2AMLogic/sky130-comparator/README.md

# sky130-comparator

A dynamic latched comparator on SkyWater sky130 on
[SkyWater sky130](https://github.com/google/skywater-pdk), a 130 nm open CMOS PDK — designed by AI agents driving
[klayout-tools](https://github.com/2AMLogic/klayout-tools) and the
open-source xschem + ngspice flow.

fleet burndown

**Status:** designed (`design/comparator.sch`), laid out
(`layout/comparator.gds`) with DRC/LVS evidence, and four of the five spec rows
are ratified; Supply / power remains DRAFT / OPEN. The current frontier is the
post-layout re-measurement campaign
[#125](https://github.com/2AMLogic/sky130-comparator/issues/125), blocked on
the execution route [#127](https://github.com/2AMLogic/sky130-comparator/issues/127).
See the [decision records](spec/decision-records/) (latest ratified:
[DR-006](spec/decision-records/DR-006-post-layout-noise-headroom-reopened.md)),
[`manifests/design-evidence-tiers.md`](manifests/design-evidence-tiers.md), and
[`WORK_PLAN.md`](WORK_PLAN.md); figures live there, not here.

**For integrators:** [`spec/consumers.md`](spec/consumers.md) is the dated
consumer-compatibility record (last refreshed 2026-10-10 against the
DR-004 static-preamp topology and DR-005 ratifications). It distinguishes
ratified bounds, schematic results, and historical post-layout results; no
compatibility claim there covers the current layout geometry, whose
re-measurement is #125.

**Built agent-native.** Every specification, decision record, testbench, and
line of documentation here is produced by AI agents working from a ratified
spec and an append-only evidence trail — not human-authored work that agents
merely assisted with. Verification is the product: every claim traces to a
recorded result under PVT corners. Where the agents hit friction with the
open-source tooling — most often
[klayout-tools](https://github.com/2AMLogic/klayout-tools) — that friction is
filed as a public issue against the tool itself, so the fix benefits everyone
using this PDK, not just this repo.

## Why this block, on this PDK

The sky130 leg of the comparator twin set (see sg13g2-comparator for the
program). sky130-sar-adc embeds a comparator this repo characterizes
standalone; at 1.8 V the StrongARM's stacked devices are headroom-tight,
and the regeneration-speed vs offset trade lands differently than at
3.3 V — which is the comparative result the twins exist to surface.

The statistical story depends on what sky130's models actually ship for
mismatch; establishing that (and committing the answer) was the first
result, same as on SG13G2.

## Target specification

The bounds below are original engineering judgment for the sky130 1.8 V
core flavor, not ported numbers; each row states its basis rather than
asserting a bare figure. See [`spec/porting-plan.md`](spec/porting-plan.md) for what *does*
transfer (testbench structure and methodology, not spec numbers) from
[`sky130-sar-adc`](https://github.com/2AMLogic/sky130-sar-adc)'s embedded
comparator work.

History: [DR-002](spec/decision-records/DR-002-target-spec-ratification.md)
(2026-09-16) ratified three of the five rows below (Offset sigma,
Input-referred noise, Kickback) against a real measurement of this repo's
own `design/comparator.sch`, leaving two **DRAFT / OPEN** at that date; that
count is superseded by the DR-003/004/005 chronology below, and the
current per-row status is the table. No row's numeric
value changed from the original DRAFT figures — DR-002 disposes each row's
*status*, not its bound. See DR-002 for the full per-row reasoning,
including why the Kickback row is ratified as a bound the current design
does **not** meet. [DR-003](spec/decision-records/DR-003-kickback-slew-limited-clock.md)
(2026-09-21, issue #30) is the first kickback-mitigation pass against that
row: a partial improvement (144.60 → 85.71 mV peak at the same measurement
point), with the bound still unmet and the measured alternatives recorded.
[DR-004](spec/decision-records/DR-004-comparator-preamp-supersession.md)
(2026-09-22, issue #34) is the topology-class supersession that closes it: a
static preamplifier ahead of the StrongARM latch, measured **compliant with
the Kickback row at all three graded PVT anchors (1.89 / 1.86 / 1.77 mV at
tt/27 °C, ss/−40 °C, ff/125 °C)** while clearing every other ratified row
and re-anchoring the two DRAFT rows at measured numbers.
[DR-005](spec/decision-records/DR-005-full-corner-campaign.md)
(2026-09-22, issue #41) is the full-corner campaign those records left
open: the remaining four `_mm` mismatch corners plus N=200 offset
campaigns, a regeneration-inclusive noise measurement at three PVT
anchors, the `ff`/`sf`/`fs` decision-time corners, and the `sf`/`fs`
kickback skews — **ratifying the Decision-time row** (four of five rows
now ratified) and recording one new fact against a stretch figure: the
kickback stretch bound (≤ 2 mV) is breached by 1% at `sf`/−40 °C
(2.0208 mV), with the ≤ 5 mV target still cleared at every graded corner.
Only Supply/power remains DRAFT/OPEN.

Every figure above is measured against `design/comparator.sch`'s netlist.
[Issue #57](https://github.com/2AMLogic/sky130-comparator/issues/57) (T1 item
7) is the first pass that re-measures four of them against the
**parasitics-annotated extraction of the committed layout**, at the `tt`/27 °C
anchor plus `ss`/−40 °C for decision time — the standing layout-stage
re-verification gate DR-002's Open items named. **No ratified target bound is
breached, so no row is re-opened or re-ratified by it.** Two rows now sit over
their *stretch* figures, which the per-row notes below state in full rather
than adjust: **Kickback 1.8902 → 2.6767 mV** (≤ 2 mV stretch; ≤ 5 mV target
cleared 1.87×) and **Input-referred noise 0.5704 → 0.6576 mV rms** (≤ 0.6 mV
stretch; ≤ 1.0 mV target cleared 1.52×). Offset sigma degrades 1.7857 →
2.4446 mV (3σ = 7.33 mV, stretch bound still cleared) and decision time 0.4025
→ 0.5325 ns at `tt`/27 °C (both bounds cleared). A single mechanism — a 2.12×
loss of pick-off gain, from parasitic loading on the preamp outputs plus
PR #55's disclosed load-resistor width delta — drives most of it, and two
genuinely new post-layout facts appear: a 0.6547 mV **systematic**
layout-induced offset (exactly 0 on the symmetric schematic netlist) and a
polarity asymmetry in the sub-20 mV decision. That first pass' coverage was
deliberately narrow — two corners, four of the six sub-commands — and
[#64](https://github.com/2AMLogic/sky130-comparator/issues/64),
[#65](https://github.com/2AMLogic/sky130-comparator/issues/65) and
[#80](https://github.com/2AMLogic/sky130-comparator/issues/80) have since
widened it to every graded corner of `kickback`, `regen` and `noise`, all
five `_mm` corners of `offset`, and a post-layout deck form for `reset` and
`noise-tran`; the notes below say which corners remain unmeasured. The
systematic offset term above is now known to be essentially
process-independent (0.6350–0.6874 mV across all five `_mm` corners, #80),
so it is a property of the layout rather than of the `tt_mm` corner. The extraction is pinned to
`klayout-tools==0.8.0` / `klayout==0.30.12` (the pin every other committed
layout envelope carries; this paragraph's figures were measured under
0.6.0 / 0.30.10 on the earlier 0.42 µm-resistor layout and are historical, see
`layout/README.md`), asserted by `layout/extract_pex.py` and gated in CI),
because extracted per-net series resistances are **not** stable across
klt/klayout builds — up to 2.30× apart on this block.

| Parameter | Status | Target | Stretch | Basis |
|---|---|---|---|---|
| Offset sigma | **RATIFIED** (DR-002) | ≤ 15 mV, 3σ (input-referred, post-calibration-free) | ≤ 8 mV, 3σ | Monte Carlo via sky130's `_mm` local-mismatch corners (`tt_mm`/`ss_mm`/`ff_mm`/`sf_mm`/`fs_mm`, `AGAUSS()` per-instance terms — confirmed present in the installed `sky130.lib.spice`). Measured against this repo's own design: N=16 draws at `tt_mm`/27 °C, input-referred offset stdev 2.019 mV (3σ = 6.06 mV), same-seed mismatch-disabled negative control reproduces stdev = 0 exactly (`sim/comparator-decision/records/20260916-003531-52eb9b2.md`). Clears both the target and the stretch bound at this sample size. N=16 is sized for distribution-shape plumbing, not a tight yield-fraction claim (relative standard error on the stdev ≈ 18.3%); the other four `_mm` corners and an O(100s)-draw campaign remain open (DR-002 Open items). Re-measured against the DR-004 topology (issue #34, input pair widened 10 → 13 µm as the noise lever, pick-off re-anchored 1.0 → 0.65 ns for the preamp design's faster separation): stdev **1.7857 mV** (3σ = 5.36 mV), same-seed negative control still exactly 0 (`sim/comparator-decision/records/20260922-065300-e084b55.md`) — both bounds still cleared. sky130-sar-adc's own embedded (non-standalone) comparator, at a first-pass `W = 4 µm` input-pair sizing with no offset-budget target, measured input-referred offset mean 35.24 mV / stdev 97.08 mV across N = 16 draws (`tt_mm`, `sim/comparator-decision/records/` in that repo) — same-PDK prior art on mismatch magnitude at an unoptimized sizing, not a target this repo inherited. The four-corner + large-N coverage DR-002 left open has since landed ([DR-005](spec/decision-records/DR-005-full-corner-campaign.md), issue #41), all at the same seed-1/27 °C methodology with stdev-exactly-0 same-seed negative controls: `ss_mm` **1.8244 mV**, `ff_mm` **1.5954 mV**, `sf_mm` **1.6706 mV**, `fs_mm` **1.8218 mV** (N=16; records `sim/comparator-decision/records/20260922-173622-e23c509.md` … `.../20260922-175152-e23c509.md`) — the corner ranking is within the N=16 relative SE, with `ss_mm` nominally binding, and every corner clears both bounds at 3σ ≈ 4.8–5.5 mV. N=200 campaigns at both `tt_mm` and `ss_mm` (seed 1) replace the relative-SE caveat with a stated 95% CI: `tt_mm` **σ = 2.1854 mV, CI [1.9707, 2.4001]** (`sim/comparator-decision/records/20260922-191034-e23c509.md`), `ss_mm` **σ = 2.2353 mV, CI [2.0157, 2.4549]** (`.../20260922-202434-e026012.md`) — both give 3σ ≈ 6.6–6.7 mV, clearing the stretch bound with the implied yield against it > 99.96% (8 mV / σ ≈ 3.6σ per side). Note the N=200 estimates sit ~22% above the N=16 figure the row previously quoted — the small-sample estimate happened to land low, which is precisely the tightness gap DR-002's Open items flagged. **Post-layout re-verification** ([issue #57](https://github.com/2AMLogic/sky130-comparator/issues/57), T1 item 7 — the first measurement of any row against the parasitics-annotated extraction of `layout/comparator.gds` rather than against the schematic netlist): at the same `tt_mm`/27 °C, N=16, seed-1 anchor the input-referred offset stdev rises 1.7857 → **2.4446 mV** (1.37×, 3σ = 7.3338 mV; `sim/comparator-decision/records/20260925-112809-4694692.md`), with the same-seed mismatch-disabled negative control's stdev still exactly 0. **Both bounds are still cleared** — the stretch bound now with 1.09× margin rather than 1.49× — so the row is not re-opened. Two further post-layout facts belong here. The pick-off gain falls 64.4571 → 30.4600 V/V (2.12×), from parasitic loading on the long `OUTP1`/`OUTN1` nets plus PR #55's disclosed drawn-vs-schematic load-resistor width delta (~19% less load R) — that gain loss is why σ grows, and it is the common cause this row shares with the noise and decision-time rows. And the negative control's *mean*, 0.0000 mV on the symmetric schematic fragment, is **0.6547 mV** post-layout: the first measurement of a **systematic, layout-induced** offset term on this block, which the schematic bench had nothing to measure and which this row's σ-only bounds do not cover. [#64](https://github.com/2AMLogic/sky130-comparator/issues/64)'s corner campaign **deliberately skipped** the other four `_mm` corners and recorded the reason rather than leaving a silent gap (`offset` is the campaign's most expensive sub-command by an order of magnitude — ~37 decks, ~25 min per corner serially — so under that campaign's serial dispatch decision the budget went to the two rows the layout was expected to move, `kickback` and `regen`). **[#80](https://github.com/2AMLogic/sky130-comparator/issues/80) has since run them, and post-layout coverage of this row is now 5 of 5 `_mm` corners**, all at the same 27 °C / N=16 / seed-1 anchor, each with its same-seed mismatch-disabled negative control reproducing stdev **exactly 0**: `ss_mm` **2.4133 mV** (3σ = 7.2400), `ff_mm` **2.4796 mV** (3σ = 7.4388), `sf_mm` **2.4794 mV** (3σ = 7.4381), `fs_mm` **2.4078 mV** (3σ = 7.2235) — records `sim/comparator-decision/records/20260926-022304-5b02508.md`, `.../20260926-032735-85c288e.md`, `.../20260926-034704-dfaee77.md`, `.../20260926-041419-38f6227.md`. **The ≤ 15 mV target bound is cleared at every corner (worst case 2.02×) and the ≤ 8 mV stretch figure is also still cleared everywhere (worst case 1.08×, at `ff_mm`), so the row is not re-opened and no decision record is filed.** The finding is that **the layout collapses this row's corner spread**: schematic-level the five corners span 14.4% (1.5954–1.8244 mV, `ss_mm` nominally binding); post-layout they span **3.0%** (2.4078–2.4796 mV). Two readings follow, and the second is the load-bearing one. First, the schematic-level ranking does not survive layout — `ss_mm`, the corner this work was filed to check, is now *second-lowest*, and `ff_mm`, the lowest schematic corner, is highest. Second, **that 3.0% spread sits far inside this sample size's own 18.3% relative SE, so the five post-layout corners are statistically indistinguishable and no binding corner is resolvable at N=16 at all** — separating them needs the O(100s)-draw post-layout campaign, which remains open and was explicitly out of #80's scope. The *ratios* are better determined (they are paired — same seeds, same draws, only the DUT fragment differs) and span **1.322×–1.554×**, largest exactly where the schematic figure was *smallest* (`ff_mm`) and smallest where it was largest (`fs_mm`, `ss_mm`). That is a third distinct corner shape: `kickback`'s post-layout penalty was largest at the corner already worst pre-layout (reinforcing), `regen`'s largest hot, `offset`'s largest where the schematic figure was best (compressing) — so no row's PVT shape can be inferred from another's. It is also **not** a gain-loss ordering: `ff_mm`/`sf_mm` retain the *most* pick-off gain post-layout (35.7356 / 35.9542 V/V, losses of only 1.81× / 1.84×) yet carry the *largest* offset ratios, while `fs_mm`/`ss_mm` lose the most gain (2.37× / 2.07×) and carry the smallest — so the 2.12× gain loss remains the mechanism for the `tt_mm` *level* but not for the corner-to-corner ordering. Finally, the **systematic** layout-induced term (the negative control's mean, exactly 0 on the symmetric schematic fragment) is non-zero at every corner and spans only **0.6350–0.6874 mV (8.3%)** across all five — essentially process-independent, which makes the 0.6547 mV figure the noise and decision-time rows already lean on representative of the whole `_mm` set rather than a `tt_mm` artifact. This row's bounds are stated on σ only and do not cover that term at any corner; quantifying it properly is tracked as [#66](https://github.com/2AMLogic/sky130-comparator/issues/66). A large-N post-layout campaign remains genuine open work. **#66 has since measured the decision-referred quantity directly** (`run.py offset-bisect`, bisecting the vindiff at which the decision flips polarity, 200 ns window, schematic fragment as the ~0 negative control): the extracted DUT's decision flips at **+1.8359 mV** at the plain `tt`/27 °C corner (this measurement's axis — `_mm` mismatch, this row's σ axis, is not involved) against the schematic fragment's **−0.0391 mV** — a **+1.875 mV layout-induced systematic decision offset**, *not* the same number as this row's 0.6547 mV pick-off-referred negative-control mean (the pick-off reads the preamp stage at 0.65 ns; the decision sees the whole regenerative trajectory; the two methods disagree 2.8× in the same direction, and both are correct for what they measure). At `ss`/−40 °C the extracted DUT has **no decision flip at all** — a 28.2422 mV non-decision band [−8.2715, +19.9707] mV where the schematic fragment's own band is symmetric ±0.8203 mV — so no offset, systematic or random, is the right model for that corner's sub-28 mV behavior (records `sim/comparator-decision/records/20261002-000502-e2b808c.md`, `.../20261002-002613-e2b808c.md`, `.../20261002-003713-e2b808c.md`, `.../20261002-004906-e2b808c.md`). [DR-007](spec/decision-records/DR-007-systematic-decision-offset-row.md) **proposes** — changes nothing yet — a companion "Systematic decision offset" row (target ≤ 2 mV / stretch ≤ 5 mV) so the deterministic term has a line to be graded against; this σ-only row is untouched by that proposal. |
| Input-referred noise | **RATIFIED** (DR-002); target-bound compliance basis **RE-OPENED** post-layout by [DR-006](spec/decision-records/DR-006-post-layout-noise-headroom-reopened.md) and **RE-CLOSED** by that record's **Amendment 1** (issue #83) on the regeneration-inclusive `fs`/125 °C measurement. The ≤ 0.6 mV stretch figure stays recorded as breached at four of seven corners on the AC basis (DR-006 Decision 4, unchanged) | ≤ 1.0 mV rms, differential | ≤ 0.6 mV rms, differential | ngspice `.noise` analysis on a reduced (loop-broken) sub-model of the latch's input pair + tail (methodology per sky130-sar-adc's `spec/decision-records/DR-004-comparator-topology-and-noise-budget.md`, documented there as excluding regeneration-phase noise — a lower bound, not a complete figure). Measured against this repo's own design: 0.4466 mV rms differential (estimated) at `tt`, 27 °C (`sim/comparator-decision/records/20260916-001416-52eb9b2.md`) — clears the 1.0 mV target with ~2.24× margin even as a lower bound; the 0.6 mV stretch bound has less margin (1.34×) and is the more likely candidate to be revisited once regeneration-inclusive noise is measured (DR-002 Open items). Full regeneration-inclusive noise and a PVT sweep remain open. Re-measured against the DR-004 topology (issue #34) on a re-derived sub-model that is the REAL static preamp stage verbatim (not the pre-DR-004 integration-phase proxy): **0.5704 mV rms differential** at `tt`/27 °C (`sim/comparator-decision/records/20260922-065534-e084b55.md`) — target cleared with 1.75× margin and the 0.6 mV stretch bound now cleared with 1.05× margin (the first-cut preamp sizing measured 0.72 mV, over stretch; the widened input pair and raised bias closed it, with the coupling of the noise/speed/kickback levers through the preamp bias recorded as a DR-004 consequence). sky130-sar-adc's DR-004 measured 0.7064 mV rms differential (estimated) for its own embedded-comparator sizing at `tt`, 27 °C — same-PDK, same-supply prior art, not a ported spec value. The regeneration-inclusive measurement DR-002 left open has since landed ([DR-005](spec/decision-records/DR-005-full-corner-campaign.md), issue #41, `run.py noise-tran` — transient-noise Monte Carlo with equivalent-source injection, since ngspice-46 has no device-noise transient): decision-referred input sigma **0.1362 mV** at `tt`/27 °C (95% CI [0.1216, 0.1493]; `sim/comparator-decision/records/20260922-192722-e23c509.md`), **0.1213 mV** at `ss`/−40 °C (CI [0.1084, 0.1335]; `.../20260922-205857-ebea4e2.md`), and **0.1754 mV** at `ff`/125 °C (CI [0.1594, 0.1905]; `.../20260923-010427-ebea4e2.md`). At `tt` and `ff` an independent decision-transition cross-check agrees with the pick-off figure within its coarser CI (0.1342 / 0.1515 mV) — the evidence that the regenerative phase adds no material noise term beyond the injected device noise; at `ss`/−40 the cross-check is honestly not measurable (the sigma-scaled overdrives sit below that corner's resolvable-overdrive floor, the same floor DR-004 recorded) — itself the statement that noise does not bound decisions at that corner. The decision-referred figures sit ~3–4× below the 1 kHz–1 GHz band-integrated AC figures because the decision sees the circuit's own bandwidth, not the integration band; the AC numbers remain the row's conservative reported basis and no bound changes. **Post-layout re-verification** ([issue #57](https://github.com/2AMLogic/sky130-comparator/issues/57), T1 item 7): the identical loop-broken AC sub-model, taken as the preamp partition of the *extracted* netlist (`layout/comparator.pex-preamp.spice`) with its lumped-RC parasitics, measures **0.6576 mV rms differential** at `tt`/27 °C — 1.15× the schematic figure (`sim/comparator-decision/records/20260925-112827-4694692.md`). The ≤ 1.0 mV target is cleared with 1.52× margin; **the ≤ 0.6 mV stretch bound is breached by 10%**. Per `CLAUDE.md` that is recorded, not legislated away — no bound is changed, and the row is not re-opened because the ratified *target* bound is met. The mechanism is the 2.12× pick-off-gain loss noted on the Offset sigma row: less preamp gain refers the same output-side noise back to a larger input-referred figure. The regeneration-inclusive `noise-tran` number has **no** post-layout counterpart — that sub-command refuses `--dut extracted` rather than silently measuring the schematic DUT (see `sim/comparator-decision/README.md` for why its deck construction has no post-layout form yet), so the decision-referred 0.1362 / 0.1213 / 0.1754 mV figures above remain schematic-only ([#65](https://github.com/2AMLogic/sky130-comparator/issues/65)). **The full-corner post-layout AC campaign has since landed** ([#64](https://github.com/2AMLogic/sky130-comparator/issues/64)), and it is the finding that matters most on this row. All seven graded corners, extracted netlist, same loop-broken AC sub-model: **`sf`/−40 °C 0.4886, `ss`/−40 °C 0.5429, `fs`/−40 °C 0.5447, `tt`/27 °C 0.6576, `ff`/125 °C 0.8521, `sf`/125 °C 0.8590, `fs`/125 °C 0.9423 mV rms** (records `sim/comparator-decision/records/20260925-192745-bec714a.md`, `.../20260925-192710-bec714a.md`, `.../20260925-192818-bec714a.md`, `.../20260925-112827-4694692.md`, `.../20260925-192728-bec714a.md`, `.../20260925-192801-bec714a.md`, `.../20260925-192836-bec714a.md`). The ≤ 1.0 mV **target bound is still cleared at every corner** and the ≤ 0.6 mV stretch figure is breached at the four warmest. **But at `fs`/125 °C the target margin is only 1.06×, on a figure this methodology states is a *lower* bound** — and that retires the specific argument DR-002 §2 ratified this row on. DR-002 reasoned that the excluded regeneration-phase term would have to reach ~0.90 mV rms to threaten the target; from 0.9423 mV rms it now needs only **0.335 mV rms** in quadrature. Per `CLAUDE.md` no bound is changed and nothing is relaxed, but the row's *compliance basis* is re-opened by [DR-006](spec/decision-records/DR-006-post-layout-noise-headroom-reopened.md): the bound stays ratified, the claim that the evidence establishes compliance with it does not, and what would close it again is a **regeneration-inclusive post-layout** measurement — post-layout `noise-tran`, which now **has** a deck form ([#65](https://github.com/2AMLogic/sky130-comparator/issues/65) built one and ran it) but not yet a run at the corner that binds this row. Its first post-layout figure is at `tt`/27 °C: decision-referred input sigma **0.1448 mV** (N=64 pick-off seeds, 95% CI [0.1224, 0.1641]; `sim/comparator-decision/records/20260925-214740-81f594b.md`) against the schematic-level 0.1362 mV — a 1.06× ratio that sits **inside** that CI, so it establishes the post-layout figure and its uncertainty and does **not** establish that this quantity moved with the layout. It does **not** close DR-006, whose stated closure condition is this same measurement at `fs`/125 °C — the corner that binds the row, and where the excluded term's quadrature headroom is the 0.335 mV computed above. What #65 changed is that the closing run is now a scheduling question rather than a missing capability. One further finding from that record: the decision-transition cross-check is **degenerate** post-layout — all 64 decision seeds resolved and all resolved the *same way* at *both* signs of a ±0.109/±0.217 mV overdrive, which is a deterministic term, not noise (the 0.6547 mV input-referred systematic offset on the Offset sigma row above, 3–6× those overdrives), making this independent evidence for the sub-20 mV polarity asymmetry tracked as [#66](https://github.com/2AMLogic/sky130-comparator/issues/66). Note also that the hot corners bind this row (~1.9× worse at 125 °C than at −40 °C), which a `tt`/27 °C-only basis could not have revealed. **DR-006's closure condition has since run** ([#83](https://github.com/2AMLogic/sky130-comparator/issues/83)): post-layout `noise-tran` **at `fs`/125 °C**, regeneration-inclusive, decision-referred input sigma **0.2540 mV rms differential** (N=32 pick-off seeds, 95% CI [0.1961, 0.3009]; `sim/comparator-decision/records/20260926-055806-3034c41.md`). That **clears the ≤ 1.0 mV target with 3.94× margin — 3.32× read at the CI's upper bound**, which is how the smaller-than-usual N is handled — and DR-006 Amendment 1 accordingly moves the row's target-bound compliance basis back to RATIFIED-and-clear: the row no longer rests on a lower bound plus a headroom argument, but on a direct regeneration-inclusive measurement at the binding corner. Stated two ways so the closure does not rest on one arithmetic: even under a deliberately indefensible double-count — adding the *entire* measured figure in quadrature on top of the same corner's 0.9423 mV AC lower bound, which double-counts because both are dominated by the same preamp input-referred source — `sqrt(0.9423² + 0.2540²) = ` 0.9759 mV rms is *still* inside the target (1.025×; 0.9892 mV / 1.011× at the CI's upper bound). DR-006's own 0.335 mV quadrature allowance is likewise not exceeded (0.2540 mV is 0.76× of it). **Three things this does not do**, and they are the honest limits: the AC lower bound at `fs`/125 °C is unchanged at 0.9423 mV / 1.06× margin, so any statement citing *that* figure as the basis still carries that qualifier; the ≤ 0.6 mV **stretch** figure stays recorded as breached at four of seven corners on the AC basis even though the transient basis clears it at both of its two corners (the two bases disagree, the transient basis has 2 of 7 corners, and per `CLAUDE.md` the breach record stands rather than being erased by a different method's number); and five graded corners remain unmeasured post-layout for `noise-tran`. One finding worth carrying: the regeneration-inclusive figure is **resolvably** worse at `fs`/125 °C than at `tt`/27 °C — 0.2540 vs 0.1448 mV, 1.754×, with **non-overlapping** 95% CIs — so the "hot corners bind this row" shape is now confirmed on the regeneration-inclusive basis rather than inferred from the lower bound, and it degrades *faster* with corner than the AC sub-model's own 1.433×. **Post-layout `noise-tran` coverage has since gone 2 → 4 of 7 graded corners** ([#89](https://github.com/2AMLogic/sky130-comparator/issues/89)): `ss`/−40 °C **0.1382 mV** (N=32, CI [0.1046, 0.1666]; `sim/comparator-decision/records/20260926-110218-b64004b.md`) and `ff`/125 °C **0.1956 mV** (N=32, CI [0.1606, 0.2212]; `.../20260926-102605-b64004b.md`), both clearing the ≤ 1.0 mV target by more than 5× even at their CI upper bounds, so **DR-006's disposition is unchanged** — this is coverage, not basis. These are the only two of the five then-remaining corners with a committed schematic-level counterpart to difference against, and they can difference against it only because #89 also fixed `run.py`'s `SCHEMATIC_BASELINES`, which carried a `noise-tran` anchor at `tt`/27 °C alone and would have made both records print "no committed counterpart" while one sat in `records/`. The resulting ratios are **1.139×** and **1.115×**, joining `tt`/27 °C's 1.063×: at all three the schematic value sits *inside* the post-layout CI, so **no individual ratio is resolved** — what three-of-three above 1 in a 1.06–1.14× band adds is a consistent *sign* (one-sided sign-test p = 0.125), not a measurement of the layout penalty. Resolving it needs N, not more corners. One further finding: `ff`/125 °C is the **first post-layout corner whose decision-transition cross-check is measurable** (0.2175 mV against the same record's 0.1956 mV pick-off figure, agreeing to 11%), which is what makes the degenerate all-one-way cross-checks at `tt`/27 °C and `fs`/125 °C readable as the 0.6547 mV systematic term of #66 rather than as a post-layout failure of the method. Three graded corners (`sf`/−40 °C, `sf`/125 °C, `fs`/−40 °C) remain unmeasured post-layout; none has a schematic-level counterpart. |
| Decision time vs. overdrive | **RATIFIED** (DR-005; open since DR-002, anchored by DR-004) | ≤ 1.5 ns at 50 mV overdrive, 1.8 V | ≤ 0.8 ns at 50 mV overdrive | Transient regeneration-time sweep vs. differential input, methodology mirroring sky130-sar-adc's `sim/comparator-decision/run.py` `regen` subcommand. Measured against this repo's own design at two points: 0.6775 ns at `tt`/27 °C and 0.6875 ns at `ss`/−40 °C (the corner this row's own basis, and DR-001's headroom probe, flagged as the expected binding case), both at 50 mV overdrive (`sim/comparator-decision/records/20260916-000727-52eb9b2.md`, `.../20260916-001345-52eb9b2.md`) — both points clear the stretch bound, not just the target, with almost no slow/cold penalty. [DR-002](spec/decision-records/DR-002-target-spec-ratification.md) leaves this row explicitly open rather than ratifying from two points: `ff`/`sf`/`fs` corners and the sub-50-mV overdrive shape off the `tt`/`ss` axis are unmeasured. Re-anchored at the DR-004 topology's numbers (issue #34): **0.4025 ns @ 50 mV at `tt`/27 °C** (8/8 sweep points resolved, down to 1.1375 ns @ 0.5 mV; `sim/comparator-decision/records/20260922-070800-e084b55.md`) and **0.3575 ns @ 50 mV at `ss`/−40 °C** (`.../20260922-071313-e084b55.md`) — ~2.9× faster than the DR-003 design at the same point. That ss/−40 °C record is honestly 7/8: the 0.5 mV point no longer resolves there (a 400 ns probe confirms it never regenerates, vs 2.5575 ns for the DR-001 design) — sub-mV decisions sit below the design's own ~1.8 mV offset floor in practice, and the row's bounds are stated at 50 mV, but the regression is recorded in DR-004's Consequences and Open items rather than hidden. sky130-sar-adc's embedded comparator measured 0.5325–1.3975 ns across a 0.5–50 mV differential sweep (`tt`, 27 °C) — same-PDK, same-rail prior art, not a ported number. The full PVT sweep DR-002 left open has since landed ([DR-005](spec/decision-records/DR-005-full-corner-campaign.md), issue #41): **`ff`/125 °C 0.4975 ns, `sf`/−40 °C 0.3475 ns, `sf`/125 °C 0.4725 ns, `fs`/−40 °C 0.3725 ns, `fs`/125 °C 0.5375 ns** at 50 mV overdrive (records `sim/comparator-decision/records/20260922-175252-e23c509.md`, `.../20260922-175425-e23c509.md`, `.../20260922-175554-e23c509.md`, `.../20260922-175734-e23c509.md`, `.../20260922-175918-e23c509.md`; 8/8 sweep points resolve at every new corner). Seven PVT points now span the set; the slowest (`fs`/125 °C, 0.5375 ns) clears the stretch bound with 1.49× margin and the target with 2.8× — DR-005 **ratifies this row** at the DR-002-stated bounds unchanged, with the one non-resolving point in the whole set still the `ss`/−40 °C 0.5 mV point DR-004 recorded. **Post-layout re-verification** ([issue #57](https://github.com/2AMLogic/sky130-comparator/issues/57), T1 item 7): against the extracted netlist, 50 mV overdrive measures **0.5325 ns at `tt`/27 °C** and **0.4725 ns at `ss`/−40 °C** — 1.32× the schematic figure at both anchors (records `sim/comparator-decision/records/20260925-085247-4694692.md`, `.../20260925-093624-4694692.md`). **Both still clear the ≤ 0.8 ns stretch bound (1.50× / 1.69×) and the ≤ 1.5 ns target (2.82× / 3.17×)**, so this row stands as ratified. Below 20 mV the picture changes, and is recorded rather than smoothed: `tt`/27 °C now resolves 6/8 sweep points (+1 mV and +0.5 mV no longer do, against 8/8 schematic-level) and `ss`/−40 °C resolves 3/8 (+2, +5 and +10 mV do not, while −10 mV resolves in 2.3725 ns) — i.e. the layout introduces a **polarity asymmetry** in the sub-20 mV decision that the symmetric schematic netlist does not have. `regen`'s criterion is sign-corrected, so a wrong-polarity decision and a genuine non-decision both read `UNRESOLVED`; this evidence brackets the asymmetry (between 1 and 2 mV at `tt`/27 °C, between 10 and 20 mV at `ss`/−40 °C) but cannot separate the two mechanisms, and the 0.6547 mV systematic term measured on the Offset sigma row does not account for the `ss`/−40 °C magnitude on its own. Quantifying it is follow-on work ([#66](https://github.com/2AMLogic/sky130-comparator/issues/66)); this row's bounds are stated at 50 mV overdrive, which resolves at both anchors. **The full-corner post-layout campaign has since landed** ([#64](https://github.com/2AMLogic/sky130-comparator/issues/64)): all seven graded corners are now measured against the extracted netlist at 50 mV overdrive — **`ff`/125 °C 0.6475 ns, `sf`/−40 °C 0.4425 ns, `sf`/125 °C 0.6375 ns, `fs`/−40 °C 0.4875 ns, `fs`/125 °C 0.7725 ns** (records `sim/comparator-decision/records/20260925-175622-bec714a.md`, `.../20260925-192610-bec714a.md`, `.../20260925-182949-bec714a.md`, `.../20260925-185950-bec714a.md`, `.../20260925-173228-bec714a.md`). **The ≤ 1.5 ns target is cleared at every corner** (worst case `fs`/125 °C, 1.94×), and **the ≤ 0.8 ns stretch bound is also still cleared at every corner — but at `fs`/125 °C with only 1.04× margin (0.7725 ns against 0.8 ns)**. This row therefore stands as ratified, with that thin stretch margin flagged rather than smoothed over. The post-layout penalty is corner-dependent (1.273×–1.437×) and is largest at the **hot** corner, where the Kickback row's penalty is largest at the **cold** corners — the two rows do not share a worst corner, so neither row's PVT shape can be inferred from the other's. The sub-20 mV resolution loss also deepens at the cold skews: 8/8 sweep points resolve at `ff`/125 °C, 7/8 at both 125 °C skews, and **5/8 at both −40 °C skews**, localising the polarity-asymmetry bracket to between 2 and 5 mV there ([#66](https://github.com/2AMLogic/sky130-comparator/issues/66)); both bounds are stated at 50 mV overdrive, which resolves at every corner. **#66 has since resolved the bracketed question, and the answer differs by corner**: `regen` now classifies both output signs, and the new `offset-bisect` sub-command bisected the decision boundary. At `tt`/27 °C the non-resolving +0.5/+1 mV points were **wrong-polarity decisions** — a layout-induced systematic decision offset of **+1.875 mV** (extracted flip +1.8359 mV vs. the schematic fragment's −0.0391 mV negative control; records `20261001-232150-e2b808c.md`, `20261002-000502-e2b808c.md`, `20261002-003713-e2b808c.md`). At `ss`/−40 °C the non-resolving +0.5…+10 mV points were **genuine non-decisions** — no decision boundary exists, only a 28.2422 mV non-decision band [−8.2715, +19.9707] mV against the schematic fragment's symmetric ±0.8203 mV band at the same corner (records `20261001-232341-e2b808c.md`, `20261002-002613-e2b808c.md`, `20261002-004906-e2b808c.md`) — the layout widens that corner's intrinsic decision floor 17.2× and shifts it +5.85 mV off center. Neither finding touches this row's bounds at their stated 50 mV overdrive; [DR-007](spec/decision-records/DR-007-systematic-decision-offset-row.md) proposes the companion systematic-offset row and records the band as a stated limitation of sub-20 mV post-layout decisions at `ss`/−40 °C. |
| Kickback | **RATIFIED (bound); design COMPLIANT at all three graded PVT anchors** (DR-002; pass 1: DR-003; topology pass: DR-004) | ≤ 5 mV disturbance into a 1 kΩ source impedance at the input nodes, single decision edge | ≤ 2 mV | No sky130 same-PDK comparator evidence existed for kickback specifically before this repo's own original testbench (issue #26, `python3 sim/comparator-decision/run.py kickback`, since sky130-sar-adc's `sim/comparator-decision/` does not include a kickback experiment either) — this bound was first-principles engineering judgment (comparable order-of-magnitude to sg13g2/gf180 twin bounds once those are drafted). That testbench's first nominal-corner (`tt`, 27 °C) measurement, at `design/comparator.sch`'s current sizing and the stated 1 kΩ source impedance, is 144.60 mV peak — ~29× the target and ~72× the stretch bound (`sim/comparator-decision/records/20260916-060139-f1eb978.md`). [DR-002](spec/decision-records/DR-002-target-spec-ratification.md) **ratifies this bound unchanged** rather than relaxing it to match the measurement (per `CLAUDE.md`: "agents do not relax the ratified spec to make results pass") and documents the current sizing as non-compliant against it; a mitigation design pass (candidate directions: reducing the offset-driven input-pair `Cgd`, dummy/compensation switches, bootstrapped/slew-limited clocking) is recommended as follow-on work, not performed by DR-002 itself. That pass has since happened: [DR-003](spec/decision-records/DR-003-kickback-slew-limited-clock.md) (issue #30) designs, measures, and lands a ~250 ps RC soft-clock shaper (`R_CLKS` + `M_CLKCAP` → internal node `CLKT` driving all five clocked gates, stretching the whole evaluate onset) — the measured candidate-mitigation series is recorded there with numbers, including why the input-isolation and charge-cancellation families were rejected (ratified-noise-row and decision-time regressions). Post-mitigation re-measurement at the same `tt`/27 °C, 1 kΩ, 50 mV overdrive point: **85.71 mV peak** (`sim/comparator-decision/records/20260921-185208-bb32850.md`, whose `ideal` negative control still collapses to 0.0000 mV) — a 40.7% reduction, still ~17× the target and ~43× the stretch bound, so the row's non-compliance annotation stands rather than being quietly flipped; full compliance is documented as requiring the preamplifier/double-tail topology class [DR-001](spec/decision-records/DR-001-comparator-topology.md) explicitly scoped out. That topology pass has since landed: [DR-004](spec/decision-records/DR-004-comparator-preamp-supersession.md) (issue #34) supersedes DR-001's no-preamp clause with a static resistive-load preamplifier ahead of the StrongARM latch (the double-tail route was evaluated first and measured still ~1:1 elastic — 7.5 mV @ 0.77 ns, probe deck committed under `spec/dr-004-support/`). Re-measurement at the identical tt/27 °C methodology point: **1.8902 mV peak** (`sim/comparator-decision/records/20260922-070119-e084b55.md`), with the PVT anchors ss/−40 °C at **1.8605 mV** (`.../20260922-070212-e084b55.md`) and ff/125 °C — the corner where the DR-003-era isolation candidate breached — at **1.7677 mV** (`.../20260922-070307-e084b55.md`); every `ideal` control still collapses to 0.0000 mV. All three anchors clear both the target (2.65–2.83× margin) and the stretch bound (1.06–1.13×); the stretch margin is thin and PVT-bracketed, and DR-002's standing layout-stage re-verification requirement remains the gate before any silicon claim. The `sf`/`fs` skew corners at both temperature extremes complete the row's PVT set ([DR-005](spec/decision-records/DR-005-full-corner-campaign.md), issue #41): **`sf`/−40 °C 2.0208 mV, `sf`/125 °C 1.7837 mV, `fs`/−40 °C 1.8408 mV, `fs`/125 °C 1.6091 mV** (records `sim/comparator-decision/records/20260922-180026-e23c509.md` … `.../20260922-180425-e23c509.md`; every `ideal` control still collapses to 0.0000 mV). All seven graded corners clear the ≤ 5 mV target with 2.5–3.1× margin; the ≤ 2 mV **stretch** bound is breached by 1% at exactly one corner — `sf`/−40 °C, 2.0208 mV — recorded by DR-005 rather than legislated away (the stretch figure is not a compliance requirement and is unchanged). **Post-layout re-verification** ([issue #57](https://github.com/2AMLogic/sky130-comparator/issues/57), T1 item 7) — this is the row DR-002/DR-005 named as the standing layout-stage gate before any silicon claim, because its governing mechanism (input-node parasitic capacitance) is exactly what layout adds: at the identical `tt`/27 °C, 1 kΩ, 50 mV methodology point the extracted netlist measures **2.6767 mV** peak, 1.42× the schematic 1.8902 mV (`sim/comparator-decision/records/20260925-094700-4694692.md`; both pins rise by a similar absolute amount, VINP 0.6668 → 1.4696 mV and VINN 1.8902 → 2.6767 mV, and the `ideal` zero-impedance control still collapses to exactly 0.0000 mV, so the deck is still isolating a genuine source-impedance-dependent effect). **The ≤ 5 mV target is cleared with 1.87× margin; the ≤ 2 mV stretch figure is breached by 34%** — a real widening of the 1% schematic-level breach DR-005 recorded at `sf`/−40 °C, and in the direction `layout/README.md`'s floorplan section predicted. Per `CLAUDE.md` this is recorded, not legislated away: no bound is changed and the row is **not** re-opened, because the ratified *target* bound is met and the stretch figure is not a compliance requirement. **The full-corner post-layout campaign has since landed** ([#64](https://github.com/2AMLogic/sky130-comparator/issues/64)): all seven graded corners are now measured against the extracted netlist — **`ss`/−40 °C 2.7564 mV, `ff`/125 °C 2.2985 mV, `sf`/−40 °C 3.1989 mV, `sf`/125 °C 2.3443 mV, `fs`/−40 °C 2.6795 mV, `fs`/125 °C 1.9558 mV** (records `sim/comparator-decision/records/20260925-165936-45f0767.md`, `.../20260925-170317-45f0767.md`, `.../20260925-165719-45f0767.md`, `.../20260925-165748-45f0767.md`, `.../20260925-165825-45f0767.md`, `.../20260925-165858-45f0767.md`; every `ideal` zero-impedance control still collapses to exactly 0.0000 mV). **The ≤ 5 mV target bound is cleared at every one of the seven corners**, worst case `sf`/−40 °C with 1.56× margin — so this row stands as ratified and is **not** re-opened. The ≤ 2 mV stretch figure is breached at six of seven corners (by 60% at `sf`/−40 °C); `fs`/125 °C at 1.9558 mV is the only corner that still meets it. Recorded, not legislated away — the stretch figure is unchanged and is not a compliance requirement. The campaign's substantive finding is about the *ratio*: the post-layout penalty is **not a corner-independent constant**. It ranges 1.215×–1.583× and is systematically larger at the cold corners (`sf`/−40 °C 1.583×, `ss`/−40 °C 1.482×, `fs`/−40 °C 1.456×) than the hot ones (`fs`/125 °C 1.215×, `ff`/125 °C 1.300×, `sf`/125 °C 1.314×), so the layout penalty and the schematic-level worst case **reinforce rather than cancel** — the corner that was already worst pre-layout is also the one the layout degrades most. Scaling the `tt`/27 °C ratio onto `sf`/−40 °C would have predicted ~2.7 mV against the 3.1989 mV actually measured (18% low), which is why this row needed measuring at every corner rather than extrapolating from one. |
| Supply / power | **DRAFT / OPEN** (DR-002 — no measurement exists) | 1.8 V ±10% core supply (`nfet_01v8`/`pfet_01v8`); ≤ 50 µW average, one decision per clock edge at a stated clock rate (TBD) | ≤ 20 µW average | sky130 ships no complementary 3.3 V enhancement device pair (only `nfet_03v3_nvt`, a native NMOS with no PMOS partner) — confirmed against the installed `sky130_fd_pr` model library, per sky130-sar-adc's `spec/decision-records/DR-001-supply-flavor-scope.md`. The 1.8 V core flavor is therefore the only complementary-CMOS option at this node, consistent with `CLAUDE.md`'s "1.8 V headroom is the design constraint" (this half of the row is not in question). Power figures are still first-principles engineering judgment with no current/power measurement behind them; the clock rate this bound assumes is TBD and downstream of the still-open Decision-time row above, so [DR-002](spec/decision-records/DR-002-target-spec-ratification.md) leaves this row open rather than ratifying a bound with no evidentiary basis. First-ever current measurements landed with [DR-004](spec/decision-records/DR-004-comparator-preamp-supersession.md) (issue #34), whose preamplifier class costs static current by construction: ~51–55 µA in reset and ~344–564 µA during evaluate (tt/27 °C, ss/−40 °C, ff/125 °C; `spec/dr-004-support/evaluate_idd_probe.spice`) — i.e. ~95 µW static at 1.8 V, above this row's DRAFT 50 µW figure, plus a duty-cycle-dependent evaluate term. The row's "one decision per clock edge" framing predates any preamp and is superseded in substance; its re-anchoring is deliberately left as an open ratification decision (DR-004 Open items) — the DRAFT figures above are NOT changed by that record. |

**Statistical basis, stated once for the table.** sky130's `_mm` local-mismatch
corners enable real per-instance `AGAUSS()` device-mismatch terms (not a
global-process-only fallback) — the "strong" statistical story named in
`CLAUDE.md`'s "Statistical basis first" principle is available on this PDK,
and is now exercised (not merely planned) against this repo's own design,
per the ratified Offset sigma row above.

**Ratification status.** Per-row status lives in the table above and is not
restated here. The rows were ratified by decision record:
[DR-002](spec/decision-records/DR-002-target-spec-ratification.md) (Offset
sigma, Input-referred noise, Kickback) and
[DR-005](spec/decision-records/DR-005-full-corner-campaign.md) (Decision time
vs. overdrive); Supply / power is the only row still **DRAFT / OPEN**
(tracked by [#134](https://github.com/2AMLogic/sky130-comparator/issues/134)).
No row's numeric bound changed from the original DRAFT figures.
`spec/README.md` documents when a DR is required (whenever this table is set,
changed, or scoped) and how to write one. See issue
[#3](https://github.com/2AMLogic/sky130-comparator/issues/3) for the honest
gap-to-T1 checklist this table's ratification status feeds.

## License

Apache-2.0.
