2AMLogic/sky130-comparator/sim/comparator-decision/klt-pilot/err-ideal.txt

klt: warning: 2 installs provide PDK variant 'sky130A'; read /home/ubuntu/.ciel (search root: ~/.ciel), skipped /home/ubuntu/.volare (search root: ~/.volare). Resolution is first-match-wins, so a pinned open_pdks build may not be the one this run read -- pin the root explicitly (--pdk-root, or a request's models.pdk_root) to disable the search and choose deliberately.
klt: batch job klt-sim-11100bd3d0e7 submitting to s3://<bucket>/jobs/klt-sim-11100bd3d0e7
klt sim: batch job klt-sim-11100bd3d0e7: submitted
klt sim: batch job klt-sim-11100bd3d0e7 launched; re-attach with `klt sim <request> --backend batch --attach klt-sim-11100bd3d0e7`
klt sim: batch job klt-sim-11100bd3d0e7 state=no status.json yet elapsed=1s
klt sim: batch job klt-sim-11100bd3d0e7: running
klt sim: batch job klt-sim-11100bd3d0e7 state=running elapsed=32s
klt sim: batch job klt-sim-11100bd3d0e7: done
