2AMLogic/sky130-comparator/sim/comparator-decision/records/20261002-002613-e2b808c.md

# Record 20261002-002613-e2b808c

- **Record ID**: 20261002-002613-e2b808c
- **Claim**: None by itself -- top-level README target-spec rows are graded by their ratifying decision record, and per DR-002 (2026-09-16, merged) the Offset sigma, Input-referred noise, and Kickback rows are RATIFIED while per DR-005 (2026-09-22, this campaign's record) Decision time vs. overdrive is RATIFIED and only Supply/power stays DRAFT/OPEN. What this record characterizes is **this repo's own comparator**: `design/comparator.sch`, the DR-004 static-preamplifier + StrongARM-latch topology (superseding DR-001's no-preamp scoping) with the DR-003 soft-clock shaper still on the clock port, at a sizing derived from this PDK's own mismatch models (see the schematic's sizing-rationale block, DR-001 Amendment 1, DR-003, DR-004, and DR-005). Any statement about a ratified row's compliance made below cites the bound and the number side by side.
- **Netlist provenance**: schematic-derived (`design/comparator.sch` -> `./design/netlist.sh` -> `sim/comparator-decision/testbench/comparator_core.spice`)
- **Corner matrix run**: process=['ss'], temperature_c=[-40.0], supply_v=[1.8] (1 PVT point -- **subset-corner justification**: single-point characterization of this repo's own design at the stated corner, per issue #24's acceptance criteria; a full ratified PVT corner sweep and Monte Carlo campaign remain open work, blocked on the top-level README target-spec table's ratification -- see issue #3 item 5 and DR-001's 'A full PVT sweep' open item)
- **Stimulus**: single reset(5.0ns, CLK=0)->evaluate(CLK=1.8V) edge per probe (not a repeating clock); decision threshold |v(outp)-v(outn)| > 0.9V (0.5*VDD), BOTH signs classified; evaluate window 200.0ns; Vcm=0.9V; bisection tolerance 0.1 mV
- **Note**: Decision-referred systematic offset, schematic fragment at ss/-40C -- the cold-corner leg of the negative control for issue #66's offset-bisect measurement: the symmetric netlist must place the decision flip at ~0 by construction, at the corner where the extracted DUT's sub-20mV behavior breaks.
- **Overall**: **no single decision flip exists at this corner** -- a measured NON-DECISION band **[-0.8203, +0.8203] mV** (width 1.6406 mV) separates the wrong-polarity region below it from the correctly-resolved region above it: for any vindiff inside the band, NEITHER output sign crosses the 0.9V threshold within the 200.0ns evaluate window. The wrong-polarity edge brackets to [-0.8594, -0.7812] and the resolved edge to [+0.7812, +0.8594] (18 probes, tolerance 0.1 mV). A decision-referred OFFSET is therefore not the right model for this corner's sub-band behavior: an offset predicts wrong-polarity decisions, and those stop -0.8203 mV below the first vindiff that decides anything at all.

## Bisection probe trace

| vindiff (mV) | decision |
|---|---|
| -10.0000 | wrong-polarity |
| +10.0000 | resolved |
| +0.0000 | non-decision |
| -5.0000 | wrong-polarity |
| -2.5000 | wrong-polarity |
| -1.2500 | wrong-polarity |
| -0.6250 | non-decision |
| -0.9375 | wrong-polarity |
| -0.7812 | non-decision |
| -0.8594 | wrong-polarity |
| +0.0000 | non-decision |
| +5.0000 | resolved |
| +2.5000 | resolved |
| +1.2500 | resolved |
| +0.6250 | non-decision |
| +0.9375 | resolved |
| +0.7812 | non-decision |
| +0.8594 | resolved |

## Environment

- PDK: sky130A @ c6d73a35f524070e85faff4a6a9eef49553ebc2b
- ngspice: ngspice-46
- Harness: sim/harness 0.1.0
- git: `e2b808ce70cd39613ad30e97866e73e0a09df441` on `feature/issue-66` (dirty)
- DUT netlist sha256: `e83be11dee6279b1a97a81c7cc27764147f15dabbac7f13df5134b75ad835ab4`

- **Supersedes**: (none)

Written by `sim/comparator-decision/run.py offset-bisect`. Append-only: never edit or delete this file -- a re-run or correction mints a new record-id and points back here via **Supersedes** (see `sim/README.md`).
