2AMLogic/sky130-comparator/sim/comparator-decision/records/20261002-003713-e2b808c.md

# Record 20261002-003713-e2b808c

- **Record ID**: 20261002-003713-e2b808c
- **Claim**: None by itself -- top-level README target-spec rows are graded by their ratifying decision record, and per DR-002 (2026-09-16, merged) the Offset sigma, Input-referred noise, and Kickback rows are RATIFIED while per DR-005 (2026-09-22, this campaign's record) Decision time vs. overdrive is RATIFIED and only Supply/power stays DRAFT/OPEN. What this record characterizes is **this repo's own comparator**: `design/comparator.sch`, the DR-004 static-preamplifier + StrongARM-latch topology (superseding DR-001's no-preamp scoping) with the DR-003 soft-clock shaper still on the clock port, at a sizing derived from this PDK's own mismatch models (see the schematic's sizing-rationale block, DR-001 Amendment 1, DR-003, DR-004, and DR-005). Any statement about a ratified row's compliance made below cites the bound and the number side by side.
- **Netlist provenance**: POST-LAYOUT / EXTRACTED (`layout/comparator.gds` -> `klt extract --parasitics` -> `layout/comparator.extract.spice` -> `layout/extract_pex.py` -> `layout/comparator.pex.spice`), extracted by klt 0.6.0 on klayout 0.30.10 -- the pin `docs/environment-setup.md` records and CI installs, asserted by `layout/extract_pex.py` because extracted resistances are not stable across builds. Lumped-RC parasitics: 69 star resistors, 12 net-to-ground capacitors and 21 net-to-net coupling capacitors, 117.65 fF total ground capacitance and 17.52 kohm total series resistance over 12 nets (`layout/extract-parasitics.json`). The per-net series R is the extractor's DEFAULT single-lumped-star model, which is coarse on the supply nets specifically (GND and VDD carry the bulk of it) and is expected to be pessimistic there -- see `sim/comparator-decision/README.md`. Net names are the SCHEMATIC names, carried across by the 12/12 net correspondence in the committed `layout/lvs-report.json`, so every probe in this deck names the same circuit node the schematic-level record's probe named. This fragment deliberately carries the `res_high_po` w=0.42 um drawn vs. w=0.35 um schematic delta disclosed by PR #55 / `layout/lvs-coverage-probe.json` -- it is what the layout actually draws, so it is what a post-layout measurement must see.
- **Corner matrix run**: process=['tt'], temperature_c=[27.0], supply_v=[1.8] (1 PVT point -- **subset-corner justification**: single-point characterization of this repo's own design at the stated corner, per issue #24's acceptance criteria; a full ratified PVT corner sweep and Monte Carlo campaign remain open work, blocked on the top-level README target-spec table's ratification -- see issue #3 item 5 and DR-001's 'A full PVT sweep' open item)
- **Stimulus**: single reset(5.0ns, CLK=0)->evaluate(CLK=1.8V) edge per probe (not a repeating clock); decision threshold |v(outp)-v(outn)| > 0.9V (0.5*VDD), BOTH signs classified; evaluate window 200.0ns; Vcm=0.9V; bisection tolerance 0.1 mV
- **Note**: Decision-referred systematic offset, post-layout (extracted) DUT at tt/27C, issue #66. The polarity-aware regen re-run (20261001-232150-e2b808c) bracketed this flip between +1 and +2 mV; this record bisects it. Schematic counterpart: 20261002-000502-e2b808c.
- **Overall**: decision flip at vindiff = **+1.8359 mV** (wrong-polarity edge bracket [+1.7969, +1.8750], resolved edge bracket [+1.7969, +1.8750], 18 probes, tolerance 0.1 mV). Sign convention: the comparator decides correctly for a POSITIVE differential input only when that input exceeds the flip -- it behaves as though an error of -(flip) were added to the applied differential input. This is the DECISION-REFERRED systematic input offset (issue #66): a quantity the pick-off `offset` sub-command's sigma statistic does not express, measured at the decision itself rather than read off a 0.65ns pick-off.

## Bisection probe trace

| vindiff (mV) | decision |
|---|---|
| -10.0000 | wrong-polarity |
| +10.0000 | resolved |
| +0.0000 | wrong-polarity |
| +5.0000 | resolved |
| +2.5000 | resolved |
| +1.2500 | wrong-polarity |
| +1.8750 | resolved |
| +1.5625 | wrong-polarity |
| +1.7188 | wrong-polarity |
| +1.7969 | wrong-polarity |
| +0.0000 | wrong-polarity |
| +5.0000 | resolved |
| +2.5000 | resolved |
| +1.2500 | wrong-polarity |
| +1.8750 | resolved |
| +1.5625 | wrong-polarity |
| +1.7188 | wrong-polarity |
| +1.7969 | wrong-polarity |

## Post-layout delta vs. the schematic-level record

| Quantity | Schematic-level | Post-layout | Delta | Ratio |
|---|---|---|---|---|
| decision-flip vindiff (input-referred systematic offset) | -0.0391 mV | 1.8359 mV | +1.8750 mV | -46.955x |

- **Schematic-level counterpart record**: `sim/comparator-decision/records/20261002-000502-e2b808c.md` (18 probes, tolerance 0.1 mV; the symmetric fragment's flip sits at ~0 by construction (negative control, issue #66))
- **What differs between the two runs**: the DUT fragment, and nothing else. Same sub-command, same corner/temperature/supply, same methodology constants, same deck template -- the schematic-side deck text is byte-identical to the one that produced the counterpart record.

## Environment

- PDK: sky130A @ c6d73a35f524070e85faff4a6a9eef49553ebc2b
- ngspice: ngspice-46
- Harness: sim/harness 0.1.0
- git: `e2b808ce70cd39613ad30e97866e73e0a09df441` on `feature/issue-66` (dirty)
- DUT netlist sha256: `7b83ea8cf54e90f312be9ff7d7803eeae41a20a689a721928e5acf4703ed7c0e`

- **Supersedes**: (none)

Written by `sim/comparator-decision/run.py offset-bisect`. Append-only: never edit or delete this file -- a re-run or correction mints a new record-id and points back here via **Supersedes** (see `sim/README.md`).
