2AMLogic/sky130-comparator/sim/comparator-decision/records/20260926-110218-b64004b.md

# Record 20260926-110218-b64004b

- **Record ID**: 20260926-110218-b64004b
- **Claim**: None by itself -- top-level README target-spec rows are graded by their ratifying decision record, and per DR-002 (2026-09-16, merged) the Offset sigma, Input-referred noise, and Kickback rows are RATIFIED while per DR-005 (2026-09-22, this campaign's record) Decision time vs. overdrive is RATIFIED and only Supply/power stays DRAFT/OPEN. What this record characterizes is **this repo's own comparator**: `design/comparator.sch`, the DR-004 static-preamplifier + StrongARM-latch topology (superseding DR-001's no-preamp scoping) with the DR-003 soft-clock shaper still on the clock port, at a sizing derived from this PDK's own mismatch models (see the schematic's sizing-rationale block, DR-001 Amendment 1, DR-003, DR-004, and DR-005). Any statement about a ratified row's compliance made below cites the bound and the number side by side.
- **Netlist provenance**: POST-LAYOUT / EXTRACTED (`layout/comparator.gds` -> `klt extract --parasitics` -> `layout/comparator.extract.spice` -> `layout/extract_pex.py` -> `layout/comparator.pex.spice`), extracted by klt 0.6.0 on klayout 0.30.10 -- the pin `docs/environment-setup.md` records and CI installs, asserted by `layout/extract_pex.py` because extracted resistances are not stable across builds. Lumped-RC parasitics: 69 star resistors, 12 net-to-ground capacitors and 21 net-to-net coupling capacitors, 117.65 fF total ground capacitance and 17.52 kohm total series resistance over 12 nets (`layout/extract-parasitics.json`). The per-net series R is the extractor's DEFAULT single-lumped-star model, which is coarse on the supply nets specifically (GND and VDD carry the bulk of it) and is expected to be pessimistic there -- see `sim/comparator-decision/README.md`. Net names are the SCHEMATIC names, carried across by the 12/12 net correspondence in the committed `layout/lvs-report.json`, so every probe in this deck names the same circuit node the schematic-level record's probe named. This fragment deliberately carries the `res_high_po` w=0.42 um drawn vs. w=0.35 um schematic delta disclosed by PR #55 / `layout/lvs-coverage-probe.json` -- it is what the layout actually draws, so it is what a post-layout measurement must see.
- **Corner matrix run**: process=['ss'], temperature_c=[-40.0], supply_v=[1.8] (1 point)
- **Noise methodology**: `tran-noise-mc` (issue #41), REGENERATION-INCLUSIVE by equivalent-source injection -- per-side TRNOISE sources at the comparator inputs (preamp input-referred rms from the AC `noise` sub-command: 0.3839 mV) and in series with the steering gates (latch front-end gate-referred rms from a new steering+tail AC sub-model: 0.2574 mV, load-cap insensitivity verified), propagated through the FULL committed fragment's real clocked evaluate trajectory. Injected rms calibrated empirically against this ngspice build's TRNOISE semantics (std = 0.8525 x na; achieved 0.3894 mV input / 0.2574 mV gate vs the AC targets), correlation time 3.7e-10s (~the 1GHz AC band's Nyquist interval). Stated residual omissions: the cross-coupled PMOS pair's noise during exponential separation (divided by the growing regenerative gain) and the reset PMOS (off in evaluate).
- **Two statistics, one claim**: (a) pick-off MC at Vindiff=0, N=32 seeds, gain 31.1479 V/V -> input-referred sigma **0.1382 mV** (95% CI [0.1046, 0.1666] mV). (b) The decision-transition cross-check is NOT MEASURABLE at this corner: every pair was degenerate, and the reason is read off the counts in the table below rather than asserted from a canned string -- every one of the 16 runs RESOLVED (0 unresolved) and every one of them decided the SAME way -- negative -- at BOTH signs of the overdrive, so p+ = p- exactly and the pairs carry no sigma information. That is not a noise statement and must not be read as one: it says a DETERMINISTIC term larger than these sigma-scaled overdrives (tens to hundreds of uV) is setting the outcome. Compare the systematic input offset the `offset` sub-command measures at this same corner and provenance before reading anything else into it. Either way the consequence for THIS record is the same: at this corner the decision statistics are not noise-bound, so the pick-off figure stands alone and the cross-check is deferred to the corners where it is measurable.
- **How the injection is made post-layout** (issue #65): on the extracted netlist each steering device's gate sits on its own parasitic star leg (`OUTP1__t4`, `OUTN1__t4`) tied to the preamp-output hub through that terminal's share of the net's series resistance (75.87 / 97.49 ohm), so there is no node on which to insert a series source by naming the gate net. The deck therefore RE-POINTS those two star-leg resistors from `OUTP1`/`OUTN1` onto the injected nodes `GST_P`/`GST_N` (values unchanged) and places the sources `Vstp GST_P OUTP1` / `Vstn GST_N OUTN1` exactly as the schematic-level deck does; the device lines and every other extracted element are byte-identical to the committed fragment, so the whole injection is two changed tokens. Inserting on this side of the leg rather than between the gate terminal and its leg is not a judgement call: a star-leg node carries exactly one device terminal and exactly one star resistor (asserted by the deck builder, not assumed), so the leg resistor and an ideal source are two-terminal elements in series and the two placements are the same network. Convention for split devices (a schematic device the layout draws as several parallel fingers): all fingers are driven from the one injected node, each keeping its own re-pointed leg. It is not exercised here -- the steering pair is drawn as ONE W=8 device each, and the split devices on this layout are the W=13 input pair, whose injection is at the comparator PINS and needs no surgery at all.
- **Where the stage-2 AC anchor comes from post-layout**: the latch front-end gate-referred rms is measured on the committed LATCH FRONT-END PARTITION of the extracted netlist (`layout/comparator.pex-latch.spice` -- steering pair + latch tail with their extracted parasitics, selected by connectivity as `every device on the TAIL2 node`), the exact counterpart of the schematic side's three named device lines, and the counterpart of the preamp partition the AC `noise` sub-command already used post-layout.
- **Note**: Post-layout (extracted) regeneration-inclusive noise at ss/-40C at N=32/4 -- issue #89. THIS RECORD SUPERSEDES 20260926-100015-b64004b, an N=16/2 run of the SAME claim taken earlier in the same session, and it exists because that sample size was not enough to state a schematic-to-layout ratio with. Both were run, both are kept: the N=16 read was 0.0955 mV (95% CI [0.0646, 0.1149]) and this one is at N=32 -- a difference at ONE corner, on ONE fragment, from sample size alone, which is itself the measurement issue #89 item 3 asks for and is recorded here rather than smoothed over. The earlier record was sized against a 60-minute wall-clock ceiling under heavy co-tenant load; when the host quietened, the larger sample fit, so it was re-run rather than shipped as the figure. SAMPLE SIZE IS STATED ON THE FACE OF THIS RECORD: N=32 pick-off seeds and 4 seeds/sign/decision point -- the same configuration as record 20260926-055806-3034c41 at fs/125C and this issue's ff/125C record, so all three post-layout corners after tt/27C are compared at equal sample size; the schematic-level counterpart (20260922-205857-ebea4e2) is N=128/64. Two host constraints set the ceiling, neither a method choice: (i) this dispatch host budgets each agent a ONE-CORE cgroup CPU quota (cpu.max 100000 100000 on the agent's systemd scope), so --jobs 2 buys no parallel throughput and the run is quota-bound, one deck at a time -- the constraint issue #83 first measured; and (ii) THE AGENT SESSION'S BACKGROUND-TASK SUPERVISOR KILLS ANY SINGLE COMMAND AT ~60 MINUTES OF WALL CLOCK -- newly measured by issue #89, which lost an earlier N=32/4 attempt at THIS corner to it at 59.5 min, pick-off phase complete and decision phase in flight, with no record written. Measured per-deck wall clock on this fragment ranged ~35-285 s depending on co-tenant load on these shared 8 vCPUs, so a corner run must be budgeted as 4 gaincal + N + 4*seeds-per-point decks against a HARD 60-minute ceiling, not against a CPU-time estimate. HOW THE SAMPLE SIZE IS HANDLED: as #83 handled its own -- every statement is read against the CONSERVATIVE END OF THE 95% CI, never the point estimate. WHAT THIS RECORD DOES NOT DO: it does not re-open or re-close DR-006. The Input-referred noise row's compliance basis was closed at DR-006's own named binding corner, fs/125C, by record 20260926-055806-3034c41 and DR-006 Amendment 1; this corner is COVERAGE, not basis. Also note the cross-check expectation at this corner: the schematic-level counterpart found every decision pair degenerate because the sigma-scaled overdrives sit below this corner's resolvable-overdrive floor, so a degenerate cross-check here is the corner's own behaviour and not a post-layout finding.
- **Overall**: MEASURED (informational characterization, not pass/fail -- see Claim)

## Injection calibration

| Injected term | AC target (mV rms/side) | achieved (mV rms/side) |
|---|---|---|
| preamp, at comparator inputs | 0.3839 | 0.3894 |
| latch front-end, in series with steering gates | 0.2574 | 0.2574 |

## AC anchors (this corner)

| Quantity | Value |
|---|---|
| Preamp single-ended input-referred (AC `noise` sub-command, 1kHz-1GHz) | 0.3839 mV rms |
| Latch front-end gate-referred (steering+tail sub-model, same band, gate CM 1.3738V, op TAIL2 0.2479V) | 0.2574 mV rms |
| Pick-off gain (ideal-device calibration) | 31.1479 V/V |

## Pick-off Monte Carlo (statistic (a))

| N | sigma input-referred (mV) | 95% CI (mV) |
|---|---|---|
| 32 | 0.1382 | [0.1046, 0.1666] |

## Decision-transition cross-check (statistic (b))

| \|Vod\| (mV) | k (x sigma_hat) | +Vod: ones/M | -Vod: ones/M | unresolved | pair sigma (mV) |
|---|---|---|---|---|---|
| 0.1037 | 0.75 | 0/4 | 0/4 | 0 | degenerate |
| 0.2073 | 1.5 | 0/4 | 0/4 | 0 | degenerate |

Inverse-variance-weighted decision sigma: **not measurable at this corner** (every pair degenerate -- the reason is derived from these counts in the **Two statistics** bullet above, and is not restated here so the two cannot drift apart)

- **Ratified bound comparison (DR-002)**: the Input-referred noise row is RATIFIED at <= 1 mV rms differential (target) / <= 0.6 mV (stretch). This record's regeneration-inclusive pick-off sigma 0.1382 mV (differential; the per-side injections are independent, the same convention the sqrt(2) AC estimate uses) clears the target bound and clears the stretch bound.

## Post-layout delta vs. the schematic-level record

| Quantity | Schematic-level | Post-layout | Delta | Ratio |
|---|---|---|---|---|
| decision-referred input-referred noise sigma (pick-off MC) | 0.1213 mV | 0.1382 mV | +0.0169 mV | 1.139x |

- **Schematic-level counterpart record**: `sim/comparator-decision/records/20260922-205857-ebea4e2.md` (N=128 pick-off seeds, 95% CI [0.1084, 0.1335] mV, gain 77.6506 V/V; the decision-transition cross-check is NOT MEASURABLE at this corner (every pair degenerate -- the sigma-scaled overdrives sit below this corner's resolvable-overdrive floor), so the pick-off statistic stands alone)
- **What differs between the two runs**: the DUT fragment, and nothing else. Same sub-command, same corner/temperature/supply, same methodology constants, same deck template -- the schematic-side deck text is byte-identical to the one that produced the counterpart record.

## Environment

- PDK: sky130A @ c6d73a35f524070e85faff4a6a9eef49553ebc2b
- ngspice: ngspice-46
- Harness: sim/harness 0.1.0
- git: `b64004b1e1b583d9db1dc0cfb8720f450aea6eb9` on `feature/issue-89` (dirty)
- DUT netlist sha256: `8d624754be2ff934e151d6dc3b1776a3d50a2a115414b85051ede3b38923c8b9`
- noise-tran N pickoff: 32
- noise-tran seeds/sign/decision point: 4

- **Supersedes**: 20260926-100015-b64004b

Written by `sim/comparator-decision/run.py noise-tran`. Append-only: never edit or delete this file -- a re-run or correction mints a new record-id and points back here via **Supersedes** (see `sim/README.md`).
