2AMLogic/sky130-comparator/sim/comparator-decision/records/20260925-165718-8ea399d.md

# Record 20260925-165718-8ea399d

- **Record ID**: 20260925-165718-8ea399d
- **Claim**: None by itself -- top-level README target-spec rows are graded by their ratifying decision record, and per DR-002 (2026-09-16, merged) the Offset sigma, Input-referred noise, and Kickback rows are RATIFIED while per DR-005 (2026-09-22, this campaign's record) Decision time vs. overdrive is RATIFIED and only Supply/power stays DRAFT/OPEN. What this record characterizes is **this repo's own comparator**: `design/comparator.sch`, the DR-004 static-preamplifier + StrongARM-latch topology (superseding DR-001's no-preamp scoping) with the DR-003 soft-clock shaper still on the clock port, at a sizing derived from this PDK's own mismatch models (see the schematic's sizing-rationale block, DR-001 Amendment 1, DR-003, DR-004, and DR-005). Any statement about a ratified row's compliance made below cites the bound and the number side by side.
- **Netlist provenance**: POST-LAYOUT / EXTRACTED (`layout/comparator.gds` -> `klt extract --parasitics` -> `layout/comparator.extract.spice` -> `layout/extract_pex.py` -> `layout/comparator.pex.spice`), extracted by klt 0.6.0 on klayout 0.30.10 -- the pin `docs/environment-setup.md` records and CI installs, asserted by `layout/extract_pex.py` because extracted resistances are not stable across builds. Lumped-RC parasitics: 69 star resistors, 12 net-to-ground capacitors and 21 net-to-net coupling capacitors, 117.65 fF total ground capacitance and 17.52 kohm total series resistance over 12 nets (`layout/extract-parasitics.json`). The per-net series R is the extractor's DEFAULT single-lumped-star model, which is coarse on the supply nets specifically (GND and VDD carry the bulk of it) and is expected to be pessimistic there -- see `sim/comparator-decision/README.md`. Net names are the SCHEMATIC names, carried across by the 12/12 net correspondence in the committed `layout/lvs-report.json`, so every probe in this deck names the same circuit node the schematic-level record's probe named. This fragment deliberately carries the `res_high_po` w=0.42 um drawn vs. w=0.35 um schematic delta disclosed by PR #55 / `layout/lvs-coverage-probe.json` -- it is what the layout actually draws, so it is what a post-layout measurement must see.
- **Corner matrix run**: ff/-40.0C, ff/125.0C, ss/-40.0C, ss/125.0C, tt/27.0C at supply_v=[1.8], each run for BOTH variants (10 runs total -- **subset-corner justification**: a reset-integrity check is a functional-correctness screen whose failure mode is corner-dependent (the same-PDK prior art DR-001 Decision 3 cites failed at 3 of 9 corners), so the point set deliberately spans both temperature extremes against both the slow and the fast process skew, plus the nominal point; it is not the full ratified PVT matrix, which stays blocked on target-spec ratification)
- **Stimulus**: CLK held at 0V for the whole 20.0ns window (reset asserted, never released); NO differential input (VINP=VINN=0.9V); `uic` transient from a deliberately WRONG initial condition -- v(OUTP)=0, v(OUTN)=1.8V (outputs at OPPOSITE RAILS), v(TAIL2)=v(CLKT)=0, with the preamp's static nodes (TAILP, OUTP1, OUTN1) started near their own DC bias
- **Variants**: `as-drawn` = `design/comparator.sch` as committed (the latch steering pair's sources are the floated internal node TAIL2, cut off in reset because M_TAIL2 is off and TAIL2 floats to ~the steering gates' Vth). `gnd-tied` = POSITIVE CONTROL, the single-edit counterfactual -- M_STN_P/M_STN_N sources moved from TAIL2 to GND, nothing else changed (the same counterfactual shape DR-001 Decision 3 established for its own latch's source-precharge scheme). `as-drawn` is expected to hold reset; `gnd-tied` is expected to BREAK it. Both expectations are graded, because a negative control that cannot be shown to fail on the defect it screens for is not evidence that the defect is absent.
- **How the counterfactual is made post-layout** (issue #65): on the extracted netlist no terminal sits on the logical node -- each steering device's source sits on its own parasitic star leg (`TAIL2__t1`, `TAIL2__t2`) tied to the `TAIL2` hub through that terminal's share of the net's series resistance. The counterfactual therefore RE-POINTS each of those two star-leg resistors from `TAIL2` to `GND` (310.07 ohm each, value unchanged) and edits nothing else: the device lines, every other parasitic R and C, and every extracted parameter are byte-identical to the `as-drawn` fragment, so the two decks differ by exactly two tokens. The leg travels WITH the terminal, which is what keeps the moved terminal's own extracted resistance in the circuit instead of deleting it and leaves no star leg stranded on a one-connection node. Convention for split devices (a schematic device the layout draws as several parallel fingers): all of its fingers are moved together. It is not exercised here -- the steering pair is drawn as ONE W=8 device each (`XM_STN_P`/`XM_STN_N`, no `__a`/`__b` split); the split devices on this layout are the W=13 input pair, which this counterfactual does not touch.
- **Reset-held criteria** (all asserted over the final 50% of the window): (1) collapse -- |v(OUTP)-v(OUTN)| <= 1mV; (2) precharge -- min(OUTP,OUTN) >= VDD-10mV; (3) latch off -- max |Vgs| over M_LATP_P/M_LATP_N <= 10mV (= VDD - min(OUTP,OUTN): the pair's gates ARE the outputs); (4) not conducting -- |I(VDD)| <= 0.0002A (the floor under this bound is the DR-004 preamp's OWN static current, ~23-38uA across this matrix -- not leakage)
- **Overall**: PASS (5/5 as-drawn corners hold reset; 5/5 positive-control corners correctly break it)

## As-drawn: reset-integrity negative control

| Corner | Temp | worst \|OUTP-OUTN\| (mV) | worst min(OUTP,OUTN) (V) | worst \|Vgs\| (latch PMOS) (mV) | worst \|I(VDD)\| (A) | Result |
|---|---|---|---|---|---|---|
| tt | 27.0C | 0.02302 | 1.799596 | 0.40358 | 5.691e-05 | HOLDS-RESET -> as expected |
| ss | -40.0C | 0.02957 | 1.799600 | 0.4005 | 5.284e-05 | HOLDS-RESET -> as expected |
| ff | 125.0C | 0.01263 | 1.799584 | 0.41581 | 5.796e-05 | HOLDS-RESET -> as expected |
| ss | 125.0C | 0.01336 | 1.799425 | 0.57501 | 4.789e-05 | HOLDS-RESET -> as expected |
| ff | -40.0C | 0.02693 | 1.799716 | 0.28351 | 6.642e-05 | HOLDS-RESET -> as expected |

## GND-tied: positive control (expected to BREAK reset)

| Corner | Temp | worst \|OUTP-OUTN\| (mV) | worst min(OUTP,OUTN) (V) | worst \|Vgs\| (latch PMOS) (mV) | worst \|I(VDD)\| (A) | Result |
|---|---|---|---|---|---|---|
| tt | 27.0C | 979.165 | 0.325327 | 1474.67 | 0.0008239 | BREAKS-RESET (RESET-NOT-COLLAPSED, RESET-NOT-PRECHARGED, LATCH-NOT-OFF, RESET-CONDUCTING) -> as expected |
| ss | -40.0C | 761.543 | 0.245478 | 1554.52 | 0.0008163 | BREAKS-RESET (RESET-NOT-COLLAPSED, RESET-NOT-PRECHARGED, LATCH-NOT-OFF, RESET-CONDUCTING) -> as expected |
| ff | 125.0C | 830.309 | 0.507184 | 1292.82 | 0.0008081 | BREAKS-RESET (RESET-NOT-COLLAPSED, RESET-NOT-PRECHARGED, LATCH-NOT-OFF, RESET-CONDUCTING) -> as expected |
| ss | 125.0C | 861.643 | 0.396454 | 1403.55 | 0.0008306 | BREAKS-RESET (RESET-NOT-COLLAPSED, RESET-NOT-PRECHARGED, LATCH-NOT-OFF, RESET-CONDUCTING) -> as expected |
| ff | -40.0C | 1070.23 | 0.302966 | 1497.03 | 0.0007856 | BREAKS-RESET (RESET-NOT-COLLAPSED, RESET-NOT-PRECHARGED, LATCH-NOT-OFF, RESET-CONDUCTING) -> as expected |

## Reading this record

DR-001 Decision 3's mechanism -- precharging the cross-coupled pair's gate AND source nodes to the same rail forces `Vgs = 0`, so the loop gain is exactly zero and reset is a stable equilibrium -- is carried by the DR-004 latch stage on its (now PMOS) pair: the outputs ARE the pair's gates and are precharged with their sources to VDD. The `|Vgs| (latch PMOS)` column is that mechanism measured directly, and it is the load-bearing criterion here: it is essentially threshold-free, because the two variants sit most of a supply apart on it. In this topology it numerically coincides with the precharge criterion (same node pair, same tolerance) -- stated rather than hidden; the criteria that carry independent information are the collapse and current columns.

The `|I(VDD)|` column needs reading with its floor in mind. It is not zero even when reset is perfectly held, and cannot be: since DR-004 the design carries a continuously-biased preamplifier whose static current (~23-38 uA across this matrix) flows during reset too -- the class-defining supply cost of the preamp topology -- on top of a small self-limiting off-state path (VDD -> reset PMOS -> steering pair -> floated TAIL2 -> subthreshold latch tail -> GND; TAIL2 settles ~0.6-0.9 V, at the steering pair's Vth). That floor is a property of the topology class, not a defect, and it is what the as-drawn column reports. The positive control's ~1.0-1.2 mA is the contrast that gives the criterion its meaning.

Note also what the collapse criterion alone would NOT have caught: a GND-tied latch can sit at a symmetric point that looks settled on the output-difference column while both branches conduct steadily, which is precisely why criteria (3) and (4) exist alongside it.

## Post-layout delta vs. the schematic-level record

- **Schematic-level counterpart record**: `sim/comparator-decision/records/20260922-070024-e084b55.md` (same five corners, same two variants, same four criteria).
- **What differs between the two runs**: the DUT fragment, and nothing else. Same sub-command, same corner matrix, same stimulus and initial conditions, same tolerances, same deck template -- the schematic-side deck text is byte-identical to the one that produced the counterpart record.
- **Why this record has no numeric delta table**: `reset` is a four-criterion pass/fail screen with a paired positive control, not a scalar measurement. The delta that matters is whether the VERDICTS survive the parasitics, so it is stated as verdicts below, with the one genuinely continuous column (supply current) quoted alongside its schematic-level range.

| Variant | Post-layout verdict | Schematic-level verdict |
|---|---|---|
| `as-drawn` (negative control) | 5/5 corners hold reset | 5/5 corners hold reset |
| `gnd-tied` (positive control) | 5/5 corners break reset | 5/5 corners break reset |

- **Supply current**: worst |I(VDD)| over the settle window is 4.789e-05-6.642e-05 A as-drawn (schematic-level 4.228e-05-6.756e-05 A) against 0.0007856-0.0008306 A for the positive control (schematic-level 8.376e-04-1.056e-03 A). The separation between the two variants, not the absolute level, is what criterion (4) rests on.
- **The point of running this post-layout at all**: `reset` is the screen for a latch whose reset state is not a stable, non-conducting equilibrium, and layout parasitics are exactly the class of asymmetry such a screen exists to catch. Until this record it had only ever been run against a netlist that is symmetric by construction.

## Environment

- PDK: sky130A @ c6d73a35f524070e85faff4a6a9eef49553ebc2b
- ngspice: ngspice-46
- Harness: sim/harness 0.1.0
- git: `8ea399d53131e7edff0aff7d77500b078854fa7a` on `feature/issue-65` (dirty)
- DUT netlist sha256: `7b83ea8cf54e90f312be9ff7d7803eeae41a20a689a721928e5acf4703ed7c0e`

- **Supersedes**: (none)

Written by `sim/comparator-decision/run.py reset`. Append-only: never edit or delete this file -- a re-run or correction mints a new record-id and points back here via **Supersedes** (see `sim/README.md`).
