2AMLogic/sky130-comparator/sim/comparator-decision/records/20260925-165719-45f0767.md

# Record 20260925-165719-45f0767

- **Record ID**: 20260925-165719-45f0767
- **Claim**: None by itself -- top-level README target-spec rows are graded by their ratifying decision record, and per DR-002 (2026-09-16, merged) the Offset sigma, Input-referred noise, and Kickback rows are RATIFIED while per DR-005 (2026-09-22, this campaign's record) Decision time vs. overdrive is RATIFIED and only Supply/power stays DRAFT/OPEN. What this record characterizes is **this repo's own comparator**: `design/comparator.sch`, the DR-004 static-preamplifier + StrongARM-latch topology (superseding DR-001's no-preamp scoping) with the DR-003 soft-clock shaper still on the clock port, at a sizing derived from this PDK's own mismatch models (see the schematic's sizing-rationale block, DR-001 Amendment 1, DR-003, DR-004, and DR-005). Any statement about a ratified row's compliance made below cites the bound and the number side by side.
- **Netlist provenance**: POST-LAYOUT / EXTRACTED (`layout/comparator.gds` -> `klt extract --parasitics` -> `layout/comparator.extract.spice` -> `layout/extract_pex.py` -> `layout/comparator.pex.spice`), extracted by klt 0.6.0 on klayout 0.30.10 -- the pin `docs/environment-setup.md` records and CI installs, asserted by `layout/extract_pex.py` because extracted resistances are not stable across builds. Lumped-RC parasitics: 69 star resistors, 12 net-to-ground capacitors and 21 net-to-net coupling capacitors, 117.65 fF total ground capacitance and 17.52 kohm total series resistance over 12 nets (`layout/extract-parasitics.json`). The per-net series R is the extractor's DEFAULT single-lumped-star model, which is coarse on the supply nets specifically (GND and VDD carry the bulk of it) and is expected to be pessimistic there -- see `sim/comparator-decision/README.md`. Net names are the SCHEMATIC names, carried across by the 12/12 net correspondence in the committed `layout/lvs-report.json`, so every probe in this deck names the same circuit node the schematic-level record's probe named. This fragment deliberately carries the `res_high_po` w=0.42 um drawn vs. w=0.35 um schematic delta disclosed by PR #55 / `layout/lvs-coverage-probe.json` -- it is what the layout actually draws, so it is what a post-layout measurement must see.
- **Corner matrix run**: process=['sf'], temperature_c=[-40.0], supply_v=[1.8] (1 PVT point, both variants -- **subset-corner justification**: one corner per record, by design -- this record measures sf/-40C, one of the seven PVT points DR-005 grades the ratified rows across. The Kickback row's full graded corner set is assembled from one such record per corner rather than from a single multi-corner record, so each corner keeps its own independently citable evidence and its own delta against the schematic-level counterpart at the SAME corner. See the corner-coverage table in `sim/comparator-decision/README.md` for which corners are measured at which DUT provenance)
- **Stimulus**: VINP/VINN biased at VCM=0.9V +/- 25mV (a static 50mV differential step, sized to guarantee a clean decision -- matching the `regen` sweep's largest tested overdrive and the target-spec table's own "Decision time vs. overdrive" 50mV reference point); single reset(5.0ns, CLK=0)->evaluate(CLK=1.8V) edge, the same stimulus shape `regen`/`reset` already use
- **Variants**: `loaded` = VINP/VINN fed through an explicit 1000ohm series resistor from an ideal DC source -- the target-spec Kickback row's own stated methodology assumption, and what lets an injected disturbance show up as a voltage instead of being absorbed. `ideal` = CONTROL, VINP/VINN driven directly by the ideal DC source (zero source impedance) -- must collapse to (numerically) zero by construction; anything else would mean the deck is not actually isolating the source-impedance-dependent effect the `loaded` variant measures.
- **Sensitivity criteria**: `loaded` peak disturbance must be >= 1mV (a floor far below the measured signal, not a tuned threshold); `ideal` peak disturbance must be <= 1e-06mV
- **Note**: Post-layout (extracted) kickback -- issue #64, extending the post-layout PVT campaign off issue #57's tt/27C anchor to the remaining six graded corners of the Kickback row. sf/-40C is run FIRST as the schematic-level worst case and the only pre-layout stretch-figure breach (2.0208 mV against the <= 2 mV stretch). Dispatched SERIALLY, one corner and one ngspice process at a time (--jobs 1), per this host's shared-dispatch-worker rules -- see sim/comparator-decision/README.md "Dispatch decision (issue #64)" for why this campaign is not a klt sim batch request.
- **Overall**: PASS (loaded peak=3.1989mV, ideal peak=0.0000mV)

## Peak input-node disturbance

| Variant | peak \|VINP-quiescent\| (mV) | peak \|VINN-quiescent\| (mV) | Result |
|---|---|---|---|
| loaded | 1.0954 | 3.1989 | peak=3.1989mV -> as expected |
| ideal | 0.0000 | 0.0000 | peak=0.0000mV -> as expected |

## Reading this record

Measured against the DR-004 static-preamp design (issue #34: a continuously-biased preamplifier ahead of the StrongARM latch, with DR-003's soft-clock shaper still on the clock port driving the latch tail and reset PMOS, tau ~ 250 ps). The raw mechanism the pre-DR-004 designs suffered -- a DYNAMIC input pair's own channel formation and internal-node collapse coupling back onto the VINP/VINN gate nodes through the input devices' gate parasitics -- is removed at the root in this class: the preamp's channels are always formed (Vgs constant, zero formation charge at the edge), and whatever the latch kicks back arrives at the preamp OUTPUT nodes, where the absorber caps (M_C1P/M_C1N) sink it before the pins. The residual `loaded` figure below is what survives that isolation, measured end to end through the target-spec row's own 1 kOhm source impedance. The `ideal` control still collapses to (numerically) zero by construction, so the deck continues to isolate a genuine source-impedance-dependent effect.

- **Ratified bound comparison (DR-002)**: the Kickback row is RATIFIED at <= 5 mV disturbance into 1 kOhm source impedance (target, single decision edge) / <= 2 mV (stretch). This record's `loaded` peak figure of 3.1989 mV MEETS the target bound and DOES NOT yet meet the stretch bound. The comparison holds for the single sf/-40C PVT point this record runs (see Corner matrix run above) and for this record's DUT provenance alone -- see the corner-coverage table in `sim/comparator-decision/README.md` for which of the seven graded corners are measured at which provenance.

## Post-layout delta vs. the schematic-level record

| Quantity | Schematic-level | Post-layout | Delta | Ratio |
|---|---|---|---|---|
| peak `loaded` input-node disturbance | 2.0208 mV | 3.1989 mV | +1.1781 mV | 1.583x |

- **Schematic-level counterpart record**: `sim/comparator-decision/records/20260922-180026-e23c509.md` (1 kohm source impedance, 50 mV overdrive, `ideal` control 0.0000 mV; the only schematic-level corner over the <= 2 mV stretch figure (by 1%))
- **What differs between the two runs**: the DUT fragment, and nothing else. Same sub-command, same corner/temperature/supply, same methodology constants, same deck template -- the schematic-side deck text is byte-identical to the one that produced the counterpart record.

## Environment

- PDK: sky130A @ c6d73a35f524070e85faff4a6a9eef49553ebc2b
- ngspice: ngspice-46
- Harness: sim/harness 0.1.0
- git: `45f07677cae14b0ab0555585764d0f321e61ea5b` on `feature/issue-64` (dirty)
- DUT netlist sha256: `7b83ea8cf54e90f312be9ff7d7803eeae41a20a689a721928e5acf4703ed7c0e`

- **Supersedes**: (none)

Written by `sim/comparator-decision/run.py kickback`. Append-only: never edit or delete this file -- a re-run or correction mints a new record-id and points back here via **Supersedes** (see `sim/README.md`).
