2AMLogic/sky130-comparator/sim/comparator-decision/records/20260925-173228-bec714a.md

# Record 20260925-173228-bec714a

- **Record ID**: 20260925-173228-bec714a
- **Claim**: None by itself -- top-level README target-spec rows are graded by their ratifying decision record, and per DR-002 (2026-09-16, merged) the Offset sigma, Input-referred noise, and Kickback rows are RATIFIED while per DR-005 (2026-09-22, this campaign's record) Decision time vs. overdrive is RATIFIED and only Supply/power stays DRAFT/OPEN. What this record characterizes is **this repo's own comparator**: `design/comparator.sch`, the DR-004 static-preamplifier + StrongARM-latch topology (superseding DR-001's no-preamp scoping) with the DR-003 soft-clock shaper still on the clock port, at a sizing derived from this PDK's own mismatch models (see the schematic's sizing-rationale block, DR-001 Amendment 1, DR-003, DR-004, and DR-005). Any statement about a ratified row's compliance made below cites the bound and the number side by side.
- **Netlist provenance**: POST-LAYOUT / EXTRACTED (`layout/comparator.gds` -> `klt extract --parasitics` -> `layout/comparator.extract.spice` -> `layout/extract_pex.py` -> `layout/comparator.pex.spice`), extracted by klt 0.6.0 on klayout 0.30.10 -- the pin `docs/environment-setup.md` records and CI installs, asserted by `layout/extract_pex.py` because extracted resistances are not stable across builds. Lumped-RC parasitics: 69 star resistors, 12 net-to-ground capacitors and 21 net-to-net coupling capacitors, 117.65 fF total ground capacitance and 17.52 kohm total series resistance over 12 nets (`layout/extract-parasitics.json`). The per-net series R is the extractor's DEFAULT single-lumped-star model, which is coarse on the supply nets specifically (GND and VDD carry the bulk of it) and is expected to be pessimistic there -- see `sim/comparator-decision/README.md`. Net names are the SCHEMATIC names, carried across by the 12/12 net correspondence in the committed `layout/lvs-report.json`, so every probe in this deck names the same circuit node the schematic-level record's probe named. This fragment deliberately carries the `res_high_po` w=0.42 um drawn vs. w=0.35 um schematic delta disclosed by PR #55 / `layout/lvs-coverage-probe.json` -- it is what the layout actually draws, so it is what a post-layout measurement must see.
- **Corner matrix run**: process=['fs'], temperature_c=[125.0], supply_v=[1.8] (1 PVT point -- **subset-corner justification**: single-point characterization of this repo's own design at the stated corner, per issue #24's acceptance criteria; a full ratified PVT corner sweep and Monte Carlo campaign remain open work, blocked on the top-level README target-spec table's ratification -- see issue #3 item 5 and DR-001's 'A full PVT sweep' open item)
- **Stimulus**: single reset(5.0ns, CLK=0)->evaluate(CLK=1.8V) edge per run (not a repeating clock); decision threshold |v(outp)-v(outn)| > 0.9V (0.5*VDD); Vcm=0.9V
- **Note**: Post-layout (extracted) regen -- issue #64, extending the post-layout PVT campaign off issue #57's tt/27C and ss/-40C anchors to the remaining five graded corners of the Decision time vs. overdrive row. Corners are ordered by extrapolated risk against the <= 0.8 ns stretch bound (schematic-level slowest first). Dispatched SERIALLY, one corner and one ngspice process at a time (--jobs 1), per this host's shared-dispatch-worker rules -- see sim/comparator-decision/README.md "Dispatch decision (issue #64)" for why this campaign is not a klt sim batch request.
- **Overall**: INCOMPLETE (7/8 points resolved within the 40.0ns evaluate window)

## Regeneration time vs. differential input

| Vindiff (mV) | regen time (ns) |
|---|---|
| -10.00 | 1.2225 |
| +0.50 | UNRESOLVED (> evaluate window) |
| +1.00 | 2.6225 |
| +2.00 | 1.9475 |
| +5.00 | 1.5175 |
| +10.00 | 1.2775 |
| +20.00 | 1.0725 |
| +50.00 | 0.7725 |

Expected shape: regeneration time grows roughly as `ln(V_decided/Vindiff)` (standard positive-feedback latch behavior) as Vindiff shrinks -- the monotonic growth from 50mV to 0.5mV above is the qualitative plumbing check for that, not a quantitative claim against any spec row.

## Post-layout delta vs. the schematic-level record

| Quantity | Schematic-level | Post-layout | Delta | Ratio |
|---|---|---|---|---|
| regeneration time at 50 mV overdrive | 0.5375 ns | 0.7725 ns | +0.2350 ns | 1.437x |

- **Schematic-level counterpart record**: `sim/comparator-decision/records/20260922-175918-e23c509.md` (8/8 sweep points resolved)
- **What differs between the two runs**: the DUT fragment, and nothing else. Same sub-command, same corner/temperature/supply, same methodology constants, same deck template -- the schematic-side deck text is byte-identical to the one that produced the counterpart record.

## Environment

- PDK: sky130A @ c6d73a35f524070e85faff4a6a9eef49553ebc2b
- ngspice: ngspice-46
- Harness: sim/harness 0.1.0
- git: `bec714ac5c2124319b69f15a6e05c3bde9692976` on `feature/issue-64` (dirty)
- DUT netlist sha256: `7b83ea8cf54e90f312be9ff7d7803eeae41a20a689a721928e5acf4703ed7c0e`

- **Supersedes**: (none)

Written by `sim/comparator-decision/run.py regen`. Append-only: never edit or delete this file -- a re-run or correction mints a new record-id and points back here via **Supersedes** (see `sim/README.md`).
