2AMLogic/sky130-comparator/sim/comparator-decision/records/20260925-070601-2e2ef84.md

# Record 20260925-070601-2e2ef84

- **Record ID**: 20260925-070601-2e2ef84
- **Claim**: None by itself -- top-level README target-spec rows are graded by their ratifying decision record, and per DR-002 (2026-09-16, merged) the Offset sigma, Input-referred noise, and Kickback rows are RATIFIED while per DR-005 (2026-09-22, this campaign's record) Decision time vs. overdrive is RATIFIED and only Supply/power stays DRAFT/OPEN. What this record characterizes is **this repo's own comparator**: `design/comparator.sch`, the DR-004 static-preamplifier + StrongARM-latch topology (superseding DR-001's no-preamp scoping) with the DR-003 soft-clock shaper still on the clock port, at a sizing derived from this PDK's own mismatch models (see the schematic's sizing-rationale block, DR-001 Amendment 1, DR-003, DR-004, and DR-005). Any statement about a ratified row's compliance made below cites the bound and the number side by side.
- **Netlist provenance**: POST-LAYOUT / EXTRACTED (`layout/comparator.gds` -> `klt extract --parasitics` -> `layout/comparator.extract.spice` -> `layout/extract_pex.py` -> `layout/comparator.pex.spice`). Lumped-RC parasitics: 69 star resistors, 12 net-to-ground capacitors and 21 net-to-net coupling capacitors, 117.65 fF total ground capacitance and 14.70 kohm total series resistance over 12 nets (`layout/extract-parasitics.json`). Net names are the SCHEMATIC names, carried across by the 12/12 net correspondence in the committed `layout/lvs-report.json`, so every probe in this deck names the same circuit node the schematic-level record's probe named. This fragment deliberately carries the `res_high_po` w=0.42 um drawn vs. w=0.35 um schematic delta disclosed by PR #55 / `layout/lvs-coverage-probe.json` -- it is what the layout actually draws, so it is what a post-layout measurement must see.
- **Corner matrix run**: process=['tt'], temperature_c=[27.0], supply_v=[1.8] (1 PVT point, both variants -- **subset-corner justification**: this record re-measures the SAME single nominal corner (tt/27C, 1 kOhm, 50 mV overdrive) issue #26's kickback record (20260916-060139-f1eb978, the pre-mitigation measurement DR-002's Kickback disposition cites) used, so the before/after comparison DR-002 asked for is direct and like-for-like per issue #30's acceptance criteria -- a full-corner kickback sweep remains open work exactly as DR-002 already flags it)
- **Stimulus**: VINP/VINN biased at VCM=0.9V +/- 25mV (a static 50mV differential step, sized to guarantee a clean decision -- matching the `regen` sweep's largest tested overdrive and the target-spec table's own "Decision time vs. overdrive" 50mV reference point); single reset(5.0ns, CLK=0)->evaluate(CLK=1.8V) edge, the same stimulus shape `regen`/`reset` already use
- **Variants**: `loaded` = VINP/VINN fed through an explicit 1000ohm series resistor from an ideal DC source -- the target-spec Kickback row's own stated methodology assumption, and what lets an injected disturbance show up as a voltage instead of being absorbed. `ideal` = CONTROL, VINP/VINN driven directly by the ideal DC source (zero source impedance) -- must collapse to (numerically) zero by construction; anything else would mean the deck is not actually isolating the source-impedance-dependent effect the `loaded` variant measures.
- **Sensitivity criteria**: `loaded` peak disturbance must be >= 1mV (a floor far below the measured signal, not a tuned threshold); `ideal` peak disturbance must be <= 1e-06mV
- **Note**: Post-layout (extracted) re-run of the tt/27C kickback anchor, issue #57 / T1 item 7 -- the thin-margin row DR-002/DR-005 flag as the layout-parasitic risk.
- **Overall**: PASS (loaded peak=2.5532mV, ideal peak=0.0000mV)

## Peak input-node disturbance

| Variant | peak \|VINP-quiescent\| (mV) | peak \|VINN-quiescent\| (mV) | Result |
|---|---|---|---|
| loaded | 1.3902 | 2.5532 | peak=2.5532mV -> as expected |
| ideal | 0.0000 | 0.0000 | peak=0.0000mV -> as expected |

## Reading this record

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

- **Ratified bound comparison (DR-002)**: the Kickback row is RATIFIED at <= 5 mV disturbance into 1 kOhm source impedance (target, single decision edge) / <= 2 mV (stretch). This record's `loaded` peak figure of 2.5532 mV MEETS the target bound and DOES NOT yet meet the stretch bound. The comparison holds for the single tt/27C PVT point this record runs (see Corner matrix run above); kickback PVT coverage remains open work per DR-002.

## Post-layout delta vs. the schematic-level record

| Quantity | Schematic-level | Post-layout | Delta | Ratio |
|---|---|---|---|---|
| peak `loaded` input-node disturbance | 1.8902 mV | 2.5532 mV | +0.6630 mV | 1.351x |

- **Schematic-level counterpart record**: `sim/comparator-decision/records/20260922-070119-e084b55.md` (1 kohm source impedance, 50 mV overdrive, `ideal` control 0.0000 mV)
- **What differs between the two runs**: the DUT fragment, and nothing else. Same sub-command, same corner/temperature/supply, same methodology constants, same deck template -- the schematic-side deck text is byte-identical to the one that produced the counterpart record.

## Environment

- PDK: sky130A @ c6d73a35f524070e85faff4a6a9eef49553ebc2b
- ngspice: ngspice-46
- Harness: sim/harness 0.1.0
- git: `2e2ef84b0f1f41a6ebb5cb7841deffaf2ba50cf2` on `feature/issue-57` (dirty)
- DUT netlist sha256: `77c9636cbf061778fd4a22cc74eeae8fa2fddfb9d0e7dc71dd9236ac5fcc0f27`

- **Supersedes**: (none)

Written by `sim/comparator-decision/run.py kickback`. Append-only: never edit or delete this file -- a re-run or correction mints a new record-id and points back here via **Supersedes** (see `sim/README.md`).
