2AMLogic/sky130-comparator/sim/comparator-decision/records/20260925-072817-2e2ef84.md

# Record 20260925-072817-2e2ef84

- **Record ID**: 20260925-072817-2e2ef84
- **Claim**: None by itself -- top-level README target-spec rows are graded by their ratifying decision record, and per DR-002 (2026-09-16, merged) the Offset sigma, Input-referred noise, and Kickback rows are RATIFIED while per DR-005 (2026-09-22, this campaign's record) Decision time vs. overdrive is RATIFIED and only Supply/power stays DRAFT/OPEN. What this record characterizes is **this repo's own comparator**: `design/comparator.sch`, the DR-004 static-preamplifier + StrongARM-latch topology (superseding DR-001's no-preamp scoping) with the DR-003 soft-clock shaper still on the clock port, at a sizing derived from this PDK's own mismatch models (see the schematic's sizing-rationale block, DR-001 Amendment 1, DR-003, DR-004, and DR-005). Any statement about a ratified row's compliance made below cites the bound and the number side by side.
- **Netlist provenance**: POST-LAYOUT / EXTRACTED, reduced sub-model -- the preamp partition of the extracted netlist (`layout/comparator.pex-preamp.spice`, from `layout/comparator.gds` via `klt extract --parasitics` and `layout/extract_pex.py`), WITH its extracted lumped-RC parasitics; everything past the preamp outputs is the loop break; see Methodology for what that omits and for how the partition is taken.
- **Corner matrix run**: process=['tt'], temperature_c=[27.0], supply_v=[1.8] (1 point)
- **Noise methodology**: `ac-based`, integration bandwidth 1000Hz-1e+09Hz. REDUCED SUB-MODEL, not the full comparator_core.spice fragment: reduced sub-model of the DR-004 static preamplifier: preamp tail (gate at VDD) + input pair + both poly loads + both OUT1 absorber MOS caps, all re-emitted verbatim from the committed fragment; everything past the preamp outputs (steering pair, latch tail, cross-coupled PMOS, reset PMOS) omitted -- that is the loop break. Unlike the pre-DR-004 integration-phase proxy (diode-connected stand-in loads on a dynamic input stage), this stage holds its own real continuous DC operating point; noise taken at v(OUTP1,OUTN1). POST-LAYOUT form: the same loop break applied to the EXTRACTED netlist instead of to the schematic fragment's device lines -- `layout/comparator.pex-preamp.spice`, generated by `layout/extract_pex.py` by dropping every extracted device that touches a latch net (CLK/CLKT/TAIL2/OUTP/OUTN) together with those nets' parasitics, and asserting that exactly the nine expected drawn devices survive (tail, four input-pair fingers, two poly loads, two absorber caps). The surviving nets keep their full extracted lumped-RC parasitics, including the per-terminal star legs on VINP/VINN/TAILP/OUTP1/OUTN1 and the net-to-net coupling capacitors among them. This is a named, flagged simplification (excludes the cross-coupled latch pair's own regenerative-phase noise contribution) -- a LOWER BOUND on the true regeneration-inclusive noise, per the port source's own documented derivation (see README.md).
- **Note**: Post-layout (extracted) re-run of the tt/27C AC noise anchor, issue #57 / T1 item 7, on the extracted preamp partition.
- **Overall**: measured value recorded (informational plumbing proof, not pass/fail -- see Claim)

## Measured value(s)

| Quantity | Value | Corner condition |
|---|---|---|
| Op point: v(TAILP) | 0.1805 V | tt/27.0C/1.8V |
| Op point: v(OUTP1)=v(OUTN1) | 1.3147 V | tt/27.0C/1.8V |
| Single-ended input-referred noise (`inoise_total`, referred through Vinp) | 0.4550 mV rms | tt/27.0C/1.8V |
| **Differential input-referred noise estimate** (`sqrt(2) x` single-ended, diff-pair noise-doubling approximation) | **0.6434 mV rms** | tt/27.0C/1.8V |

- **Data provenance**: model-card-monte-carlo (sky130A BSIM4 device noise models via ngspice's `.noise` analysis; no literature/foundry-doc noise figure used)
- **Ratified bound comparison (DR-002)**: the Input-referred noise row is RATIFIED at <= 1 mV rms differential (target) / <= 0.6 mV rms (stretch). This record's 0.6434 mV rms differential estimate (a LOWER BOUND, see Methodology) clears the target bound and DOES NOT yet clear the stretch bound.

## Post-layout delta vs. the schematic-level record

| Quantity | Schematic-level | Post-layout | Delta | Ratio |
|---|---|---|---|---|
| differential input-referred noise | 0.5704 mV rms | 0.6434 mV rms | +0.0730 mV rms | 1.128x |

- **Schematic-level counterpart record**: `sim/comparator-decision/records/20260922-065534-e084b55.md` (loop-broken AC sub-model of the DR-004 preamp, 1 kHz-1 GHz)
- **What differs between the two runs**: the DUT fragment, and nothing else. Same sub-command, same corner/temperature/supply, same methodology constants, same deck template -- the schematic-side deck text is byte-identical to the one that produced the counterpart record.

## Environment

- PDK: sky130A @ c6d73a35f524070e85faff4a6a9eef49553ebc2b
- ngspice: ngspice-46
- Harness: sim/harness 0.1.0
- git: `2e2ef84b0f1f41a6ebb5cb7841deffaf2ba50cf2` on `feature/issue-57` (dirty)
- DUT netlist sha256: `ca1d19802d9da195a677c7045611bb98ed043c3d1fcbd312c0f302410024395f`

- **Supersedes**: (none)

Written by `sim/comparator-decision/run.py noise`. Append-only: never edit or delete this file -- a re-run or correction mints a new record-id and points back here via **Supersedes** (see `sim/README.md`).
