2AMLogic/sky130-comparator/sim/comparator-decision/records/20260922-173622-e23c509.md

# Monte Carlo record 20260922-173622-e23c509

- **Record ID**: 20260922-173622-e23c509
- **Claim**: None by itself -- top-level README target-spec rows are graded by their ratifying decision record, and per DR-002 (2026-09-16, merged) the Offset sigma, Input-referred noise, and Kickback rows are RATIFIED while Decision time vs. overdrive and Supply/power stay DRAFT/OPEN. What this record characterizes is **this repo's own comparator**: `design/comparator.sch`, the DR-004 static-preamplifier + StrongARM-latch topology (superseding DR-001's no-preamp scoping) with the DR-003 soft-clock shaper still on the clock port, at a sizing derived from this PDK's own mismatch models (see the schematic's sizing-rationale block, DR-001 Amendment 1, DR-003, and DR-004). Any statement about a ratified row's compliance made below cites the bound and the number side by side.
- **Netlist provenance**: schematic-derived (`design/comparator.sch` -> `./design/netlist.sh` -> `sim/comparator-decision/testbench/comparator_core.spice`)
- **Statistical convention**: mismatch corner `ss_mm`, N=16, seed=1 (draws use seed, seed+1, ..., seed+N-1), PVT point process=ss temp=27.0C supply=1.8V. Relative standard error on the estimated offset stdev, SE(s)/s ~= 1/sqrt(2(N-1)): N=16 gives 18.3%. A distribution-shape-adequate sample for this plumbing proof, not a sample sized for a tight yield-fraction claim (that needs O(100s)).
- **Methodology**: linearized pick-off statistic at t=evaluate_start+0.65ns, calibrated to an input-referred gain of 53.9582 V/V via a 4-point ideal-device Vindiff sweep (zero-intercept least-squares fit).
- **Negative control**: N=16 draws at the plain `ss` corner (mismatch DISABLED), same seed sequence -- PASS (stdev == 0 on the pick-off-derived offset)
- **Positive control**: N=16 draws at the `ss_mm` corner (mismatch ENABLED) offset stdev=0.0018244 V (> 0, shows genuine spread -- PASS)
- **Note**: issue #41 campaign: mismatch-corner sweep, ss_mm/27C, seed-1 methodology as the tt_mm anchor (20260922-065300-e084b55), DR-004 topology
- **Overall**: PASS

## Gain calibration (ideal devices, ss corner)

| Vindiff (mV) | pick-off diff (V) |
|---|---|
| 1.00 | 0.0581804 |
| 2.00 | 0.115916 |
| 5.00 | 0.282329 |
| 10.00 | 0.531292 |

Fitted gain (zero-intercept least squares): **53.9582 V/V**

## Offset distribution (mismatch-enabled draws, input-referred)

| N | mean (mV) | stdev (mV) | min (mV) | max (mV) |
|---|---|---|---|---|
| 16 | -0.4802 | 1.8244 | -2.4169 | 3.2447 |

- **Ratified bound comparison (DR-002)**: the Offset sigma row is RATIFIED at <= 15 mV, 3-sigma (target) / <= 8 mV, 3-sigma (stretch), input-referred. This record's N=16 estimated stdev 1.8244 mV gives 3-sigma = 5.4732 mV, which clears the target bound and clears the stretch bound. N=16 is sized for distribution shape, not a yield-fraction claim (see the Statistical convention above).

## Negative control (mismatch-disabled, same seed sequence)

| N | mean (mV) | stdev (mV, must be 0) |
|---|---|---|
| 16 | 0.0000 | 0 |

## Environment

- PDK: sky130A @ c6d73a35f524070e85faff4a6a9eef49553ebc2b
- ngspice: ngspice-46
- Harness: sim/harness 0.1.0
- git: `e23c509a035fd58eaff0068e1b6d47eb7012abae` on `feature/issue-41` (dirty)
- DUT netlist sha256: `e83be11dee6279b1a97a81c7cc27764147f15dabbac7f13df5134b75ad835ab4`
- MC seed: 1
- MC N: 16

- **Supersedes**: (none)

Written by `sim/comparator-decision/run.py offset`. Append-only: never edit or delete this file -- a re-run or correction mints a new record-id and points back here via **Supersedes** (see `sim/README.md`).
