2AMLogic/sky130-comparator/sim/comparator-decision/records/20260922-174326-e23c509.md

# Monte Carlo record 20260922-174326-e23c509

- **Record ID**: 20260922-174326-e23c509
- **Claim**: None by itself -- top-level README target-spec rows are graded by their ratifying decision record, and per DR-002 (2026-09-16, merged) the Offset sigma, Input-referred noise, and Kickback rows are RATIFIED while Decision time vs. overdrive and Supply/power stay DRAFT/OPEN. What this record characterizes is **this repo's own comparator**: `design/comparator.sch`, the DR-004 static-preamplifier + StrongARM-latch topology (superseding DR-001's no-preamp scoping) with the DR-003 soft-clock shaper still on the clock port, at a sizing derived from this PDK's own mismatch models (see the schematic's sizing-rationale block, DR-001 Amendment 1, DR-003, and DR-004). Any statement about a ratified row's compliance made below cites the bound and the number side by side.
- **Netlist provenance**: schematic-derived (`design/comparator.sch` -> `./design/netlist.sh` -> `sim/comparator-decision/testbench/comparator_core.spice`)
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
