2AMLogic/sky130-comparator/docs/environment-setup.md

# Environment setup

Bootstrap steps for the open-source analog flow this repo's `sim/` harness
drives: xschem (schematic capture / netlisting) + ngspice (simulation)
against the sky130 PDK, fetched/managed via
[ciel](https://github.com/fossi-foundation/ciel) (the successor to
volare, whose version feed stopped in Aug 2025).

This doc is meant to be followed from a shell on a machine that already has
the xschem/ngspice/ciel binaries installed — a from-scratch build/install
recipe for those three tools is out of scope here (see "Toolchain versions"
below for what to do if one is genuinely missing). There is no `layout/`
tree in this repo yet, so this doc still has no layout/DRC/LVS-pass section
like its sibling docs; there is, however, `klt` (klayout-tools) integration
now — the T1 signoff manifest and its CI gate (issue #31), see
"Signoff tooling (klt)" below.

**Provenance**: this document's structure is adapted from
`2AMLogic/sky130-sar-adc`'s and `2AMLogic/sky130-bandgap`'s own
`docs/environment-setup.md` (both target the identical sky130 PDK — see
`sim/README.md`'s own provenance table for the harness this doc bootstraps
for). The toolchain versions, PDK pin, and paths below are this repo's own,
re-recorded against its own install and `sim/pdk.json` / `sim/toolchain.json`
— only the document shape is carried over, not the numbers.

## Toolchain versions (recorded 2026-09-09)

| Tool | Version | Install path |
| --- | --- | --- |
| xschem | `XSCHEM V3.4.7` | `/usr/local/bin/xschem` |
| ngspice | `ngspice-46` | `/home/ubuntu/.local/bin/ngspice` |
| ciel | `2.6.1` (pinned) | `pip install ciel==2.6.1` (venv or user site) |
| python3 | `Python 3.12.3` | `/usr/bin/python3` |

Recorded by running each tool's own version command on the machine doing
this pass — this is a snapshot, not a durable fact; re-run these on your own
machine rather than trusting the table above:

```sh
xschem -v          # -> XSCHEM V3.4.7 ...
ngspice --version   # -> ngspice-46 : Circuit level simulation program ...
ciel --version      # -> 2.6.1
python3 --version   # -> Python 3.12.3
```

### CI ngspice-46 provenance (issue #149)

The from-scratch build mentioned above stays out of scope for a developer
machine, but CI has no ngspice to start from: `ubuntu-latest` apt ships 42
and conda-forge 41, both below `sim/toolchain.json`'s `ngspice_min_major: 46`.
The `harness-selftest` job in `.github/workflows/t1-signoff.yml` therefore
builds ngspice 46 from the upstream release tarball
(`https://sourceforge.net/projects/ngspice/files/ng-spice-rework/old-releases/46/ngspice-46.tar.gz/download`,
SHA-256 `a0d1699af1940b06649276dcd6ff5a566c8c0cad01b2f7b5e99dedbb4d64c19b`,
verified before extraction), with `build-essential bison flex libreadline-dev`
and `./configure --without-x --with-readline=yes --disable-debug` (bundled
KLU left enabled). The install prefix is cached with `actions/cache`, and the
job asserts `ngspice --version` reports `ngspice-46` before running
`sim/selftest.sh --require-pdk` (reduced mode, no `--full`). It runs on push
to `main` and `workflow_dispatch` only. If the pin changes, update the
workflow's URL, digest and cache key together with `sim/toolchain.json`.

## Signoff tooling (klt, recorded 2026-09-24)

The T1 signoff manifest (issue #31) is graded by
[`klt`](https://github.com/2AMLogic/klayout-tools)'s `klt signoff
--manifest`, driven by the CI gate
`.github/workflows/t1-signoff.yml`:

| Tool | Version | Install path |
| --- | --- | --- |
| klt (klayout-tools) | `0.8.0` | `uv tool install "klayout-tools==0.8.0" --with klayout==0.30.12`, or a venv: `pip install "klayout-tools==0.8.0" "klayout==0.30.12"` |
| klayout (engine under klt) | `0.30.12` | same install; `klayout_tools.build_identity.klayout_version_expected()` |

```sh
klt --version       # -> klt 0.8.0
python -c "import klayout; print(klayout.__version__)"   # -> 0.30.12
```

The install is pinned the same way in CI (`klayout-tools==0.8.0`,
`klayout==0.30.12`) so the committed evidence record
(`manifests/t1-signoff-report.json`) and every re-grade are produced by the
same grader build.

**Why the engine is pinned too.** klt declares `klayout>=0.30`, so an
unpinned install resolves whatever klayout is newest that day; klt 0.8.0
build-tests against `klayout==0.30.12` and stamps
`provenance.klayout_version_mismatch: true` (plus a stderr warning that
"DRC/LVS report counts … may differ") on any other engine. Measured on this
repo's own layout, klayout 0.30.10 and 0.30.12 produce a `klt drc` envelope
that is identical field-for-field apart from that version string and
boolean — but the committed envelope should not carry a self-declared
reproducibility warning, so the pin names the engine klt expects.

**For `klt extract --parasitics` the pin is load-bearing, not cosmetic**
(issue #57). *Historical measurement at the 0.6.0 pin* (issue #123 re-measured
the current pin: the released klt 0.7.0 on this repo's *previous* GDS gave
14.696 kΩ, i.e. the "off-pin" 14.70 kΩ below is what the released 0.7.0
reproduces on that layout, and klt 0.7.0 gives identical totals under klayout
0.30.10 and 0.30.12 on the current layout). Measured on this repo's own `layout/comparator.gds`, klt `0.6.0`
on klayout `0.30.10` and an unreleased klt `0.6.0+g1828313bdf02` on klayout
`0.30.12` produce **bit-identical capacitances** but total series resistance
**17.52 kΩ vs 14.70 kΩ** — 1.19× overall and up to **2.30×** on an individual
net. Post-layout simulation results are therefore not comparable across
builds, so `layout/extract_pex.py` *asserts* the two versions above out of
the extraction envelope's own `provenance` block and refuses to write
anything off-pin; `layout/extract_pex.py --check` re-asserts it against the
committed `layout/extract-parasitics.json` and runs as a CI gate in
`t1-signoff.yml`'s `layout-device-count` job. If the host `klt` is off-pin,
use a **throwaway** environment rather than changing host tooling:

```sh
uv venv /tmp/pex-pin-env
uv pip install --python /tmp/pex-pin-env/bin/python \
    "klayout-tools==0.8.0" "klayout==0.30.12"
PATH=/tmp/pex-pin-env/bin:$PATH python3 layout/extract_pex.py
```

Bumping the pin is deliberate and lands in one change: this doc, both CI
installs, `layout/extract_pex.py`'s `PINNED_*` constants, and the regenerated
artifacts together — the same policy `t1-signoff.yml`'s own header states.

Signoff runs pass `--tiers-doc manifests/design-evidence-tiers.md` — a
vendored, pinned copy of the klayout-tools checklist doc — so the record is
graded against a fixed checklist revision rather than whatever the installed
klt happens to ship. See `manifests/README.md` for the regeneration command,
the pin policy, and the honest current verdict.

`sim/toolchain.json` is the machine-checked pin this repo's harness actually
enforces (`sim/harness/toolchain.py`'s `check_env()`, driven by
`python3 sim/run_corners.py --check-env` — see step 4 below): `ngspice_min_major:
46` is a **floor** (newer is fine, older is refused), `xschem_tag: "3.4.7"`
is checked but only ever produces a **warning** on drift (every evidence
record already pins its own netlist by SHA-256, so an xschem difference
doesn't invalidate anything — see `sim/harness/toolchain.py`'s module
docstring), and `python_min: "3.9"` is a floor. `ciel`'s own version isn't
pin-checked by the harness at all (CI pins `ciel==2.6.1`); it only needs to be new enough to fetch
and enable the `open_pdks` commit pinned below.

If a tool is genuinely missing on your machine, this repo does not document
a from-scratch build recipe for it — install via your platform's package
manager (Homebrew, apt, a venv for `ciel`, etc.) and re-run the version
commands above before continuing.

## 1. Verify xschem works headlessly

A bare sanity check that doesn't need any PDK wiring at all — netlist one of
xschem's own stock examples (ships alongside the binary; the exact path
depends on your install, e.g. `/usr/share/doc/xschem/examples/` on a
Debian/Ubuntu package install):

```sh
mkdir -p /tmp/xschem_check
xschem -n -q -x /usr/share/doc/xschem/examples/cmos_inv.sch -o /tmp/xschem_check
ls /tmp/xschem_check   # -> cmos_inv.spice
```

Verified on this pass: exits 0 and writes `cmos_inv.spice` with no
`error`/`warning` lines. If your install doesn't ship that particular
example, substitute any other `.sch` under the same examples directory —
this step only proves the xschem binary itself runs headlessly, not
anything sky130-specific.

## 2. Fetch + enable the sky130 PDK via ciel

Use this repo's own `sim/pdk.json` `install_command` verbatim:

```sh
pip install ciel==2.6.1
ciel enable --pdk-family sky130 -l sky130_fd_pr f6eeac7dad085ffcc829ccfd721f7b4ce39edcf7
```

**Why this specific `open_pdks` commit, not "newest available":**
`sim/pdk.json`'s own `notes` field states it is kept identical to
`sky130-bandgap`'s and `sky130-sar-adc`'s pin, specifically so PVT/model
provenance is comparable across every sky130 canary in this workspace — a
newer commit would silently make this repo's numbers incomparable with its
siblings'.

After `ciel enable`, `~/.ciel` contains PDK variant symlinks:

```sh
ls -la ~/.ciel | grep sky130
# sky130A -> ciel/sky130/versions/f6eeac7dad085ffcc829ccfd721f7b4ce39edcf7/sky130A
# sky130B -> ciel/sky130/versions/f6eeac7dad085ffcc829ccfd721f7b4ce39edcf7/sky130B
cat ~/.ciel/sky130A/SOURCES | grep open_pdks   # -> open_pdks f6eeac7dad085ffcc829ccfd721f7b4ce39edcf7
```

This repo standardizes on the **`sky130A`** variant (`sim/pdk.json`'s
`variant` field), matching its sky130 siblings.

## 3. Environment convention: `PDK_ROOT` / `PDK`

Rather than hand-exporting `PDK_ROOT`/`PDK` yourself, this repo already
ships `sim/env.sh`, which resolves both by calling `sim/run_corners.py
--print-env` (`sim/env.sh` lines 19-24) — the same resolution the harness
itself uses for every simulation run, so an interactive xschem/ngspice
session sees exactly the PDK the corner runner and Monte Carlo runner would
use:

```sh
source sim/env.sh
# -> sky130: PDK_ROOT=/home/you/.ciel PDK=sky130A
```

If it instead prints `sky130: PDK not found -- run 'python3
sim/run_corners.py --check-env'`, the PDK from step 2 above hasn't been
enabled yet (or was enabled at a different commit than `sim/pdk.json`
pins).

## 4. Final verification

Run the harness's own environment check — it exercises the exact same
toolchain/PDK pins as every other step above, in one command:

```sh
python3 sim/run_corners.py --check-env
```

Exit codes (see `sim/README.md`'s "Quick start" and
`sim/harness/toolchain.py`'s own docstring for the full rationale):

- **0** — everything installed and within pin (warnings, e.g. an xschem
  version drift, may still print but don't fail the check).
- **1** — a pinned tool is installed but has **drifted** from
  `sim/toolchain.json` / `sim/pdk.json` (e.g. ngspice below the
  `ngspice_min_major` floor, or a different `open_pdks` commit than pinned)
  — a real problem, because results from a drifted toolchain aren't
  comparable with the evidence already committed under `sim/`.
- **3** — a required tool (ngspice) or the PDK itself is simply **missing**
  — expected and skippable on a machine that hasn't been bootstrapped yet;
  go back to steps 1–2 above.

Once `--check-env` exits 0, the next step is `sim/selftest.sh` — this
repo's one-command harness acceptance test (unit tests, the environment
check again, an end-to-end PVT sweep and Monte Carlo run, and a negative
control that must fail on purpose). See `sim/README.md`'s "The harness
acceptance test" section for what each of its four stages proves and how
long it takes.
