2AMLogic/sky130-comparator/(commit log)

2026-09-05 Initial commit: a dynamic latched comparator on skywater sky130
    Scaffolds the block: spec, schematics, ngspice sim, and klayout-tools-driven
    layout signoff. Wave-5 canary (2am#689, operator-approved 2026-09-05).
    sky130 StrongARM comparator. Completes the comparator twin set; 1.8 V low-headroom member.
    Apache-2.0. Nothing designed yet.
    Claude-Session: https://claude.ai/code/session_01JhTeitSU4grgVCvMJ13XAg
2026-09-05 feat(champion): standing authorization for design-evidence auto-merge (#6850)
    Operator ruling 2026-09-05: Judge-approved, green-CI PRs whose entire
    changed-file set lives in design/, sim/, layout/, measurements/,
    verification/, or docs/ auto-merge without the four-axis human hold.
    Rationale: canary design evidence is fully revertible with no fleet-infra
    blast radius, and the held-PR pattern (sky130-sar-adc#123 sat mergeable for
    days as the sole blocker of a layout chain) costs more than it protects
    here. spec/ and every tool surface fall outside the patterns, so the
    exact-subset rule keeps them on the four-axis judgment automatically.
    C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
2026-09-06 docs: bootstrap target-spec table, porting plan, and DR-process note (#5)
    Fills in the README's DRAFT target-spec table with a real per-corner
    bounds table (offset sigma, input-referred noise, decision time vs.
    overdrive, kickback, supply/power), each row citing its basis rather
    than asserting a bare number, since no sibling has a ratified
    comparator spec to port yet (sg13g2-comparator and gf180-comparator
    are simultaneous wave-5 standups at the same bootstrap stage).
    Adds spec/porting-plan.md naming sky130-sar-adc's sim/comparator-decision/
    as the primary port source (methodology, not numbers), and expands
    spec/README.md to name the decision-record process explicitly,
    mirroring sky130-band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
2026-09-09 sim: port sky130-sar-adc's harness plumbing + sim/pdk.json pin (#10)
    Ports sim/harness/{pdk,toolchain,corners,evidence,measure,testbench,
    runner,mc_runner,cli,mc_cli}.py, sim/run_corners.py, sim/monte_carlo.py,
    sim/pdk.json, sim/toolchain.json, sim/env.sh, sim/spiceinit, and
    sim/tests/test_harness.py from 2AMLogic/sky130-sar-adc (commit
    b80c144efbf467a586f728726cabb25c1eb5a1f2), per spec/porting-plan.md's
    "Next steps" item 2. Same PDK (sky130), so every module ported unchanged
    beyond provenance-citation docstrings -- no CDAC/sequencer-specific code
    existed to strip.
    Adds two harness self-test experiments (harness-corner-smoke,
    mc-smoke -- also ported from the same commit) as the one-command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
2026-09-09 sim: simplify _draw_n in mc_runner.py, drop unused callback abstraction (#15)
    _draw_n's Callable/TypeVar-parameterized shape was ported unchanged from
    sky130-sar-adc, where a second caller with different netlist-build logic
    needs that generality. This repo has exactly one caller (mc_runner.run()),
    invoked twice with the same concrete draw/parse logic both times, so the
    callback layer bought nothing here. _draw_n now builds the netlist and
    calls toolchain/measure directly; run()'s duplicated one_draw/describe
    closures are gone along with the now-dead Callable/TypeVar imports.
    Closes #14
2026-09-09 sim: remove dead resolve_provenance()/ProvenanceInfo from evidence.py (#18)
    resolve_provenance() and its ProvenanceInfo dataclass were ported wholesale
    from sky130-sar-adc (#10) but never wired into a caller here -- both
    write_evidence() implementations (runner.py, mc_runner.py) still do their own
    inline pdk/ngspice/netlist-snapshot preamble. The docstring's issue
    references (#235, #20, #217) belong to the sibling repo, not this one.
    Removes the dataclass, the function, and the now-unused `pdk`/`toolchain`
    imports it required. No behavior change -- nothing called these symbols.
    Closes #17
2026-09-09 sim: add missing provenance docstring to measure.py (#19)
    measure.py was the one sim/harness/ module missing the per-file
    provenance paragraph documenting its port from sky130-sar-adc (issue
    #8); the other 10 harness modules already carry it. Docstring-only
    change, no logic touched.
    Closes #12
2026-09-09 sim: stand up sim/comparator-decision/ regen/offset/noise experiments (#20)
    Ports the regen/offset/noise measurement methodology (not numbers) from
    2AMLogic/sky130-sar-adc's sim/comparator-decision/run.py into a standalone
    experiment directory here, with its own ideal-stimulus testbench and a
    placeholder DUT fragment (borrowed verbatim, not this repo's own topology
    decision -- design/comparator.sch is out of scope, per spec/porting-plan.md
    next step 1). Proves the ported plumbing runs end to end against the real
    sky130 PDK/ngspice toolchain: one committed record per experiment at the
    nominal (tt/27C/1.8V) corner.
    Implements spec/porting-plan.md's "Next steps" item 3.
    Closes #9
    Co-authored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
2026-09-15 spec: comparator topology decision record (DR-001) (#22)
    Commits design/comparator.sch (porting-plan next step 2) to a topology
    class before it's drawn: a single-tail dynamic latch with no static
    preamp, per this repo's own 1.8 V headroom quantification (a fresh
    ngspice .op vth probe, spec/dr-001-support/vth_probe.spice, run across
    tt/ss x 27C/-40C on this repo's own installed sky130 PDK).
    That probe converges cleanly at ss/-40C where sky130-sar-adc's DR-003
    did not, and finds a negative headroom margin at that corner under a
    conservative planning-overdrive convention -- a harder result than the
    same argument produced on the sibling PDK/repo, carried forward as a
    named open item for the siz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
2026-09-16 design: draft design/comparator.sch + derived netlist per DR-001 (#25)
    Implements DR-001's single-tail, bottom-tail NMOS-input dynamic latch as
    this repo's first real schematic, replacing the sky130-sar-adc-ported
    placeholder DUT that every sim/comparator-decision record until now
    exercised (issue #3's T1 checklist item 9).
    Topology and reset scheme are DR-001's, unchanged. What is new here is the
    sizing, which DR-001 explicitly left open, derived first-principles against
    this repo's own installed models rather than scaled from the placeholder:
    - Input pair W=10um from an offset budget built on this PDK's own Pelgrom
    coefficients (AVT_n = 3.356 mV.um, AVT_p = 5.856 mV.um), read out of th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
    [comparator.sch]
2026-09-16 feat: add kickback input-node disturbance experiment (issue #26) (#27)
    Adds an original comparator-decision `kickback` sub-command -- no
    same-PDK standalone prior art exists to port for this measurement
    (spec/porting-plan.md "Next steps" item 4). Drives VINP/VINN through
    an explicit 1 kOhm series resistor from an ideal source (the
    target-spec Kickback row's own stated methodology assumption), applies
    a 50 mV decision-guaranteeing overdrive across the same reset->evaluate
    edge regen/reset already use, and measures the peak input-node
    disturbance during that edge. A zero-source-impedance `ideal` control
    variant proves the deck is actually sensitive to the effect: it must
    (and does) collapse to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
2026-09-16 spec: DR-002 target-spec ratification pass (porting-plan next step 5) (#29)
    Ratifies the Offset sigma, Input-referred noise, and Kickback rows of the
    README target-spec table against real measurements of design/comparator.sch
    (sim/comparator-decision/records/); Decision time vs. overdrive and
    Supply/power stay explicitly DRAFT/open pending a full PVT sweep and a
    power measurement, respectively. The Kickback bound is ratified unchanged
    despite a ~29x/~72x measured deviation, per CLAUDE.md's "do not relax the
    ratified spec to make results pass" -- a mitigation design pass is
    recommended as follow-on work instead.
    Closes #28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
2026-09-21 feat: grade T1 state via klt signoff manifest + CI re-run gate (#32)
    Replace the hand-maintained gap-to-T1 checkbox list with the mechanical
    grader contract (issue #31): a block manifest declaring this block's
    identity and kind, a vendored pin of the 11-item design-evidence-tiers
    checklist (klt 0.5.0 ships 10), the committed byte-for-byte klt signoff
    JSON evidence record, and a CI gate that re-runs the signoff on every
    push so a citation rotting against a changed artifact fails instead of
    passing by hand-read.
    Every T1 item honestly grades unmet/no_evidence today: no klt JSON
    envelope exists yet to cite. The gate's hermetic selftest proves the
    rot detector bites (negative controls); tracker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
2026-09-21 feat: add ~250ps soft-clock shaper, cutting comparator kickback 41% (#35)
    - design: R_CLKS (res_high_po poly) + M_CLKCAP (nfet MOS cap) form the
    internal node CLKT; all five clocked gates (tail switch + four
    precharge PMOS) now hang off CLKT so the whole evaluate onset is
    slew-limited, shrinking the input-pair-mediated kickback from 144.598
    to 85.707 mV peak at the DR-002-cited tt/27C, 1kOhm, 50mV point
    - netlist.sh: expects 12 XM_ device lines + 1 XR_ resistor line; header
    re-documenting the 13-device design
    - run.py: noise sub-model biases CLKT at the same steady evaluate level;
    kickback/offset/noise records state their DR-002-ratified-bound
    comparisons explicitly; offset pic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
    [comparator.sch]
2026-09-22 feat: static preamp ahead of StrongARM latch, closing the kickback gap (DR-004) (#40)
    * feat: static preamp ahead of StrongARM latch, closing the kickback gap (DR-004)
    Supersedes DR-001's no-static-preamp clause with a continuously-biased
    resistive-load NMOS preamplifier (M_PTAIL + M_PINN/M_PINP widened to 13um
    as the noise lever + 30kohm poly loads + OUT1 absorber caps) ahead of the
    clocked StrongARM latch stage; DR-003's soft-clock shaper retained on the
    clock port. The double-tail route was evaluated first and measured still
    ~1:1 kickback/speed elastic (committed probe deck under
    spec/dr-004-support/).
    Measured against the ratified rows, all records append-only under
    sim/comparator-deci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
    [comparator.sch]
2026-09-23 feat: full-corner Monte Carlo + PVT campaign (DR-005) -- ratify Decision-time, complete every row's corner set (#43)
    * feat: noise-tran subcommand + parallel jobs for the full-corner campaign (issue #41)
    Add a regeneration-inclusive input-referred noise measurement
    (noise-tran) via transient-noise Monte Carlo with equivalent-source
    injection: per-side TRNOISE sources at the comparator inputs (the AC
    preamp figure) and in series with the steering gates (a new
    steering+tail AC sub-model's gate-referred figure), propagated through
    the full committed fragment's real clocked evaluate trajectory, with a
    pick-off MC as the primary statistic and a decision-transition
    pair-symmetric cross-check for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
2026-09-23 feat: add klt-generated comparator GDS layout with device-count CI gate (#45)
    16-device DR-004 topology as one composed top cell: every device from
    klt gen (common-centroid cross-quad input pair, folded res_array loads,
    symmetric pairs), placement and all wiring from a deterministic met1/met2
    router in layout/gen_comparator.py, klt draw + gen-compose as placer only.
    Composed DRC clean; klt extract re-derives the 16 devices by model
    (9 nfet_01v8, 4 pfet_01v8, 3 res_high_po), asserted on every push by
    scripts/check-layout-device-count.py. Body ties drawn (substrate tap GND,
    merged-well tap VDD). integrator-view gds.path + measured_area flip from
    nulls. T1 signoff manifest deliberately undecora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
2026-09-24 chore: bump the klt pin to 0.6.0 (+ klayout 0.30.10) and regrade the record (#51)
    klt 0.5.0 predates two signoff disclosures that this repo's T1 evidence
    record depends on: `citation.input_verified` (klayout-tools #2196) and
    `citation.coverage` (#2002). Under the old pin, scripts/check-t1-signoff.py
    rule 3 fired its documented `input_verified: null` warning on item 3's
    citation on every run, and the tier report carried that citation with no
    coverage block at all.
    Pin sites moved together: both CI installs, docs/environment-setup.md's
    tooling table, layout/README.md's toolchain pin, gen_comparator.py's
    KLT_PIN (and layout/extract-device-count.json's recorded tool.klt_pin,
    regenerated), and m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
2026-09-25 sim: drop the never-called _run_ts_retry helper (#52) (#53)
    `_run_ts_retry` ran one noise-tran deck and retried it once at
    NOISE_TRAN_RETRY_TS on RuntimeError, but nothing ever called it:
    `_run_many_ts_retry` -- the function both campaign call sites use
    (run.py:1429, run.py:1478) -- reimplements the same two-grid retry inline
    in its single-worker and ThreadPoolExecutor branches plus the shared
    `for name, build in failed:` loop. Both functions were added together in
    #43, so this is not a helper stranded by a later refactor;
    `_run_many_ts_retry` simply never adopted it.
    Zero callers means deleting it cannot change run.py's behavior, and the
    retry semantics stay live via `_run_many_ts_retry` (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
2026-09-25 layout: commit the LVS signoff envelope and cite it for T1 item 4 (#54)
    Runs `klt lvs` (klayout engine, klt 0.6.0) over the committed
    `layout/comparator.gds` against the item-1 schematic netlist that
    `design/netlist.sh` derives from `design/comparator.sch`, commits the
    envelope plus its request document, and cites it from the block manifest.
    `t1_met_count` goes 1 -> 2 of 11.
    The verdict is `status: "match"`, 0 errors, 16/16 devices, 12/12 nets,
    7/7 pins, `power_connectivity.status: "unchecked"`, `body_verification:
    "verified"`. The reference netlist and the schematic were not touched.
    What that match does NOT verify is disclosed at length in layout/README.md,
    because it is narrower than it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
2026-09-25 layout: withdraw the T1 item-4 LVS citation — the match has the known delta in its blind spot (#55)
    Follow-up correction to #54 (issue #49), which landed the `klt lvs` run and
    cited it for T1 item 4. The run and the envelope are right and stay; the
    citation does not.
    #54's citation rests on one premise, stated in its own disclosure: the
    drawn-versus-schematic resistor width delta is outside the compare because
    "it is simply not a dimension the tool compares, for any resistor, for
    anybody" -- nothing waived, nothing tolerated. That premise is not accurate.
    `klt lvs` can compare a resistor's geometry, via `options.compare_parameters`,
    and when asked it reports this block's delta as an error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
2026-09-25 scripts: extract the shared fail/ok/load_json gate helpers (#56) (#60)
    `check-integrator-view.py` and `check-t1-signoff.py` each carried their own
    byte-for-byte copy of `fail()`, `ok()` and `load_json()` plus a `FAILURES`
    tally, so the `"gate: FAIL: "`/`"gate: ok: "` output convention and the
    three-way JSON-load error wording had two hand-maintained sources and
    nothing to catch a script drifting from the other.
    Collapse them into `scripts/_gate_common.py` (`FAILURES`, `WARNINGS`,
    `fail`, `warn`, `ok`, `load_json`, `reset`) and import from both gates --
    the same drift-prevention move `check-layout-device-count.py` already makes
    by importing its counter from `layout/gen_comparator.py`.
    Pure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
2026-09-25 layout: post-layout (extracted-netlist) re-simulation for the comparator (T1 item 7) (#67)
    * layout: extract the parasitics-annotated DUT and teach run.py to simulate it
    Post-layout (extracted-netlist) re-simulation needs two things this repo did
    not have: an extracted, parasitics-annotated netlist of the committed layout,
    and a way to point the comparator-decision bench at it instead of at the
    schematic fragment. This commit adds both; the measurements themselves follow.
    `klt pex` is the canonical path and is NOT usable here, for a reason that is
    not the missing `.include` line. `klt pex` re-runs **`klt sim` request JSON**
    testbenches, whose `measurements[]` entries are verbatim `.meas` c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
2026-09-25 scripts: finish the _gate_common extraction (selftest tally + dispatch tails) (#72)
    The #56/#60 extraction moved fail/ok/warn/load_json into
    scripts/_gate_common.py but left two blocks copy-pasted: the selftest case
    tally (byte-identical in check-integrator-view.py and check-t1-signoff.py)
    and the main() parse/dispatch/ValueError tail (likewise). A third,
    hand-rolled copy of the selftest convention in check-layout-device-count.py
    had already drifted, printing `gate: selftest: PASS` instead of
    `selftest: all N cases passed`.
    Add report_cases() and dispatch() to _gate_common.py and route all three
    gates through them, so the selftest output convention and the
    `gate: FAIL: <exc>` dispatch tail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
2026-09-25 sim: qualify ported foreign issue citations and drop two fictional call sites (#73)
    Ten comment/docstring sites in sim/ cited bare `issue #N` numbers that are
    2AMLogic/sky130-sar-adc's, not this repo's. This repo tops out at #71 today,
    so they resolve to nothing now and will silently resolve to unrelated LOCAL
    issues once numbering passes #127. Qualify each with the origin repo, in the
    form sim/harness/evidence.py:142 already established ("sky130-sar-adc issue
    #131 ... that repo's PR #130").
    All five cited numbers were verified against 2AMLogic/sky130-sar-adc, and
    every title matches its citation's context:
    #127 corner-matrix-summary dedup, #133 hardcoded 120s ngspice timeout,
    #195 _pdk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
2026-09-25 layout: klt erc supply-spec run for T1 item 11, committed and deliberately uncited (#76)
    Produces the ERC half of T1 item 11 ("Power delivery (structural)") as
    committed, falsifiable evidence, and resolves the issue's explicit
    claim-integrity judgement call: the compound item-11 citation is NOT added.
    New evidence (all regenerated by `python3 layout/gen_comparator.py`,
    byte-stable across re-runs, and reproducing every pre-existing artifact
    unchanged):
    - layout/erc-spec.json -- the supply spec: poly/li1/met1/met2 conductor
    roles with licon1/mcon/via between them, VDD and GND declared
    "kind": "supply", and a ties[] entry for each of the p-substrate tap
    (native-substrate form: well_laye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
2026-09-25 docs: drop stale bootstrap-era claims from sim/README.md (#77)
    The harness-bootstrap pass (#8) left present-tense statements in
    sim/README.md that the repo has since falsified:
    - Divergence note 1 ("target-spec table is DRAFT, not ratified") —
    DR-002 ratified three rows and DR-005 ratified Decision time; only
    Supply/power remains DRAFT/OPEN.
    - Divergence note 2 ("No comparator schematic exists yet") —
    design/comparator.sch exists and sim/comparator-decision/ has landed.
    - The base-fields "Claim" bullet asserted the table is "currently
    **DRAFT**". Keep the rule it was enforcing (a claim naming a row that
    is still DRAFT/OPEN must say so; a DRAFT value is never quoted as if
    set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
2026-09-25 sim: complete the post-layout PVT campaign across the graded corners (#81)
    * sim: add the remaining graded-corner anchors and derive kickback's subset justification from the corner actually run
    The post-layout campaign differences each corner against its schematic-level
    counterpart at the SAME corner, so SCHEMATIC_BASELINES needs an anchor at all
    seven DR-005 graded corners, not just the two issue #57 measured. Adds the
    five remaining `regen` anchors and the six remaining `kickback` anchors,
    each transcribed from the named committed record.
    kickback_subset_justification() replaces a fixed string that asserted every
    kickback record measured tt/27C -- true when issue #30 minted it, false the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
2026-09-25 sim: give reset and noise-tran a post-layout deck form, and run both (#82)
    * sim: give reset and noise-tran a post-layout deck form via star-leg retie
    Both sub-commands build their decks by moving ONE terminal of the latch
    steering pair. On the extracted netlist that was not a well-defined
    operation, so both refused `--dut extracted`. Decide the three rules the
    refusal deferred and implement them, documented next to the code:
    - a schematic device name resolves to EVERY drawn instance of it (split
    fingers move together);
    - a moved terminal's parasitic star leg travels WITH the terminal -- the
    leg resistor's hub end is re-pointed and the device line is never
    edited, so nothing is stran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
2026-09-26 docs: correct sim/README.md's stale placeholder-DUT claim for comparator-decision (#84)
    The "Harness self-test experiments" section said sim/comparator-decision/
    "exercises a placeholder DUT, not a real design/comparator.sch". That has
    been false since issue #24: testbench/comparator_core.spice is generated
    from design/comparator.sch by ./design/netlist.sh, and the file it cites as
    its authority (sim/comparator-decision/README.md:114-142) says so directly.
    Left uncorrected, the sentence tells a reader that every record under
    sim/comparator-decision/records/ characterizes a placeholder circuit, which
    would wrongly discount the evidence behind four ratified spec rows.
    State the present tense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
2026-09-26 docs: aggregate the characterization report and cite it for T1 item 8 (generic evidence envelope) (#87)
    * docs: aggregate the characterization report and cite it for T1 item 8
    Builds the one aggregated, current artifact T1 item 8 names and cites it
    through `klt signoff`'s opt-in generic evidence envelope, moving
    `t1_met_count` 1 -> 2. No simulation was run: every figure is copied from a
    record already committed under `sim/comparator-decision/records/`.
    `sim/characterization-report.md` covers all five target-spec rows -- Offset
    sigma, Input-referred noise, Decision time vs. overdrive, Kickback,
    Supply/power -- each with its ratification status, bounds, the measured
    figure at every condition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
2026-09-26 sim: post-layout offset campaign at the four remaining _mm mismatch corners (#88)
    * sim: post-layout offset at ss_mm/27C, and the four schematic anchors it differences against
    Issue #80, first of the four `_mm` mismatch corners issue #64's post-layout
    PVT campaign deliberately skipped.
    `SCHEMATIC_BASELINES` gains the four non-`tt` `_mm` offset anchors from the
    issue #41 schematic-level campaign, transcribed from the named committed
    records. Without them `post_layout_delta_lines()` falls back to its "no
    committed counterpart" note and each post-layout run records a bare number
    instead of the delta issue #57's methodology requires.
    `OFFSET_GRADED_CORNERS` names `offset`'s own graded axis, w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
2026-09-26 chore: resync installed Loom surfaces
    Local main was 3 commits behind origin/main; refresh .loom/ and
    .claude/ from defaults/ before running this sweep so it executes
    current orchestration logic.
2026-09-26 scripts: drop the unused Counter import from the device-count gate (#93)
    `scripts/check-layout-device-count.py` imported `collections.Counter` but
    never referenced it: the counting logic lives in `layout/gen_comparator.py`
    and is imported here as `count_check` / `parse_extract_devices` precisely so
    the CI gate and the generator cannot drift. `ruff check --select F401`
    flagged the import as dead.
    Verified after removal: `ruff check --select F401
    scripts/check-layout-device-count.py` is clean, and the script's hermetic
    `selftest` (the CI `layout-device-count` job's first step) still passes all
    3 cases.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
2026-09-26 sim: post-layout noise-tran at ss/-40C and ff/125C, plus the SCHEMATIC_BASELINES entry gap that blocked both (#96)
    * sim: add the two missing noise-tran BASELINES anchors (ss/-40C, ff/125C)
    `SCHEMATIC_BASELINES` carried a `noise-tran` entry only at `tt`/27C, even
    though the issue #41 schematic-level campaign also committed records at
    `ss`/-40C (20260922-205857-ebea4e2, 0.1213 mV, N=128) and `ff`/125C
    (20260923-010427-ebea4e2, 0.1754 mV, N=128). A post-layout `noise-tran` run
    at either corner therefore printed `post_layout_delta_lines()`'s "No
    committed schematic-level record exists" note -- honest in form but false in
    fact, with the counterpart sitting in `records/` the whole time.
    Adds bo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
2026-09-26 chore: replace description=__doc__ with purpose-written one-liners at two CLI entry points (#97)
    `layout/gen_comparator.py` and `scripts/check-layout-device-count.py` both
    passed the whole module docstring to `argparse.ArgumentParser(description=...)`,
    so `--help` reprinted it as one re-wrapped paragraph (98 and 28 lines) and
    leaked the two `%%` escapes written for that formatting verbatim.
    Both now use a purpose-written one-line description, matching the pattern six
    of the repo's nine argparse entry points already use, and the two `%%` in
    `gen_comparator.py`'s docstring are restored to plain `%`. The module
    docstrings are otherwise unchanged; neither script reads `description` at
    runtime.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
2026-09-26 docs: aggregate #88's four post-layout offset corners into the characterization report (#98)
    `sim/characterization-report.md` row 1 still read "1 of 5 `_mm` corners"
    post-layout while PR #88 (issue #80) had already committed the remaining four
    records, and none of them appeared in the report's Evidence index. The envelope
    still graded `pass` because no *pinned* hash drifted — exactly the hole
    `sim/README.md` describes ("keeping the report current as new evidence lands is
    a human obligation, not an enforced one") — so the derived aggregation and
    `sim/comparator-decision/README.md` disagreed about this row's coverage.
    Row 1 now carries all five `_mm` corners post-layout, with every figure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
2026-09-26 sim: post-layout noise-tran at sf/-40C, sf/125C and fs/-40C -- the last three graded corners (issue #95 item 1)
    Adds the three remaining post-layout noise-tran records at N=32/4:
    sf/-40C (0.0929 mV), sf/125C (0.1682 mV), fs/-40C (0.1084 mV). All
    seven graded corners now have a post-layout noise-tran figure. None
    of the three has a schematic-level counterpart, so each correctly
    prints post_layout_delta_lines()'s "No committed schematic-level
    record exists" note rather than a fabricated ratio -- run.py needed
    no code change, and test_noise_tran_skew_corners_say_no_counterpart_exists
    already pinned the behaviour.
    Every new figure clears both the target (<= 1.0 mV) and stretch
    (<= 0.6 mV) noise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
2026-09-27 docs: --chunk-decks counts campaign decks, not Monte Carlo decks (#104)
    The `--chunk-decks` budget test is `self._ran >= self.chunk_decks`, and
    `_ran` is incremented for every batch dispatched through
    `NoiseTranCampaign.resolve()` -- which includes the four gain-calibration
    decks ("ideal devices, plain corner, NO noise"). So the counter is an
    all-deck counter, exactly as `_stop()` already words it ("after N deck(s)",
    "C of T campaign decks") and as `completed_decks()` / `total_decks()` both
    are.
    Only the two flag descriptions said "Monte Carlo decks". That made the
    documented contract wider than the implementation: on a fresh campaign a
    budget of N reaches N-4 Monte Carlo decks, and any N <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
2026-09-27 ci: run the full sim/tests unit suite instead of the test_extract_pex.py filter
    The step's -p 'test_extract_pex.py' filter narrowed CI to 22 of 159 unit
    tests. The excluded tests (test_harness.py, test_comparator_decision.py)
    are hermetic and stdlib-only -- the same admission criterion the step's
    own comment already applies to the filtered-in file -- so dropping the
    filter makes the step run the identical discovery sim/selftest.sh:68
    already uses for stage 1/4 of the acceptance test.
    Closes #105
    Loom-Story: 2AMLogic/sky130-comparator#105
    Loom-Trace-Id: 970a67fbe7f9005d4c7c8344f22eb3cd
    Loom-Build: 0.19.439 1c9661fc5acace2b982b996d5e67992f07ca07de clean
2026-09-27 refactor: single-source the --check-env reporting block as toolchain.report_env()
    Both --check-env spellings carried a byte-identical copy of the "print
    summary(), then warnings, then messages, then return status" block, and
    the copies had already drifted: only harness/cli.py threaded
    --allow-toolchain-drift, so on an off-pin install
    `run_corners.py --allow-toolchain-drift --check-env` exited 0 while
    `comparator-decision/run.py --check-env` exited 1 on the same machine,
    with no flag on the second spelling that could reach the first's
    behaviour.
    toolchain.report_env(allow_drift=False) now owns that block, beside the
    summary() it prints. The two drivers become one call each, so the
    drift-tole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
2026-09-27 refactor: single-source the selftest fixture skeleton and the star-leg assertion
    Two copy-pasted test-support bodies had already drifted; both now have one
    source of truth.
    `scripts/characterization-envelope.py`: `_make_fixture()` gains an optional
    `extra_files` mapping (repo-relative path -> contents, parents created as
    needed) written immediately BEFORE `run_update()` pins the report's cited
    artifacts -- `sha256_file()` returns None for a path it cannot read, and
    `run_update()` refuses outright on a missing indexed artifact, so writing an
    extra artifact after the pin step would leave the fixture already failing
    before its mutation and make the issue #102 scenario pass for the wrong
    reason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
2026-09-27 docs: state the integrator-view null-accepting rule as standing, not current-state
    Three prose sites (check-integrator-view.py docstring, manifests/README.md,
    and integrator-view.json's provenance.refresh_rule) still described
    gds/measured_area as currently null "because no layout exists." The layout
    landed in 37b8197 (#45); the committed view now carries real values. Rewrite
    the null-accepting rule as a standing rule that applies whenever a field is
    null, rather than a claim about the current file's contents, and drop the
    stale "flip gds/measured_area from null when layout lands" step from the
    refresh rule.
    Closes #115
    Loom-Story: 2AMLogic/sky130-comparator#115
    Loom-Trace-Id: 969d6082e00c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
2026-09-30 docs: embed fleet burndown chart in README
    Adds the one-line fleet burndown chart embed under the intro paragraph
    so live progress is visible here the same way it is in 2AMLogic/2am.
    Loom-Story: 2AMLogic/sky130-comparator#42
    Loom-Trace-Id: fcbc6a7d0617047936e0a24e31e72278
    Loom-Build: 0.19.516 af6fab7706275c1984b9e52cb042b4491fc271a2 clean
2026-10-01 chore: resync installed Loom surfaces
    resynced_by: fleet-resync
    invocation: fleet-resync.sh --fleet-only --push
    <!-- loom:provenance v1 build=unknown 19f4e67fd0a0afbd3d8b6606ca91ceac911377a3 clean prompts=none sweep=none story=none trace=78a5dfbdfd8c530aecd1bb436fd096df host=loom-worker-2 base=852a0e79c0d8d5908472191909c112b316784826 run=loom-run/v1:timer:loom-worker-2/fleet-resync:67c759f7ef3c43e38d3fa8d5f19a2dd1 installs=0.19.593 658650a4f0eff932ac66a8f690eaedf8123fc83b -->
    Loom-Story: none
    Loom-Trace-Id: 78a5dfbdfd8c530aecd1bb436fd096df
    Loom-Build: unknown 19f4e67fd0a0afbd3d8b6606ca91ceac911377a3 clean
2026-10-01 chore: resync installed Loom surfaces
    <!-- loom:provenance v1 build=unknown 56435bf476452911283e43940ecfd9a30f804af9 clean prompts=none sweep=none story=none trace=2b293b15a926fd8e83ad4f2296c20cc1 host=loom-worker-1 base=a743d7920ec8a0b2dd555a67c8bb062efd69ba09 run=loom-run/v1:timer:loom-worker-1/fleet-resync:981eee90a8c04bb5980e1eedc93b2064 installs=0.19.603 8c39bf7cde8a8c03d1aaee441f397c017b6a3a9e -->
    Loom-Trace-Id: 2b293b15a926fd8e83ad4f2296c20cc1
    Loom-Build: unknown 56435bf476452911283e43940ecfd9a30f804af9 clean
    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
2026-10-01 chore: resync installed Loom surfaces
    <!-- loom:provenance v1 build=unknown f2868e6b4d60d11a8ab47d25cad9e248229d2f66 clean prompts=none sweep=none story=none trace=4e2766ed5160781df891476246a9be2e host=robb-studio base=09af57c381caf55bd4ae57651d9cde7a173e9412 run=loom-run/v1:timer:robb-studio/fleet-resync:2d3851d5-1673-43ae-bcc6-e5c971b37f33 installs=0.19.603 74778a6aeea5d9e06b489400942b35f33c8bb766 -->
    Loom-Trace-Id: 4e2766ed5160781df891476246a9be2e
    Loom-Build: unknown f2868e6b4d60d11a8ab47d25cad9e248229d2f66 clean
    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
2026-10-01 chore: resync installed Loom surfaces
    <!-- loom:provenance v1 build=unknown d6714830391f7596338b8de40ee2d0f45dcd12f5 clean prompts=none sweep=none story=none trace=af273f717e759e690d07f372734e9278 host=robb-pro base=2526076f3fc3d93378c26f4a5ee02089b8634e81 run=loom-run/v1:timer:robb-pro/fleet-resync:92e2f9ba-d083-411b-833b-ae52d169ef04 installs=0.19.605 6eb2b65a4496b7becb84ef1f944493a541fd01cd -->
    Loom-Trace-Id: af273f717e759e690d07f372734e9278
    Loom-Build: unknown d6714830391f7596338b8de40ee2d0f45dcd12f5 clean
    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
2026-10-01 chore: resync installed Loom surfaces
    <!-- loom:provenance v1 build=unknown e956e9fee69e53f08b887ca20e14d9058d6f9aee clean prompts=none sweep=none story=none trace=1077dafeb758858c149dd37f4ece3c77 host=loom-worker-2 base=575d2b678fa89346c69eff9343bb6066a472d4b5 run=loom-run/v1:timer:loom-worker-2/fleet-resync:e3773167b12d4b3aafa1f76848245174 installs=0.19.609 ff30576dacc8c2734b1c7434bedd29c47122caeb -->
    Loom-Trace-Id: 1077dafeb758858c149dd37f4ece3c77
    Loom-Build: unknown e956e9fee69e53f08b887ca20e14d9058d6f9aee clean
    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
2026-10-01 chore: resync installed Loom surfaces
    <!-- loom:provenance v1 build=unknown 617257919edc1b9b9ee27532c5ec1b8a64523388 clean prompts=none sweep=none story=none trace=dbafe4f8526617aa07c890721298a080 host=robb-studio base=a344aa0dbf79403f5383517f7753b80c67fb1441 run=loom-run/v1:timer:robb-studio/fleet-resync:1817df66-02cc-4b27-927d-a38485da550a installs=0.19.610 c94891dd526cf6db5ee02045424c6913be522048 -->
    Loom-Trace-Id: dbafe4f8526617aa07c890721298a080
    Loom-Build: unknown 617257919edc1b9b9ee27532c5ec1b8a64523388 clean
    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
2026-10-01 chore: resync installed Loom surfaces
    <!-- loom:provenance v1 build=unknown a2a39ac2736eb2686e2c65412d939e67c0438a7d clean prompts=none sweep=none story=none trace=fc1a121767151aae5bd7427c683b7db6 host=robb-pro base=5d4d85e957306765f2a9b91584c8265841b24354 run=loom-run/v1:timer:robb-pro/fleet-resync:708eb7c8-469d-4783-80b7-bafe142df3c4 installs=0.19.612 d25614656adcf70162da95c5e1035e99a0639a1a -->
    Loom-Trace-Id: fc1a121767151aae5bd7427c683b7db6
    Loom-Build: unknown a2a39ac2736eb2686e2c65412d939e67c0438a7d clean
    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
2026-10-01 chore: resync installed Loom surfaces
    <!-- loom:provenance v1 build=unknown 126c80914e42f913c4fc778d3ddce96daa2c7a77 clean prompts=none sweep=none story=none trace=15a20fbea7a00d0922b943088c80e19d host=loom-worker-1 base=fbac26daa6289cbfbacce9fff4d30573b89a4239 run=loom-run/v1:script:loom-worker-1/fleet-resync:ecc423da-4625-49de-b25a-692fd669a029 installs=0.19.612 53aeb18c5541af6b068247d82f62daed412cc2c6 -->
    Loom-Trace-Id: 15a20fbea7a00d0922b943088c80e19d
    Loom-Build: unknown 126c80914e42f913c4fc778d3ddce96daa2c7a77 clean
    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
2026-10-01 chore: resync installed Loom surfaces
    <!-- loom:provenance v1 build=unknown 126c80914e42f913c4fc778d3ddce96daa2c7a77 clean prompts=none sweep=none story=none trace=a0a42bd10fcfa6d7cbcc9c021c406848 host=loom-worker-2 base=8227dc8785ccb0de60789870b795b11bf0529aba run=loom-run/v1:timer:loom-worker-2/fleet-resync:9e174e6bb0fa41d786e4a86e45632b6f installs=0.19.612 6f0871dc66e62b36d8382ced980d2805bfd97e50 -->
    Loom-Trace-Id: a0a42bd10fcfa6d7cbcc9c021c406848
    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
2026-10-01 chore: resync installed Loom surfaces
    <!-- loom:provenance v1 build=unknown 8891f74a5d568fe3d13937ef37fd64371dd2738f clean prompts=none sweep=none story=none trace=1e216ea76cbd2b72542049c4c18c2817 host=loom-worker-1 base=52b1b7744698d98ea8442d8144fcccf82fab269c run=loom-run/v1:timer:loom-worker-1/fleet-resync:679feba6c0f347d39eb5943ed77dc87b installs=0.19.612 62fa67f8756bdf59fdf744be053e5ef1709f1335 -->
    Loom-Trace-Id: 1e216ea76cbd2b72542049c4c18c2817
    Loom-Build: unknown 8891f74a5d568fe3d13937ef37fd64371dd2738f clean
    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
2026-10-01 chore: resync installed Loom surfaces
    <!-- loom:provenance v1 build=unknown 6f3411c8a63e68097dde01bce8a8422230f54218 clean prompts=none sweep=none story=none trace=9aa0a46bb352b9665fdaa5f5b3b85dd7 host=robb-pro base=dfc0acc6ba4bd63e94fa5cbd60f53bd65b8fc3e5 run=loom-run/v1:timer:robb-pro/fleet-resync:ca419e1d-6646-4678-ac7a-b263e4b5119e installs=0.19.613 d6f32c257ca7cce3da20ff97d432b09c5b74a4c8 -->
    Loom-Trace-Id: 9aa0a46bb352b9665fdaa5f5b3b85dd7
    Loom-Build: unknown 6f3411c8a63e68097dde01bce8a8422230f54218 clean
    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
2026-10-02 docs: correct stale no-schematic claims in sim/harness docstrings
    design/comparator.sch landed in #25; both module docstrings still
    asserted it did not exist. __init__.py now states the boundary-sizing
    rationale in past tense and keeps the smoke experiments' role as the
    harness's own regression; mc_runner.py drops the false parenthetical
    and re-points its sim/README.md citation at the real reason it is not
    the comparator's offset path (sim/comparator-decision/'s bespoke
    driver). Docstring-only; no code touched.
    Closes #99
    Loom-Story: 2AMLogic/sky130-comparator#99
    Loom-Trace-Id: c47d6aad8cedc1dc10e3b830aba9ffef
    Loom-Build: 0.19.606 e922817979378fce79257750fc4b6fc70cf717be clean
2026-10-02 feat: classify regen decision polarity and bisect the decision-referred offset
    regen's crossing test now checks BOTH output signs, so each previously-
    UNRESOLVED point is labeled wrong-polarity or non-decision instead of
    conflating the two. The new offset-bisect sub-command bisects the two
    decision boundaries (wrong-polarity edge, resolved edge) in a 200 ns
    window, reporting either a decision flip (the input-referred systematic
    offset) or a measured non-decision band.
    Measured (six records): at tt/27C extracted, the regen non-resolutions
    were wrong-polarity decisions and the flip is +1.8359 mV against the
    schematic fragment's -0.0391 mV negative control (+1.875 mV layout-induced
    systematic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
2026-10-02 chore: resync installed Loom surfaces
    <!-- loom:provenance v1 build=unknown 13c0a3ef467a888520a6529ab34486ab8be826be clean prompts=none sweep=none story=none trace=41356080f367e491d5ff03f17bb98c27 host=loom-worker-2 base=80152fea3a3ace70c99c214520a7793f9b6c1fbc run=loom-run/v1:timer:loom-worker-2/fleet-resync:44455fbcbab745abb92cea192fafbb1d installs=0.19.614 3c79f7b1d0cc14723e049cff4250ff7330804326 -->
    Loom-Trace-Id: 41356080f367e491d5ff03f17bb98c27
    Loom-Build: unknown 13c0a3ef467a888520a6529ab34486ab8be826be clean
    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
2026-10-02 chore: resync installed Loom surfaces
    <!-- loom:provenance v1 build=unknown ea2dd21f2ba310ec007d047ddfecc6cd27d220ac clean prompts=none sweep=none story=none trace=f04a67f3922788d2ccdd66578c8d18f9 host=loom-worker-1 base=05b30409063e0a0775c78b603509f2a4964a1ea5 run=loom-run/v1:timer:loom-worker-1/fleet-resync:1c3b601dd998488595adc09040c007d4 installs=0.19.614 79f4897c5d3c78dbfc1b022f77d244838dbf4ccb -->
    Loom-Trace-Id: f04a67f3922788d2ccdd66578c8d18f9
    Loom-Build: unknown ea2dd21f2ba310ec007d047ddfecc6cd27d220ac clean
    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
2026-10-02 chore: resync installed Loom surfaces
    <!-- loom:provenance v1 build=unknown 6f3411c8a63e68097dde01bce8a8422230f54218 clean prompts=none sweep=none story=none trace=acb28d0049e0cc75536f96d503f6e814 host=robb-studio base=fc95c6869567102c0e9b381072aa445cea69b32d run=loom-run/v1:timer:robb-studio/fleet-resync:85d2b1b5-e81d-40c3-ab6a-9a00efbc4ee2 installs=0.19.616 d86523eeadb32b95777f3cd3a76dd2f72f0bf792 -->
    Loom-Trace-Id: acb28d0049e0cc75536f96d503f6e814
    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
2026-10-02 chore: resync installed Loom surfaces
    <!-- loom:provenance v1 build=unknown 2b50bd69eddd038dd738465aa58a9ebca11410ac clean prompts=none sweep=none story=none trace=324e4f607054d0396cfdf8fdc01e93ae host=robb-pro base=8c8c6848827f8b47956bcd736097c1b57dceb0a1 run=loom-run/v1:timer:robb-pro/fleet-resync:a63799f1-2ad7-4946-b81d-2ec231bc2d2f installs=0.19.617 81cb2ad7e091b19d6a2b95d1add6938c2100d46b -->
    Loom-Trace-Id: 324e4f607054d0396cfdf8fdc01e93ae
    Loom-Build: unknown 2b50bd69eddd038dd738465aa58a9ebca11410ac clean
    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
2026-10-02 chore: resync installed Loom surfaces
    <!-- loom:provenance v1 build=unknown 00d92b326aed50280cd90dc116b7caec27668251 clean prompts=none sweep=none story=none trace=9a5d23cc82b6d3a1c83bfee47bd04970 host=loom-worker-2 base=1fa94aca2f4a7785e1c753b22f874683069552a1 run=loom-run/v1:timer:loom-worker-2/fleet-resync:12136a7a025d49f3a60b5edb04a3ff81 installs=0.19.619 4c0f505e4f0b76f8ccec07bda6d8b839030c077b -->
    Loom-Trace-Id: 9a5d23cc82b6d3a1c83bfee47bd04970
    Loom-Build: unknown 00d92b326aed50280cd90dc116b7caec27668251 clean
    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
2026-10-02 chore: resync installed Loom surfaces
    <!-- loom:provenance v1 build=unknown 456dad6d90259846313dc3bb80bf4e5471ef2d76 clean prompts=none sweep=none story=none trace=bb9688c03fb5211d06f48c8838a5505c host=robb-studio base=aebbec880f2b1f8161a016ca80670a18841ae4f8 run=loom-run/v1:timer:robb-studio/fleet-resync:e965c017-8ec7-485d-b46e-aeb399b81fb4 installs=0.19.620 0d28ba49f5a88fdb37271de9cb0144eb3442c6e3 -->
    Loom-Trace-Id: bb9688c03fb5211d06f48c8838a5505c
    Loom-Build: unknown 456dad6d90259846313dc3bb80bf4e5471ef2d76 clean
    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
2026-10-02 chore: resync installed Loom surfaces
    <!-- loom:provenance v1 build=unknown 6c6d2b6565dc13eff4c6811b9c670f452106516b clean prompts=none sweep=none story=none trace=539be979ae694d66ede516a7b5d17e41 host=robb-pro base=67951d412b9e9b67020ed852029f3b29b794601f run=loom-run/v1:timer:robb-pro/fleet-resync:9444d216-de08-442f-8352-ba59f6e81bb3 installs=0.19.621 a90dc1d794eb9ff70aaf939ebf495abe716f3bdd -->
    Loom-Trace-Id: 539be979ae694d66ede516a7b5d17e41
    Loom-Build: unknown 6c6d2b6565dc13eff4c6811b9c670f452106516b clean
    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
2026-10-02 chore: resync installed Loom surfaces
    <!-- loom:provenance v1 build=unknown f6d28134bfe476967e005d97424073085f55e8a3 clean prompts=none sweep=none story=none trace=27eb90670d441065f593e941066ee005 host=loom-worker-2 base=be467133dd15e6bf9103cec6bfbbfcb013dc9f39 run=loom-run/v1:timer:loom-worker-2/fleet-resync:04001bba930241cf9e325bf304a9270a installs=0.19.623 ccc19c2bbe2aa65328427730fa53f70eb56128c6 -->
    Loom-Trace-Id: 27eb90670d441065f593e941066ee005
    Loom-Build: unknown f6d28134bfe476967e005d97424073085f55e8a3 clean
    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
2026-10-02 chore: resync installed Loom surfaces
    <!-- loom:provenance v1 build=unknown bc461736314499b6c2c4c0ad51fb2294f60336f5 clean prompts=none sweep=none story=none trace=c3ea68717dd3a908dbbd60a35bc8b5d6 host=robb-studio base=5ec2a448b0fa4ca803cdaaa4f7ed7e1a50b5b696 run=loom-run/v1:timer:robb-studio/fleet-resync:8d4c49e2-3258-4080-b0c8-082499053654 installs=0.19.623 a50aaf70069f8897c41a64b7d90783c5ab8294e0 -->
    Loom-Trace-Id: c3ea68717dd3a908dbbd60a35bc8b5d6
    Loom-Build: unknown bc461736314499b6c2c4c0ad51fb2294f60336f5 clean
    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
2026-10-02 chore: resync installed Loom surfaces
    <!-- loom:provenance v1 build=unknown bc461736314499b6c2c4c0ad51fb2294f60336f5 clean prompts=none sweep=none story=none trace=8bee8a664bfc89e0bbfbb3c2de7342ba host=loom-worker-2 base=d8c48116e5f7be3ed24a95c99d2bafc0d34fae34 run=loom-run/v1:timer:loom-worker-2/fleet-resync:de2ceceb48ea4927a1334d08dc0082fe installs=0.19.624 5f49564fa78ae06f8c48d5224dae9ded04200bb7 -->
    Loom-Trace-Id: 8bee8a664bfc89e0bbfbb3c2de7342ba
    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
2026-10-03 chore: resync installed Loom surfaces
    <!-- loom:provenance v1 build=unknown 752d316233ed1a3da9e4f69ad760eb99bb477747 clean prompts=none sweep=none story=none trace=7851839b67c00a023e97cbdea1f580e1 host=robb-pro base=c183a69c0873e191eb53f5ce318f1f3773cc35e5 run=loom-run/v1:timer:robb-pro/fleet-resync:ae492b66-dca0-4da4-acab-8d26778f2d5c installs=0.19.624 121fac45f5006879bf58a18c951b9243d9099a18 -->
    Loom-Trace-Id: 7851839b67c00a023e97cbdea1f580e1
    Loom-Build: unknown 752d316233ed1a3da9e4f69ad760eb99bb477747 clean
    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
2026-10-03 chore: resync installed Loom surfaces
    <!-- loom:provenance v1 build=unknown 3437cece5ab759f772122f8d18a6d2f05d246cde clean prompts=none sweep=none story=none trace=1bd6b75d1c0daff2b433adf5999546a3 host=loom-worker-1 base=ae799ae972d5caf8c20aec4b25713d602424b5be run=loom-run/v1:timer:loom-worker-1/fleet-resync:4c0abac1c29646eaa8502afa223bdd2b installs=0.19.624 0162badc662fb30c070e70611aa8ff74a8486d54 -->
    Loom-Trace-Id: 1bd6b75d1c0daff2b433adf5999546a3
    Loom-Build: unknown 3437cece5ab759f772122f8d18a6d2f05d246cde clean
    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
2026-10-03 chore: resync installed Loom surfaces
    <!-- loom:provenance v1 build=unknown 3437cece5ab759f772122f8d18a6d2f05d246cde clean prompts=none sweep=none story=none trace=bba21427f750636f851279cfae92b4e5 host=loom-worker-1 base=f5de98aaa39081295b59e0ce4ce266b41972f371 run=loom-run/v1:timer:loom-worker-1/fleet-resync:9440cda9476f404caa282e360a81ee03 installs=0.19.636 e41edfbb52c13982f7d8b0577f42957427a6514c -->
    Loom-Trace-Id: bba21427f750636f851279cfae92b4e5
    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
2026-10-03 chore(sim): remove dead ratified_oat_grid and measure anchored=False/missing (#70)
    Loom-Story: 2AMLogic/sky130-comparator#70
    Loom-Trace-Id: 3c57b42ab0cc758effb07f2b11ebb6fb
    Loom-Build: 0.19.633 346aff41fad5597fb95fba4884169fca70f8d121 clean
2026-10-03 chore: resync installed Loom surfaces
    <!-- loom:provenance v1 build=unknown 28040ed11a4369e20f3b7b0154a3fb2a2c35d38c clean prompts=none sweep=none story=none trace=0cd87d01c45d97a2ee57a99363fc0db2 host=robb-studio base=c56aa321b397fba3533eb9fdcab4836c9daabfd2 run=loom-run/v1:timer:robb-studio/fleet-resync:74b93657-6b04-4ac5-bc77-e0a1682b0595 installs=0.19.636 e41edfbb52c13982f7d8b0577f42957427a6514c -->
    Loom-Trace-Id: 0cd87d01c45d97a2ee57a99363fc0db2
    Loom-Build: unknown 28040ed11a4369e20f3b7b0154a3fb2a2c35d38c clean
    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
2026-10-03 chore: resync installed Loom surfaces
    <!-- loom:provenance v1 build=unknown 388c7fe0cad997f7a887f70c9f2cfe8781a2d512 clean prompts=none sweep=none story=none trace=2046ffd42f138a06b914f34851de3440 host=loom-worker-2 base=5c2143110be4cfcf61952054980d7eecd03423aa run=loom-run/v1:timer:loom-worker-2/fleet-resync:17c9456bb1934c70a545b12081496cce installs=0.19.647 d1fe5dead4202be12a964ab891fd5980e7836170 -->
    Loom-Trace-Id: 2046ffd42f138a06b914f34851de3440
    Loom-Build: unknown 388c7fe0cad997f7a887f70c9f2cfe8781a2d512 clean
    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
2026-10-03 chore: resync installed Loom surfaces
    <!-- loom:provenance v1 build=unknown 8078c29e691123d91cd761a786f99cfd25f1809d clean prompts=none sweep=none story=none trace=45869a6374635c036a11a6f379fe31a4 host=robb-pro base=4d423823f46e36cadec25ce2152564bd789224b0 run=loom-run/v1:timer:robb-pro/fleet-resync:b0a94991-052d-4e7d-ba2b-78b971096849 installs=0.19.647 709ca4396e074e5a4d1c5e19721f6ddac7154ca2 -->
    Loom-Trace-Id: 45869a6374635c036a11a6f379fe31a4
    Loom-Build: unknown 8078c29e691123d91cd761a786f99cfd25f1809d clean
    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
2026-10-03 chore: resync installed Loom surfaces
    <!-- loom:provenance v1 build=unknown f9cba29b0602624a23daa17ae04d31d82e10fa91 clean prompts=none sweep=none story=none trace=754b3688f97b6c34894d8cfbf272b81a host=loom-worker-1 base=06d701459def042759f7e3104d1a44a83c1563af run=loom-run/v1:script:loom-worker-1/fleet-resync:11eb117a-9ff3-4411-88d4-fdd7d6748639 installs=0.19.649 6f2f13b1c31ce420e2250ae040d8e1050c0e761b -->
    Loom-Trace-Id: 754b3688f97b6c34894d8cfbf272b81a
    Loom-Build: unknown f9cba29b0602624a23daa17ae04d31d82e10fa91 clean
    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
2026-10-03 chore: resync installed Loom surfaces
    <!-- loom:provenance v1 build=unknown f9cba29b0602624a23daa17ae04d31d82e10fa91 clean prompts=none sweep=none story=none trace=544a028e3829d4020b8aaa144e5fa628 host=robb-studio base=a6de77ade3e5ec7895d4029a41ee53158734aaab run=loom-run/v1:script:robb-studio/fleet-resync:5b5b8b83-7139-447d-88bd-417dcf375aa6 installs=0.19.649 6f2f13b1c31ce420e2250ae040d8e1050c0e761b -->
    Loom-Trace-Id: 544a028e3829d4020b8aaa144e5fa628
    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
2026-10-03 chore: resync installed Loom surfaces
    <!-- loom:provenance v1 build=unknown f9cba29b0602624a23daa17ae04d31d82e10fa91 clean prompts=none sweep=none story=none trace=1057aaaf811f6dd2d64a3bb6d4b3ac49 host=robb-pro base=c2dcf5fed30fa83f006444cc522230a9a2ae7e5e run=loom-run/v1:timer:robb-pro/fleet-resync:785c1ea0-d7f2-4810-99e9-cd9368aebe0c installs=0.19.649 2118aabb5a925f1ec4669b4d3d31176a46d8f2a6 -->
    Loom-Trace-Id: 1057aaaf811f6dd2d64a3bb6d4b3ac49
    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
2026-10-03 chore: resync installed Loom surfaces
    <!-- loom:provenance v1 build=unknown 72f61d9aa0fe08f1ef59f1a97a314e474455801e clean prompts=none sweep=none story=none trace=577d2185973ec59f059fa15bf5b5e514 host=loom-worker-1 base=30673338840000bc1dda2b46ca40a9bcd4dc9af9 run=loom-run/v1:script:loom-worker-1/fleet-resync:5728a930-137f-4d2f-a962-1cdd7a6a1d46 installs=0.19.652 235a64727b907d65529151af0a962b14f16462a0 -->
    Loom-Trace-Id: 577d2185973ec59f059fa15bf5b5e514
    Loom-Build: unknown 72f61d9aa0fe08f1ef59f1a97a314e474455801e clean
    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
2026-10-03 chore: resync installed Loom surfaces
    <!-- loom:provenance v1 build=unknown 72f61d9aa0fe08f1ef59f1a97a314e474455801e clean prompts=none sweep=none story=none trace=845aaa0eb340f80f12095e2e8b421ed1 host=robb-pro base=5107286c0585f415cf15d99ea9dbe5e4e3c6f669 run=loom-run/v1:script:robb-pro/fleet-resync:344add4b-df8a-49e8-8563-2765673acc76 installs=0.19.652 235a64727b907d65529151af0a962b14f16462a0 -->
    Loom-Trace-Id: 845aaa0eb340f80f12095e2e8b421ed1
    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
2026-10-03 chore: resync installed Loom surfaces
    <!-- loom:provenance v1 build=unknown 21130104346fe9c464ce8a3fdf82c1d3e9667639 clean prompts=none sweep=none story=none trace=36308fff5a3c323c3d1bf6fffb6cd122 host=robb-studio base=1c873e1584aee2d420384b49d2a3fd1685f91438 run=loom-run/v1:timer:robb-studio/fleet-resync:89972fbd-0774-4402-bbb7-26c33a851735 installs=0.19.652 fb69233bd8f1dfc2bdee37d8b934f99274dc0193 -->
    Loom-Trace-Id: 36308fff5a3c323c3d1bf6fffb6cd122
    Loom-Build: unknown 21130104346fe9c464ce8a3fdf82c1d3e9667639 clean
    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
2026-10-04 chore: resync installed Loom surfaces
    <!-- loom:provenance v1 build=unknown 61870b40779d205c1555e801c6e1d95df083cdea clean prompts=none sweep=none story=none trace=fb9213e215442932d2af05f3b14977de host=robb-pro base=bb0db4d37978a249f3070917e8c274ac400e512a run=loom-run/v1:timer:robb-pro/fleet-resync:4c70cd1d-08cd-4add-8e2a-9a75160d163f installs=0.19.655 36c39e3c6f56e1979647ec235b4bd19c77db22f3 -->
    Loom-Trace-Id: fb9213e215442932d2af05f3b14977de
    Loom-Build: unknown 61870b40779d205c1555e801c6e1d95df083cdea clean
    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
2026-10-04 chore: resync installed Loom surfaces
    <!-- loom:provenance v1 build=unknown 61870b40779d205c1555e801c6e1d95df083cdea clean prompts=none sweep=none story=none trace=baa6c2cfcae1a320917c00ff2eb8b630 host=loom-worker-2 base=9e4e97bc89c156fb051c2edc5671e4421657f229 run=loom-run/v1:timer:loom-worker-2/fleet-resync:741a7f0f16df4fb1be4e657aeacd1244 installs=0.19.655 fc667a4faae1227f8a6837431f8a0c2d0aeaa7dd -->
    Loom-Trace-Id: baa6c2cfcae1a320917c00ff2eb8b630
    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
2026-10-04 docs: add erratum for kickback records' hardcoded tt/27C corner prose
    Twelve committed kickback records carry corner-justification prose the
    pre-#81 writer hardcoded for issue #30's single tt/27C re-measurement.
    Append a dated erratum section to sim/comparator-decision/README.md
    listing all twelve by filename: each record's process=/temperature_c=
    fields are authoritative, the 'PVT coverage remains open work' clause
    is superseded by DR-005, and the measured numbers are unaffected.
    Records stay unedited per sim/'s append-only rule.
    Closes #75
    Loom-Story: 2AMLogic/sky130-comparator#75
    Loom-Trace-Id: 2f32d3d84a960a5223ea114f773f4fde
    Loom-Build: 0.19.652 235a64727b907d65529151af0a962b14f16462a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
2026-10-04 chore: resync installed Loom surfaces
    <!-- loom:provenance v1 build=unknown b922acb2ac655cbccd71daa9e3f05a325a094ca5 clean prompts=none sweep=none story=none trace=833eeb34d4ca65c3f8c6f7824ddca3a3 host=robb-studio base=eac0d4e9ea4c323c0b3f28e1054e05954e176a98 run=loom-run/v1:timer:robb-studio/fleet-resync:0d44f6dc-6a62-4d43-b49d-7cfdd7dbd823 installs=0.19.663 0a51e373e7fe1be156c5774b2c827d4b745368a3 -->
    Loom-Trace-Id: 833eeb34d4ca65c3f8c6f7824ddca3a3
    Loom-Build: unknown b922acb2ac655cbccd71daa9e3f05a325a094ca5 clean
    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
2026-10-04 chore: resync installed Loom surfaces
    <!-- loom:provenance v1 build=unknown 746ecb5f9d7e64ba1d2526f1e997530ad4f3dd43 clean prompts=none sweep=none story=none trace=f09501431241df2ec5688e334ba43dfe host=loom-worker-2 base=188e26249ff688df22081fd2863c246e46db3bac run=loom-run/v1:timer:loom-worker-2/fleet-resync:70797dad61fb4e21806716d54f1ce910 installs=0.19.669 59a1f84e3742827a8033bb153ebbedc1759bee72 -->
    Loom-Trace-Id: f09501431241df2ec5688e334ba43dfe
    Loom-Build: unknown 746ecb5f9d7e64ba1d2526f1e997530ad4f3dd43 clean
    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
2026-10-04 chore: resync installed Loom surfaces
    <!-- loom:provenance v1 build=unknown 8080d0485cc1312129ee642b084944c56d1be074 clean prompts=none sweep=none story=none trace=ed180bcab6828041123ad54d8ddb4037 host=robb-pro base=18795b0f8347130a886cbcb3a07ecab45507209e run=loom-run/v1:timer:robb-pro/fleet-resync:e97b2f08-4ad9-4b66-a166-5b19820e2d1f installs=0.19.669 59a1f84e3742827a8033bb153ebbedc1759bee72 -->
    Loom-Trace-Id: ed180bcab6828041123ad54d8ddb4037
    Loom-Build: unknown 8080d0485cc1312129ee642b084944c56d1be074 clean
    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
2026-10-04 chore: resync installed Loom surfaces
    <!-- loom:provenance v1 build=unknown 83cb6647167ffc000d2c2f479b4e816b68f863f4 clean prompts=none sweep=none story=none trace=ccabffa1e1ba495895b262086030816c host=robb-studio base=379bfec3da23f415a073287afd17759a1c90ac1e run=loom-run/v1:timer:robb-studio/fleet-resync:88a78f1f-d978-47b5-99c3-2aabde811d17 installs=0.19.676 cd4f30bd892ea2595d8218b08150633504b0dd14 -->
    Loom-Trace-Id: ccabffa1e1ba495895b262086030816c
    Loom-Build: unknown 83cb6647167ffc000d2c2f479b4e816b68f863f4 clean
    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
2026-10-04 chore: resync installed Loom surfaces
    <!-- loom:provenance v1 build=unknown 32174d0f7e80508fa66c1a11a2c0fb28c515607e clean prompts=none sweep=none story=none trace=436d7c19b10cd5807625a7ce7190a82f host=loom-worker-2 base=b18eb63fd232ac0c10dc3d4ad9738cc5b29fbd77 run=loom-run/v1:timer:loom-worker-2/fleet-resync:19ae50771cc04d8db7b1403c1e66bbea installs=0.19.682 9eccfa110fa294fa32a62ffe8eff669cfcf1a3a6 -->
    Loom-Trace-Id: 436d7c19b10cd5807625a7ce7190a82f
    Loom-Build: unknown 32174d0f7e80508fa66c1a11a2c0fb28c515607e clean
    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
2026-10-04 chore: resync installed Loom surfaces
    <!-- loom:provenance v1 build=unknown 72290fa960e0773b2c50d74042e24914c7327637 clean prompts=none sweep=none story=none trace=f7b6952a649a174398a48b90b6ab4793 host=robb-pro base=61928063338b7cd381f1d6a90e53635fec7a280c run=loom-run/v1:timer:robb-pro/fleet-resync:72f32482-5cc4-4b38-ab9e-4d2ef0b64e94 installs=0.19.684 bdb8fb331eb51c7def4cdd2c38b611af06f25f6d -->
    Loom-Trace-Id: f7b6952a649a174398a48b90b6ab4793
    Loom-Build: unknown 72290fa960e0773b2c50d74042e24914c7327637 clean
    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
2026-10-04 chore: resync installed Loom surfaces
    <!-- loom:provenance v1 build=unknown 76cda58637be0e74c4cb5b4c8dbc2000e2a9c3d4 clean prompts=none sweep=none story=none trace=614cbada5ce873c2b34a511816309cfc host=robb-studio base=2af5a7466b6c1f4a8cc3b89f277ebc5fcb2b822b run=loom-run/v1:timer:robb-studio/fleet-resync:7e559a3b-ffdd-409b-8dd2-ae906a273b0a installs=0.19.692 d4974b9f5ff7843a3cfc06378ea2a69bc120e0f4 -->
    Loom-Trace-Id: 614cbada5ce873c2b34a511816309cfc
    Loom-Build: unknown 76cda58637be0e74c4cb5b4c8dbc2000e2a9c3d4 clean
    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
2026-10-04 chore: resync installed Loom surfaces
    <!-- loom:provenance v1 build=unknown f84bac5c232c093f83c1adc2533d8c75b021cda2 clean prompts=none sweep=none story=none trace=e687830614e4bd1c551ab6cf6186f8f3 host=loom-worker-2 base=cd12d469461406729875c5951a98042917ff3e06 run=loom-run/v1:timer:loom-worker-2/fleet-resync:2db2c4373ac24de1b7a364e69eaea1ca installs=0.19.695 b0d5b09f207fda439390ea1dd249ad10e7009dfc -->
    Loom-Trace-Id: e687830614e4bd1c551ab6cf6186f8f3
    Loom-Build: unknown f84bac5c232c093f83c1adc2533d8c75b021cda2 clean
    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
2026-10-04 chore: resync installed Loom surfaces
    <!-- loom:provenance v1 build=unknown ac5c275d1c616a9723e747f5a66de93dc80d3512 clean prompts=none sweep=none story=none trace=c777c3912bd31972e9aa3ccab712ae01 host=loom-worker-1 base=a2cc1bd991461e05e2f1160fc4479aa2dff434a0 run=loom-run/v1:script:loom-worker-1/fleet-resync:b51a1b33-4958-4408-be36-166e12e8360b installs=0.19.697 ada83a5c7ff66b56b0060ef0be368c9fe56eb3c6 -->
    Loom-Trace-Id: c777c3912bd31972e9aa3ccab712ae01
    Loom-Build: unknown ac5c275d1c616a9723e747f5a66de93dc80d3512 clean
    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
2026-10-04 chore: resync installed Loom surfaces
    <!-- loom:provenance v1 build=unknown a19f642f5c09599c4c64827d81d228eb031be73e clean prompts=none sweep=none story=none trace=34a80e22764eb5055e37faec0eaf65fb host=robb-pro base=9167302ad78211b2cde8a8bffe360e2a91f3144e run=loom-run/v1:script:robb-pro/fleet-resync:689be620-3ff2-4ff5-a2ce-f6825f6379e2 installs=0.19.698 aa619a1d07e36e8d90ac01fea63dc39285c93567 -->
    Loom-Trace-Id: 34a80e22764eb5055e37faec0eaf65fb
    Loom-Build: unknown a19f642f5c09599c4c64827d81d228eb031be73e clean
    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
2026-10-04 chore: resync installed Loom surfaces
    <!-- loom:provenance v1 build=unknown 693bdd794cb34afdefd7f0c4596824cd53078a61 clean prompts=none sweep=none story=none trace=7e7be58c80b40f1ac882b00139fb0ca0 host=robb-pro base=cf6106ef2df3a1c22b189dc67180a289af0aada3 run=loom-run/v1:timer:robb-pro/fleet-resync:d64fbd6b-5d9b-491d-9e17-742b375bfba7 installs=0.19.698 b814428b8333c69174c977498d1d2db6bce3145c -->
    Loom-Trace-Id: 7e7be58c80b40f1ac882b00139fb0ca0
    Loom-Build: unknown 693bdd794cb34afdefd7f0c4596824cd53078a61 clean
    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
2026-10-04 chore: resync installed Loom surfaces
    <!-- loom:provenance v1 build=unknown 693bdd794cb34afdefd7f0c4596824cd53078a61 clean prompts=none sweep=none story=none trace=aa18f1ec102a98d77ffc51c9be6ffbb3 host=robb-studio base=b6f299d2a0ef5339d437a08232946c193a2d9cf9 run=loom-run/v1:script:robb-studio/fleet-resync:3cb89ca8-62c2-4a69-8434-c4aaa3b64eaf installs=0.19.698 a58f00e0681c50d6bfc5089d0af4b3715198319f -->
    Loom-Trace-Id: aa18f1ec102a98d77ffc51c9be6ffbb3
    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
2026-10-04 chore: resync installed Loom surfaces
    <!-- loom:provenance v1 build=unknown 7a41c2e69ef89d60ed3bd190b94838021bf18d0f clean prompts=none sweep=none story=none trace=d0f04f38b507d85402723643fcf47197 host=loom-worker-1 base=77b95b92cefab0c9f94c11a91d897ada8f2274ba run=loom-run/v1:script:loom-worker-1/fleet-resync:8fdc8c1c-f844-4c33-bc80-b424e5b4cf3d installs=0.19.703 89d5a428c652f957d7fad8a546589042d39911bc -->
    Loom-Trace-Id: d0f04f38b507d85402723643fcf47197
    Loom-Build: unknown 7a41c2e69ef89d60ed3bd190b94838021bf18d0f clean
    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
2026-10-05 chore: resync installed Loom surfaces
    <!-- loom:provenance v1 build=unknown ebb37db560de172930e261675a35bd52e429f650 clean prompts=none sweep=none story=none trace=a40e86a64366c7a1e36aea026901334f host=loom-worker-2 base=79b5f4ec45e6ed2c2daacc1564d276c9c339534c run=loom-run/v1:script:loom-worker-2/fleet-resync:90b6cd74-6cc0-4f58-98ee-6ede0ac6f50c installs=0.19.703 f63c3c82e6bf202f2ca7b205b532f681c5ebb2c8 -->
    Loom-Trace-Id: a40e86a64366c7a1e36aea026901334f
    Loom-Build: unknown ebb37db560de172930e261675a35bd52e429f650 clean
    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
2026-10-05 chore: resync installed Loom surfaces
    <!-- loom:provenance v1 build=unknown 7a41c2e69ef89d60ed3bd190b94838021bf18d0f clean prompts=none sweep=none story=none trace=fc04851db12f586b5d58155325131b6e host=robb-studio base=bed25382558446c549fb2365ded6c497ad74fe08 run=loom-run/v1:timer:robb-studio/fleet-resync:a7d5da6f-a896-4d6f-8d00-aebf47f9b266 installs=0.19.703 2ad9a08fb93de4d7dfac9d2b501d12c684c9c2cc -->
    Loom-Trace-Id: fc04851db12f586b5d58155325131b6e
    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
2026-10-05 chore: resync installed Loom surfaces
    <!-- loom:provenance v1 build=unknown cb8e36660fc5806e4a2dd00da566f9f9c3983db8 clean prompts=none sweep=none story=none trace=7204a60bd5a3f591ded7600c65c70f8b host=loom-worker-1 base=3708f2bc56a1567338d94a2a3f963a00ad23c77a run=loom-run/v1:timer:loom-worker-1/fleet-resync:56bb48518cc6419f93ee5a1c8f149528 installs=0.19.703 972fe7321be6a9efe2653579379ea3bc40b899b2 -->
    Loom-Trace-Id: 7204a60bd5a3f591ded7600c65c70f8b
    Loom-Build: unknown cb8e36660fc5806e4a2dd00da566f9f9c3983db8 clean
    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
2026-10-05 chore: resync installed Loom surfaces
    <!-- loom:provenance v1 build=unknown b44cb904ebb599db793066ccc631c846862abfbd clean prompts=none sweep=none story=none trace=9590fed7c1b1c9f549ccf3cba24292d7 host=robb-pro base=9331123ae84dfebb5670d22526527a43c9c5b5bd run=loom-run/v1:timer:robb-pro/fleet-resync:dbc6174e-403d-422d-98b6-73a4b6dbf44f installs=0.19.708 dc8faf1eae3143feda6301887c303b1ee45db7f4 -->
    Loom-Trace-Id: 9590fed7c1b1c9f549ccf3cba24292d7
    Loom-Build: unknown b44cb904ebb599db793066ccc631c846862abfbd clean
    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
2026-10-05 chore: resync installed Loom surfaces
    <!-- loom:provenance v1 build=unknown 4548905848fcb7cb875c1c0518f2fd88eb65818e clean prompts=none sweep=none story=none trace=aff5e139797705f6fa0811f102ecd103 host=loom-worker-1 base=666600a1fa1904948ee1c3d0fb3d544756fa4273 run=loom-run/v1:timer:loom-worker-1/fleet-resync:ba6a9e5686a64abaa842d71acaeae2ca installs=0.19.718 00d99344506bcf00e1aec7e910abe3d13df2d240 -->
    Loom-Trace-Id: aff5e139797705f6fa0811f102ecd103
    Loom-Build: unknown 4548905848fcb7cb875c1c0518f2fd88eb65818e clean
    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
2026-10-05 chore: resync installed Loom surfaces
    <!-- loom:provenance v1 build=unknown e7efbaa6e7b97a7d72da6032044c67525291f4d1 clean prompts=none sweep=none story=none trace=d74a33a6f35e329b3e795991e790ebfd host=robb-studio base=89d28a76cfbb91eab252f4e0f1094b9a72a98dbc run=loom-run/v1:timer:robb-studio/fleet-resync:304f49c8-5b3e-46a9-a557-945b9ae177f0 installs=0.19.718 00d99344506bcf00e1aec7e910abe3d13df2d240 -->
    Loom-Trace-Id: d74a33a6f35e329b3e795991e790ebfd
    Loom-Build: unknown e7efbaa6e7b97a7d72da6032044c67525291f4d1 clean
    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
2026-10-05 chore: resync installed Loom surfaces
    <!-- loom:provenance v1 build=unknown 347b71e65e709d9fd49aba75d3fb67877fc08818 clean prompts=none sweep=none story=none trace=f9653dd318724c98136e7cef63e551ed host=robb-pro base=7ae573a478a52e61849f8ea4b7ad23392ce46189 run=loom-run/v1:timer:robb-pro/fleet-resync:cdc95970-9fb1-49fa-a0e6-037a3fab2099 installs=0.19.728 991dcebf6f6b2de6571f1d3400bec083498c6438 -->
    Loom-Trace-Id: f9653dd318724c98136e7cef63e551ed
    Loom-Build: unknown 347b71e65e709d9fd49aba75d3fb67877fc08818 clean
    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
2026-10-05 chore: resync installed Loom surfaces
    <!-- loom:provenance v1 build=unknown 5c0d18101f48fecb656f10fa37afa9b09bf41631 clean prompts=none sweep=none story=none trace=ddcf49552af364cbf6e884bd59584c1f host=loom-worker-1 base=a1315f7e452fc38264fbfa6d6455fefa739991b1 run=loom-run/v1:timer:loom-worker-1/fleet-resync:5eb526a05f244f1985770579e7620ff1 installs=0.19.731 7484b71fce5179a025950e71a82855afaf6fd730 -->
    Loom-Trace-Id: ddcf49552af364cbf6e884bd59584c1f
    Loom-Build: unknown 5c0d18101f48fecb656f10fa37afa9b09bf41631 clean
    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
2026-10-05 chore: resync installed Loom surfaces
    <!-- loom:provenance v1 build=unknown 0b160514b6658e3ab26a71c6525791da25b46fcf clean prompts=none sweep=none story=none trace=311c3eb2c0ab9550d3de38df5523f3d7 host=robb-studio base=d235fa637d90267174cd2cfba8fe635270f9e649 run=loom-run/v1:timer:robb-studio/fleet-resync:e6dec631-b42b-4cf2-b854-cc363cfde6e0 installs=0.19.731 d6146becf339a3d4e55e26e8807ac4571213a00b -->
    Loom-Trace-Id: 311c3eb2c0ab9550d3de38df5523f3d7
    Loom-Build: unknown 0b160514b6658e3ab26a71c6525791da25b46fcf clean
    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
2026-10-05 chore: resync installed Loom surfaces
    <!-- loom:provenance v1 build=unknown 5c0d18101f48fecb656f10fa37afa9b09bf41631 clean prompts=none sweep=none story=none trace=f1e8d4c6e73b8eec3e87a8da52e10f2d host=robb-pro base=5cf1e228e08fc848564c91ef847823a75a01df78 run=loom-run/v1:timer:robb-pro/fleet-resync:5518fd33-81cb-479f-93f0-287ea4b08876 installs=0.19.733 4e67131ce3a1317d8cb8904ec342541cc2f45665 -->
    Loom-Trace-Id: f1e8d4c6e73b8eec3e87a8da52e10f2d
    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
2026-10-05 chore: resync installed Loom surfaces
    <!-- loom:provenance v1 build=unknown ca170d11544ef499cc9500a45bbad152edacfbd1 clean prompts=none sweep=none story=none trace=6dcfc713b6a851b40932158c2eeb70af host=loom-worker-3 base=bcb591cc671de7eecd7fda39613df0eaff018c8d run=loom-run/v1:timer:loom-worker-3/fleet-resync:20ce0908ea5a468a9e055470104047ed installs=0.19.734 7ba6ea50c36dfdd2b5e2922dd22c65560980a5a2 -->
    Loom-Trace-Id: 6dcfc713b6a851b40932158c2eeb70af
    Loom-Build: unknown ca170d11544ef499cc9500a45bbad152edacfbd1 clean
    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
2026-10-05 chore: resync installed Loom surfaces
    <!-- loom:provenance v1 build=unknown 03f1c42302d15f8a83425a84a4e36ca484f3f625 clean prompts=none sweep=none story=none trace=f1bc879f8aa652d550764ffcd36e27d1 host=loom-worker-1 base=803b0c2a7b636e4706ffd1c2cb8c38dc5be03194 run=loom-run/v1:timer:loom-worker-1/fleet-resync:f302a3cc8558413492093df510b02418 installs=0.19.734 967abe71d019ce6606018b4e57dee0223b84d96f -->
    Loom-Trace-Id: f1bc879f8aa652d550764ffcd36e27d1
    Loom-Build: unknown 03f1c42302d15f8a83425a84a4e36ca484f3f625 clean
    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
2026-10-05 chore: resync installed Loom surfaces
    <!-- loom:provenance v1 build=unknown ce7557ba58624d48fedbca2bc037dfa8ce3943e7 clean prompts=none sweep=none story=none trace=e1f2558834c47835cd9a53ec8c9a2ffa host=loom-worker-3 base=256d4c842ff9d24d23fec7296a18ab0b667a0cf2 run=loom-run/v1:timer:loom-worker-3/fleet-resync:50f5f0046e2c4890961b3221bd360247 installs=0.19.734 ba9edb650872e5265eaca0c47f75e3cb828ecad2 -->
    Loom-Trace-Id: e1f2558834c47835cd9a53ec8c9a2ffa
    Loom-Build: unknown ce7557ba58624d48fedbca2bc037dfa8ce3943e7 clean
    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
2026-10-05 chore: resync installed Loom surfaces
    <!-- loom:provenance v1 build=unknown f92eaec38470a7b0732e065f4864faec9a1905d6 clean prompts=none sweep=none story=none trace=07aa020a8179d52651250562e9808b98 host=robb-studio base=85d80550388056e8dc99ae41ff7e49db9e1495f7 run=loom-run/v1:timer:robb-studio/fleet-resync:3b3ebdf2-b5f7-48ed-b7bb-5fb945094061 installs=0.19.734 78f3e99c44d0af6d4598adf7577bb6676baf3e8f -->
    Loom-Trace-Id: 07aa020a8179d52651250562e9808b98
    Loom-Build: unknown f92eaec38470a7b0732e065f4864faec9a1905d6 clean
    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
2026-10-06 chore: resync installed Loom surfaces
    <!-- loom:provenance v1 build=unknown ca170d11544ef499cc9500a45bbad152edacfbd1 clean prompts=none sweep=none story=none trace=fca9c14d74d6d634726f5823c51bc62a host=loom-worker-2 base=a2482d03c3e1e11255904e2ee9a4dba9898223b1 run=loom-run/v1:timer:loom-worker-2/fleet-resync:23a23f0878c1494cb720941baddfea81 installs=0.19.741 3cede3920c6b567d5400789187a904970d46b0fb -->
    Loom-Trace-Id: fca9c14d74d6d634726f5823c51bc62a
    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
2026-10-06 chore: resync installed Loom surfaces
    <!-- loom:provenance v1 build=unknown e38a22941348fd8e83d1f4b06130d2a214adfb50 clean prompts=none sweep=none story=none trace=a7fe3a9a1fedfce89846c20f2e98ac31 host=robb-pro base=a59008382eebfcfc0610c00d8de16698c6d06992 run=loom-run/v1:timer:robb-pro/fleet-resync:2d770a42-f0e7-4695-abfa-b912e75382e6 installs=0.19.744 8bc5bcce93c4d9721817387afe8b4b6d79f26054 -->
    Loom-Trace-Id: a7fe3a9a1fedfce89846c20f2e98ac31
    Loom-Build: unknown e38a22941348fd8e83d1f4b06130d2a214adfb50 clean
    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
2026-10-06 chore: resync installed Loom surfaces
    <!-- loom:provenance v1 build=unknown f66ea90ff1bdec51aa4c8dc3f4b2e8d26e3dfd2d clean prompts=none sweep=none story=none trace=66d96c3bb00b04fae967865ee02fc4de host=loom-worker-3 base=cd916362a19d55ca20a0b3b3f1f62930bf95cd45 run=loom-run/v1:timer:loom-worker-3/fleet-resync:eb2dceb410e848a19d58f96f678c995e installs=0.19.749 6135634b053dc30ef5aa8e6d733bfe79bb2ac734 -->
    Loom-Trace-Id: 66d96c3bb00b04fae967865ee02fc4de
    Loom-Build: unknown f66ea90ff1bdec51aa4c8dc3f4b2e8d26e3dfd2d clean
    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
2026-10-06 chore: resync installed Loom surfaces
    <!-- loom:provenance v1 build=unknown ade8a2c60cc8370d04d72f331141acb6fb32e121 clean prompts=none sweep=none story=none trace=6245fb88b5bdf9f7ccecb6b2168dc335 host=robb-studio base=9164a8443b47f5e71398136cfb8dbaceed0029ca run=loom-run/v1:timer:robb-studio/fleet-resync:b305aed2-1a25-4576-aca7-9b017ac4377e installs=0.19.755 8d97d322e1cb3723988504337089beca73d0511c -->
    Loom-Trace-Id: 6245fb88b5bdf9f7ccecb6b2168dc335
    Loom-Build: unknown ade8a2c60cc8370d04d72f331141acb6fb32e121 clean
    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
2026-10-06 chore: resync installed Loom surfaces
    <!-- loom:provenance v1 build=unknown 2489bb7d5203844b3fbe8efbe007f44aa074685d clean prompts=none sweep=none story=none trace=0b5c9263a55c09e6fbd870b2d9ff5d9b host=loom-worker-2 base=c32cbc66672c2ffb9b733105bd7c4f43649ed729 run=loom-run/v1:timer:loom-worker-2/fleet-resync:d3f5a5beb1144f72ac8be575767b3e03 installs=0.19.760 3a509582b179d91c2d5b5a65a7ba4650c3c08985 -->
    Loom-Trace-Id: 0b5c9263a55c09e6fbd870b2d9ff5d9b
    Loom-Build: unknown 2489bb7d5203844b3fbe8efbe007f44aa074685d clean
    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
2026-10-06 chore: resync installed Loom surfaces
    <!-- loom:provenance v1 build=unknown 986d16b700174622774ff68af4ef323e8d0e23ba clean prompts=none sweep=none story=none trace=cb518f1f5785c258556383940a46c461 host=loom-worker-1 base=7a7ac0432904f9fc8afcff251aa922cf2294f9b5 run=loom-run/v1:timer:loom-worker-1/fleet-resync:97df92c5eca846de85e979810663a94b installs=0.19.765 c6cec65c4f320f11153c72e840e49a5d6a6f1afc -->
    Loom-Trace-Id: cb518f1f5785c258556383940a46c461
    Loom-Build: unknown 986d16b700174622774ff68af4ef323e8d0e23ba clean
    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
2026-10-06 chore: resync installed Loom surfaces
    <!-- loom:provenance v1 build=unknown 31b34ebfd7d4539094523eaa7b56a104bebe5fc0 clean prompts=none sweep=none story=none trace=16fac36f144dc183c71465eb36c89afc host=loom-worker-3 base=bd99b9c0cb4853e67ec89fa60a0d22b250b4570f run=loom-run/v1:timer:loom-worker-3/fleet-resync:c763e24590314b918c8ee8df5d2de1db installs=0.19.769 af995a5725fdadf708127f006aa8f248b482d7d7 -->
    Loom-Trace-Id: 16fac36f144dc183c71465eb36c89afc
    Loom-Build: unknown 31b34ebfd7d4539094523eaa7b56a104bebe5fc0 clean
    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
2026-10-06 chore: resync installed Loom surfaces
    <!-- loom:provenance v1 build=unknown 7bed309263b3785eae46a9cbc53b3b24a52b10d2 clean prompts=none sweep=none story=none trace=843adbd5eac450c43d3a2c43da1bf729 host=robb-studio base=da44727a5bfa5d5720d1356edc9a2a46248d05b2 run=loom-run/v1:timer:robb-studio/fleet-resync:f83d5ba4-81f7-479a-9768-6af33d4cc825 installs=0.19.783 a9b459e0c2b1916ceb116db33053e7eb0df57e7b -->
    Loom-Trace-Id: 843adbd5eac450c43d3a2c43da1bf729
    Loom-Build: unknown 7bed309263b3785eae46a9cbc53b3b24a52b10d2 clean
    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
2026-10-06 chore: resync installed Loom surfaces
    <!-- loom:provenance v1 build=unknown 07bc40ba9ab0f7dfe7cd0990377b7ac07a52d220 clean prompts=none sweep=none story=none trace=563f186108419cf03cef002a62c3b201 host=loom-worker-2 base=79cf574a5b397e0247f99b2f855b1d24adbaba9b run=loom-run/v1:timer:loom-worker-2/fleet-resync:944beccd157a4197b81feafdd19f443e installs=0.19.785 2f0a9dbb4f06053f747b8a5615a3519f8e30b527 -->
    Loom-Trace-Id: 563f186108419cf03cef002a62c3b201
    Loom-Build: unknown 07bc40ba9ab0f7dfe7cd0990377b7ac07a52d220 clean
    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
2026-10-06 chore: resync installed Loom surfaces
    <!-- loom:provenance v1 build=unknown 31b34ebfd7d4539094523eaa7b56a104bebe5fc0 clean prompts=none sweep=none story=none trace=ea6600df41a4b420b6d8e967f839ccfd host=loom-worker-3 base=9dda8a61d6f5b00070e1c9ba7dbf209723bbd9c2 run=loom-run/v1:timer:loom-worker-3/fleet-resync:c80415b48fd5404bbd599c4f6cc8a448 installs=0.19.793 7ceff96944c39d33e3c2f1141ca650c2c4c05679 -->
    Loom-Trace-Id: ea6600df41a4b420b6d8e967f839ccfd
    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
2026-10-06 chore: resync installed Loom surfaces
    <!-- loom:provenance v1 build=unknown 596a53e525683919daae1b43e6babe9bf847a02f clean prompts=none sweep=none story=none trace=b9c0cb42a5a72ecc21726229c957ef1f host=loom-worker-2 base=3e52e3774e33fa26b0874c58feef7005cda4cc2f run=loom-run/v1:timer:loom-worker-2/fleet-resync:21d578f5cc0b4b7ba5f10759f5f30ae8 installs=0.19.801 524bdb33cb26c8355454d7550413c89e72c06fae -->
    Loom-Trace-Id: b9c0cb42a5a72ecc21726229c957ef1f
    Loom-Build: unknown 596a53e525683919daae1b43e6babe9bf847a02f clean
    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
2026-10-06 chore: resync installed Loom surfaces
    <!-- loom:provenance v1 build=unknown 40b591a33adb895d4f46977105f9b264d8a2599b clean prompts=none sweep=none story=none trace=e41c725fe0c176312eb412bc69fe5b01 host=robb-studio base=f09714328ec68d8d0d5d6f441c9012ebbe2e3be3 run=loom-run/v1:timer:robb-studio/fleet-resync:37d704dd-4dfd-4341-adb4-6551637ad147 installs=0.19.803 5af82e9a4b23b68166889a3435b7f3ca8161d0e6 -->
    Loom-Trace-Id: e41c725fe0c176312eb412bc69fe5b01
    Loom-Build: unknown 40b591a33adb895d4f46977105f9b264d8a2599b clean
    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
2026-10-06 chore: resync installed Loom surfaces
    <!-- loom:provenance v1 build=unknown 31b34ebfd7d4539094523eaa7b56a104bebe5fc0 clean prompts=none sweep=none story=none trace=5ad0480c4b21b80f9c852c448319e7a1 host=loom-worker-3 base=80582919fd8c9b852bbc87916e812b29a45cb852 run=loom-run/v1:timer:loom-worker-3/fleet-resync:48e836f11f9547ddb96de5aa0d072a05 installs=0.19.810 933f828e779602e492e4e157812988a4b8128111 -->
    Loom-Trace-Id: 5ad0480c4b21b80f9c852c448319e7a1
    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
2026-10-07 chore: resync installed Loom surfaces
    <!-- loom:provenance v1 build=unknown f71cf25de9e75bae6060da4a599df8fbabe75890 clean prompts=none sweep=none story=none trace=64943e35511da4833bbd385cf288be8a host=loom-worker-2 base=17dab5da263ae0fa30be7d097112fac56f817c7a run=loom-run/v1:timer:loom-worker-2/fleet-resync:d69eb1b87d4849ae810a145b1b667d2f installs=0.19.822 1c6969ea8726c800a353c236d9f23456a5706f1a -->
    Loom-Trace-Id: 64943e35511da4833bbd385cf288be8a
    Loom-Build: unknown f71cf25de9e75bae6060da4a599df8fbabe75890 clean
    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
2026-10-07 chore: resync installed Loom surfaces
    <!-- loom:provenance v1 build=unknown 31b34ebfd7d4539094523eaa7b56a104bebe5fc0 clean prompts=none sweep=none story=none trace=cb192cb8f72cf6f2711f73f7ee12bebc host=loom-worker-3 base=e64393184cdfd18cd71208f0097c3cbde6934c1e run=loom-run/v1:timer:loom-worker-3/fleet-resync:c1e385c3607e43ad8bed9c7d29811c66 installs=0.19.830 a966f7b89b714704fa1225b96e2dbee50480a4c6 -->
    Loom-Trace-Id: cb192cb8f72cf6f2711f73f7ee12bebc
    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
2026-10-07 chore: resync installed Loom surfaces
    <!-- loom:provenance v1 build=unknown 8abdd34fddc879aff407380278baa713eca6b758 clean prompts=none sweep=none story=none trace=ea945665dad5ccb3880de51c4448e8b9 host=robb-pro base=47fe6c6d6808fcc4edf41cc61b251940fc681127 run=loom-run/v1:timer:robb-pro/fleet-resync:1466e397-b80c-46ea-a42c-26a7fbd4e00e installs=0.19.831 61814c9c1912925cdff7418842ff3ea17cd56fe4 -->
    Loom-Trace-Id: ea945665dad5ccb3880de51c4448e8b9
    Loom-Build: unknown 8abdd34fddc879aff407380278baa713eca6b758 clean
    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
2026-10-07 chore: resync installed Loom surfaces
    <!-- loom:provenance v1 build=unknown 628be5bb140bcff803d159201bd61e1b868901b0 clean prompts=none sweep=none story=none trace=093df1dc315c5e78dcccfca9d699d5f5 host=loom-worker-2 base=4c1afb86f43027fe35dabbeb39ee03cbdb7973f4 run=loom-run/v1:timer:loom-worker-2/fleet-resync:0b0ea5e184c0429a9c431fcca6c791ad installs=0.19.832 1a0fc15974bf0575a9155fb8276f7529fc813542 -->
    Loom-Trace-Id: 093df1dc315c5e78dcccfca9d699d5f5
    Loom-Build: unknown 628be5bb140bcff803d159201bd61e1b868901b0 clean
    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
2026-10-07 chore: resync installed Loom surfaces
    <!-- loom:provenance v1 build=unknown 069e3b45d86c08f0d60c8fc2b0096de441e99bdc clean prompts=none sweep=none story=none trace=b1ba9d6b2b581e47827d9c099f717b04 host=loom-worker-1 base=0e7e721a6b64fbd4a8e8eb5064e5a22d9b4844bf run=loom-run/v1:timer:loom-worker-1/fleet-resync:aada8278bd4843bcaecce69fdf91251e installs=0.19.838 e70aa17f8dead31bda49cf044c3fc28119df6e90 -->
    Loom-Trace-Id: b1ba9d6b2b581e47827d9c099f717b04
    Loom-Build: unknown 069e3b45d86c08f0d60c8fc2b0096de441e99bdc clean
    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
2026-10-07 chore: resync installed Loom surfaces
    <!-- loom:provenance v1 build=unknown 31b34ebfd7d4539094523eaa7b56a104bebe5fc0 clean prompts=none sweep=none story=none trace=ef030e94bce76f728497f5927960865f host=loom-worker-3 base=db9506806c57a3e4176da86f78c5855c02742471 run=loom-run/v1:timer:loom-worker-3/fleet-resync:28ba4284bfa446c888b501714eda0509 installs=0.19.840 59b533a2a1ed5e186fbf8446b5acbe42d7231854 -->
    Loom-Trace-Id: ef030e94bce76f728497f5927960865f
    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
2026-10-07 chore: resync installed Loom surfaces
    <!-- loom:provenance v1 build=unknown bc59c70c3412a87b31a0dbe65cd6abf968744328 clean prompts=none sweep=none story=none trace=766033e4e881801f24971d664c490ea3 host=robb-studio base=edf3eb67ed87aa356295f2890737c91a7b72f23d run=loom-run/v1:timer:robb-studio/fleet-resync:6b3b079a-890e-4a79-9c3a-0b4bb33ff7c4 installs=0.19.840 59b533a2a1ed5e186fbf8446b5acbe42d7231854 -->
    Loom-Trace-Id: 766033e4e881801f24971d664c490ea3
    Loom-Build: unknown bc59c70c3412a87b31a0dbe65cd6abf968744328 clean
    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
2026-10-07 chore: resync installed Loom surfaces
    <!-- loom:provenance v1 build=unknown a068938e7a6c13759bcb3943e408273a3d352257 clean prompts=none sweep=none story=none trace=76bec863c8f6aff2d49b3aa2be128619 host=robb-pro base=5f66b8c1a23e63042c868093b60d7065d12fdd36 run=loom-run/v1:timer:robb-pro/fleet-resync:d9927fc6-ee80-4b6a-ba2b-f13576bd5f9b installs=0.19.847 fcb4e400253cae9c722e568bfd5ec8f0625c5518 -->
    Loom-Trace-Id: 76bec863c8f6aff2d49b3aa2be128619
    Loom-Build: unknown a068938e7a6c13759bcb3943e408273a3d352257 clean
    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
2026-10-07 chore: resync installed Loom surfaces
    <!-- loom:provenance v1 build=unknown 628be5bb140bcff803d159201bd61e1b868901b0 clean prompts=none sweep=none story=none trace=5a6f676b4652a1a750bbce1386c68d06 host=loom-worker-2 base=eb4705e50580e48927e061f744687ee9c07be22d run=loom-run/v1:timer:loom-worker-2/fleet-resync:bd416e653be04ef4b13353430625e379 installs=0.19.850 3bb4bfc90603b6ad65cabca9b3eb42a59f1a9d3a -->
    Loom-Trace-Id: 5a6f676b4652a1a750bbce1386c68d06
    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
2026-10-07 chore: resync installed Loom surfaces
    <!-- loom:provenance v1 build=unknown 40215645df8a13508180b248b44244dc488bb078 clean prompts=none sweep=none story=none trace=29fde30615e6e47f39b41aa314c2c883 host=loom-worker-1 base=763c807c15339387c95cabefa4de27978b6b993f run=loom-run/v1:timer:loom-worker-1/fleet-resync:d1fbedfcc7824ae59233c0ea94dc4650 installs=0.19.853 2889d5ed585b4da0935543cb916381cc03b19746 -->
    Loom-Trace-Id: 29fde30615e6e47f39b41aa314c2c883
    Loom-Build: unknown 40215645df8a13508180b248b44244dc488bb078 clean
    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
2026-10-07 chore: resync installed Loom surfaces
    <!-- loom:provenance v1 build=unknown 31b34ebfd7d4539094523eaa7b56a104bebe5fc0 clean prompts=none sweep=none story=none trace=cdf49c615da3f5ce46e9fcda1a24f787 host=loom-worker-3 base=916e2d176ce967d1e45af120f0997c301dde11ba run=loom-run/v1:timer:loom-worker-3/fleet-resync:cab31e05b8a24df09bc88f53ee3fb501 installs=0.19.857 7a0b529e6f57a79713f6924bf58d8392ff404259 -->
    Loom-Trace-Id: cdf49c615da3f5ce46e9fcda1a24f787
    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
2026-10-07 chore: resync installed Loom surfaces
    <!-- loom:provenance v1 build=unknown 4b44e7c5db0de1d2b5927de7de229120d546aad3 clean prompts=none sweep=none story=none trace=dfa656ee3483a044378501f49d36f812 host=robb-studio base=1846fe5c32f798a3e6386e1533262db2a0ad0501 run=loom-run/v1:timer:robb-studio/fleet-resync:d80d6bc0-eb68-4a07-8226-2d947d328b3a installs=0.19.859 0aefebd79aba8ab33470f1af4b96847fc794bd0d -->
    Loom-Trace-Id: dfa656ee3483a044378501f49d36f812
    Loom-Build: unknown 4b44e7c5db0de1d2b5927de7de229120d546aad3 clean
    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
2026-10-07 chore: resync installed Loom surfaces
    <!-- loom:provenance v1 build=unknown b591c8cf436f0d4aa5870a9bc7cd5f7194e0e778 dirty prompts=none sweep=none story=none trace=6eca4b0c47205457aae7a3d721c17f17 host=robb-pro base=7bf1e3185fa2a80dc8e98d98c34a07e135c1fb85 run=loom-run/v1:timer:robb-pro/fleet-resync:64af20b3-58cb-47f2-b770-117197cb41e9 installs=0.19.864 128a7eba2bb5f7bcf8891ba284b14cb7ebf8dd3d -->
    Loom-Trace-Id: 6eca4b0c47205457aae7a3d721c17f17
    Loom-Build: unknown b591c8cf436f0d4aa5870a9bc7cd5f7194e0e778 dirty
    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
2026-10-07 chore: resync installed Loom surfaces
    <!-- loom:provenance v1 build=unknown b551219fd5b8347113c0cbc79ea416e81c39fa9d clean prompts=none sweep=none story=none trace=5ac7c8c62dad54841e21dd94f0920de3 host=loom-worker-2 base=033ce56fbb3ce071278354bacdb4ac543707ce9d run=loom-run/v1:timer:loom-worker-2/fleet-resync:d10fb10789e94930ab1af368c15a8f8b installs=0.19.864 128a7eba2bb5f7bcf8891ba284b14cb7ebf8dd3d -->
    Loom-Trace-Id: 5ac7c8c62dad54841e21dd94f0920de3
    Loom-Build: unknown b551219fd5b8347113c0cbc79ea416e81c39fa9d clean
    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
2026-10-07 chore: resync installed Loom surfaces
    <!-- loom:provenance v1 build=unknown 90fbd167e4e376894396e651676cf58fc9aa223a clean prompts=none sweep=none story=none trace=196876656e912171b28029ceca9f772d host=loom-worker-1 base=60d3f4c2e80544f53c8b5ba9390d035b632afd0c run=loom-run/v1:timer:loom-worker-1/fleet-resync:7b46720ff3a84a8184f2f2b3bc039260 installs=0.19.868 ee904e1c151bc9cf15b0eb55dfe9d57ad6136cff -->
    Loom-Trace-Id: 196876656e912171b28029ceca9f772d
    Loom-Build: unknown 90fbd167e4e376894396e651676cf58fc9aa223a clean
    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
2026-10-08 chore: resync installed Loom surfaces
    <!-- loom:provenance v1 build=unknown 5a3df331a0612dee585ef905015af01d08e3467f clean prompts=none sweep=none story=none trace=5690fa95febe608e500a46dde8a6ee92 host=loom-worker-2 base=e0254319ac8b5110853a597e3bff353ac9027007 run=loom-run/v1:timer:loom-worker-2/fleet-resync:5c9c35d59b704bff9d8bf096ee7ba7be installs=0.19.876 b16d54e63fbbec4d7f15f13c1f43a5e5b38145ce -->
    Loom-Trace-Id: 5690fa95febe608e500a46dde8a6ee92
    Loom-Build: unknown 5a3df331a0612dee585ef905015af01d08e3467f clean
    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
2026-10-08 chore: resync installed Loom surfaces
    <!-- loom:provenance v1 build=unknown 134eb3ff06c1a86f49a911c6c17464f55e719736 clean prompts=none sweep=none story=none trace=c7df110d490314040dcd1347b2481843 host=loom-worker-1 base=5e3c3abb90311cc531cbba451427007e9479e9c3 run=loom-run/v1:timer:loom-worker-1/fleet-resync:53d0cec2cd61484eb9a0f8fb1f24ac5e installs=0.19.879 c15619905bdd8a24506c3853f45490d26e8f1cad -->
    Loom-Trace-Id: c7df110d490314040dcd1347b2481843
    Loom-Build: unknown 134eb3ff06c1a86f49a911c6c17464f55e719736 clean
    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
2026-10-08 chore: resync installed Loom surfaces
    <!-- loom:provenance v1 build=unknown 8f86de23319d8f6cf049557dcc9cf2e321211d9d clean prompts=none sweep=none story=none trace=17de45f778fbfd714af8afad02c96375 host=loom-worker-3 base=f1b824d01194b17a9b3288d88bc62fc6ed211837 run=loom-run/v1:timer:loom-worker-3/fleet-resync:9e3e5d4a08824de3b7bc02940be2a0da installs=0.19.882 c9f85af3d967986cdd7a3f27e088a16f88712b05 -->
    Loom-Trace-Id: 17de45f778fbfd714af8afad02c96375
    Loom-Build: unknown 8f86de23319d8f6cf049557dcc9cf2e321211d9d clean
    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
2026-10-08 chore: resync installed Loom surfaces
    <!-- loom:provenance v1 build=unknown 4a5fb2b6276e17ff26ee1382acfe2ea7360ebea5 clean prompts=none sweep=none story=none trace=67857e1b7189785825a2dfc70921cf85 host=loom-worker-2 base=c94fdf8840245e32b050b98ee4627e9623486dda run=loom-run/v1:timer:loom-worker-2/fleet-resync:dd6a5f3dceff4d8d8602a07a1dc89c95 installs=0.19.892 ce93e8a919d79a6f027bab268846a52084f9d94e -->
    Loom-Trace-Id: 67857e1b7189785825a2dfc70921cf85
    Loom-Build: unknown 4a5fb2b6276e17ff26ee1382acfe2ea7360ebea5 clean
    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
2026-10-08 chore: resync installed Loom surfaces
    <!-- loom:provenance v1 build=unknown 4642b719c1ebd1e25ab9a120318382d5dee39e24 clean prompts=none sweep=none story=none trace=ccd1e9a8f8444cbe1e3a7875756f6920 host=loom-worker-1 base=ddcfdb98a3bda9d8afbcd5c0468fab08cac3e76f run=loom-run/v1:timer:loom-worker-1/fleet-resync:90a498201f3142e8a28e1df54380a041 installs=0.19.897 d90a0888f37b28cb14f7fe72413a425eb87a6f60 -->
    Loom-Trace-Id: ccd1e9a8f8444cbe1e3a7875756f6920
    Loom-Build: unknown 4642b719c1ebd1e25ab9a120318382d5dee39e24 clean
    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
2026-10-08 chore: resync installed Loom surfaces
    <!-- loom:provenance v1 build=unknown 5684fc8c8ac418d95ad66a002d001eaea1283c9a clean prompts=none sweep=none story=none trace=c864acd3b9a5dbb419fddd8bd2a6283b host=loom-worker-3 base=578f521b87aef463492a82b9a1261a9319f6bfc9 run=loom-run/v1:timer:loom-worker-3/fleet-resync:4771e7c630c34445b7f28539669d76e3 installs=0.19.898 3d55b9a1669c132d130d98f10a292c1325322c30 -->
    Loom-Trace-Id: c864acd3b9a5dbb419fddd8bd2a6283b
    Loom-Build: unknown 5684fc8c8ac418d95ad66a002d001eaea1283c9a clean
    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
2026-10-08 chore: resync installed Loom surfaces
    <!-- loom:provenance v1 build=unknown 04a1189116c7320def7d9ce357d2d9268405ae92 clean prompts=none sweep=none story=none trace=8e55b27fc60ffb045554bd413ad8f3c8 host=robb-pro base=db6c6b907e3f403003c2b3f0cf947fda0a01057f run=loom-run/v1:timer:robb-pro/fleet-resync:83b69005-7c5b-44b3-96f8-33f07bf82f4b installs=0.19.917 d3c1ea3a4c81e01ce5487dc3e4bbdd86534e677e -->
    Loom-Trace-Id: 8e55b27fc60ffb045554bd413ad8f3c8
    Loom-Build: unknown 04a1189116c7320def7d9ce357d2d9268405ae92 clean
    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
2026-10-08 chore: resync installed Loom surfaces
    <!-- loom:provenance v1 build=unknown d2a55ce217b3ad1793611a2c54946676bb55b512 clean prompts=none sweep=none story=none trace=459637e4e8503593bdf58360865a7524 host=robb-pro base=5da88b881e824f2ca0385f8a0b1681ddc48c0051 run=loom-run/v1:timer:robb-pro/fleet-resync:95b3cf92-9cd9-4c36-8bbd-bdcace7c3874 installs=0.19.935 d347079cd0bad2db2c11ee4f0b760f04b2601d21 -->
    Loom-Trace-Id: 459637e4e8503593bdf58360865a7524
    Loom-Build: unknown d2a55ce217b3ad1793611a2c54946676bb55b512 clean
    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
2026-10-09 chore: resync installed Loom surfaces
    <!-- loom:provenance v1 build=unknown 05dba463c5b293d38f0ca071725983862498b3f3 clean prompts=none sweep=none story=none trace=14298316053024bcf5120bff695771ab host=robb-pro base=281c6f77db2f27874e2184a83b45015e21b3a23d run=loom-run/v1:timer:robb-pro/fleet-resync:2f384483-6d77-4ba2-9888-aa1e4b5be36c installs=0.19.954 95a65ddf91931f7ca49cdf73aa15fbb8772954af -->
    Loom-Trace-Id: 14298316053024bcf5120bff695771ab
    Loom-Build: unknown 05dba463c5b293d38f0ca071725983862498b3f3 clean
    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
2026-10-09 feat: pin klt 0.7.0 and restore strict LVS evidence for T1 items 4/11 (#123)
    Draw the three poly resistors at the schematic's 0.35um, compare resistor
    L/W explicitly in the LVS request, re-baseline the coverage probes, refresh
    DRC/LVS/ERC/extraction evidence, and cite items 4 and 11 (4/11 met, T1 not
    awarded). Post-layout sim records are not re-measured; see #125.
    Loom-Story: 2AMLogic/sky130-comparator#123
    Loom-Trace-Id: d39ce413ab97bd82ad409f5a69eb1ea1
    Loom-Build: 0.19.950 72047016af9d66c08f900bb94c642a66dfd75fc5 clean
2026-10-09 chore: resync installed Loom surfaces
    <!-- loom:provenance v1 build=unknown 7f06b288b150f2fe0a4b24c331a9b3ec093d709d clean prompts=none sweep=none story=none trace=a90c217ff3a3bd9e3a30282b8cadc24d host=robb-pro base=e6a668c2cec538d9dbc8af1574c63262b42ff543 run=loom-run/v1:timer:robb-pro/fleet-resync:6e5ec9f3-d6ef-4953-80f7-c93035e2d359 installs=0.19.967 dd15ae12a882a0f00032273ac34015fdcd0f4928 -->
    Loom-Trace-Id: a90c217ff3a3bd9e3a30282b8cadc24d
    Loom-Build: unknown 7f06b288b150f2fe0a4b24c331a9b3ec093d709d clean
    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
2026-10-09 feat: install ratification reviewer trees and correct DR-002/003/004 status (#124)
    Generated ratification/market-key (comparator comp class) and ratification/ee-key
    from upstream generators; audited DR-001..007. Installing reviewers ratifies nothing.
    Loom-Story: 2AMLogic/sky130-comparator#124
    Loom-Trace-Id: 9e8b11463c31c937e606ea6401531eac
    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
2026-10-09 chore: re-pin characterization envelope hashes for DR-002/003/004 Status edits
    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
2026-10-09 docs: refresh stale README status and bootstrap-era phrasing (#130)
    Loom-Story: 2AMLogic/sky130-comparator#130
    Loom-Trace-Id: b4bd4f9e97917d352fff8ea0d9ebb0bb
    Loom-Build: 0.19.972 113c7f31d7d16f75d30c470023e0b65b29b1fe94 clean
2026-10-09 fix: validate nested pins structure in characterization-envelope verify (#135)
    Loom-Story: 2AMLogic/sky130-comparator#135
    Loom-Trace-Id: c72258ef4d25aa814ec240a73c71c786
    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
2026-10-09 chore: resync installed Loom surfaces
    <!-- loom:provenance v1 build=unknown 30c7a7ee2f74a6a2b5bb0f19fd9f049ec8ae8b5c clean prompts=none sweep=none story=none trace=7bc5ba399ff199d049d83d711920a157 host=robb-pro base=61b59f8564e946c80b99973888353d4616e9b688 run=loom-run/v1:timer:robb-pro/fleet-resync:8e237160-c4d0-4ce3-85ac-c96aff5cf221 installs=0.19.982 2bc4cba624b9053535663441e6f0daf08a7acf2e -->
    Loom-Trace-Id: 7bc5ba399ff199d049d83d711920a157
    Loom-Build: unknown 30c7a7ee2f74a6a2b5bb0f19fd9f049ec8ae8b5c clean
    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
2026-10-09 ci: gate sim/ evidence append-only against Git base (#138)
    Loom-Story: 2AMLogic/sky130-comparator#138
    Loom-Trace-Id: d8c9d1bc0055c5c0f19a16eccb01ef9c
    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
2026-10-10 chore: resync installed Loom surfaces
    <!-- loom:provenance v1 build=unknown a7d2b01d8eb7d09e597a4638e5cb3cdd8bab9156 clean prompts=none sweep=none story=none trace=35c1337ee84607e87ba2038523d63198 host=robb-pro base=afb6a6fe2f87c114618f668b79a8b2f9b6ce03a2 run=loom-run/v1:timer:robb-pro/fleet-resync:6bf32a81-6c4a-48c5-a51e-1ad65c6bedfd installs=0.19.1001 03f8f74f6df8788c18457d2cfa4c0ec6e3d54019 -->
    Loom-Trace-Id: 35c1337ee84607e87ba2038523d63198
    Loom-Build: unknown a7d2b01d8eb7d09e597a4638e5cb3cdd8bab9156 clean
    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
2026-10-10 feat(sim): atomic exclusive-create reservation of evidence record ids (#144)
    Loom-Story: 2AMLogic/sky130-comparator#144
    Loom-Trace-Id: 0a014c7f0af1f50fa67de3bb3b182e3f
    Loom-Build: 0.19.1009 8889f7bd1eccfb4bc8239e7f5669b65f9815c30e clean
2026-10-10 chore: resync installed Loom surfaces
    <!-- loom:provenance v1 build=unknown c156f673e072832aaacb4cd1ec65b742e7f45867 clean prompts=none sweep=none story=none trace=9de99c124c651049199abe9a75070dc7 host=robb-pro base=5431914d4c7f08c024d85abdf05052c8abfc4d9e run=loom-run/v1:timer:robb-pro/fleet-resync:f790885c-7154-4b3d-acd9-71fd537cd20b installs=0.19.1010 d1d5fcecb79550fe39658555a4419f98cec060fb -->
    Loom-Trace-Id: 9de99c124c651049199abe9a75070dc7
    Loom-Build: unknown c156f673e072832aaacb4cd1ec65b742e7f45867 clean
    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
2026-10-10 chore: resync installed Loom surfaces
    <!-- loom:provenance v1 build=unknown 52f79668bb5f93c1828b7f1ea4f7013b917b847b clean prompts=none sweep=none story=none trace=7057f3175071f1f6e34b354fab40a0ce host=robb-studio base=661a50f57df4b2bf0d3475836b8bd66d3b0409c6 run=loom-run/v1:timer:robb-studio/fleet-resync:d8918779-1625-4202-b151-71f64465e8cd installs=0.19.1010 d1d5fcecb79550fe39658555a4419f98cec060fb -->
    Loom-Trace-Id: 7057f3175071f1f6e34b354fab40a0ce
    Loom-Build: unknown 52f79668bb5f93c1828b7f1ea4f7013b917b847b clean
    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
2026-10-10 ci: run sim/selftest.sh --require-pdk with a cached ngspice 46 build (#149)
    Loom-Story: 2AMLogic/sky130-comparator#149
    Loom-Trace-Id: e5019909d5f5f17e995517d5dfaceace
    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
2026-10-10 docs: fix stale DR-002-era ratification prose in README (#148)
    Loom-Story: 2AMLogic/sky130-comparator#148
    Loom-Trace-Id: b7c7a1736de602b53550efe22745d221
    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
2026-10-10 chore: resync installed Loom surfaces
    <!-- loom:provenance v1 build=unknown 525fe43b7b1b2a0271084bba444c934a1541a8d8 clean prompts=none sweep=none story=none trace=0d4424bd058cf912b74934ec0e7bf37e host=robb-pro base=89397704018bf2c1497a532f54c5f57900edc402 run=loom-run/v1:timer:robb-pro/fleet-resync:4812047c-8b9b-4da2-a5dc-13e6f6420a04 installs=0.19.1019 0dca83f94fad8edfd754c67832a60a03e165e25d -->
    Loom-Trace-Id: 0d4424bd058cf912b74934ec0e7bf37e
    Loom-Build: unknown 525fe43b7b1b2a0271084bba444c934a1541a8d8 clean
    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
2026-10-10 docs: refresh consumer compatibility record for DR-004/DR-005 (#153)
    Re-read fleet registry and sky130-sar-adc requirements (dated, with revisions);
    separate architectures; each verdict names bound-vs-measurement, evidence stage
    and limits; no current-geometry post-layout claim (pending #125).
    Loom-Story: 2AMLogic/sky130-comparator#153
    Loom-Trace-Id: 66f995f9b2f7b88081aa7c6fb35b7e6b
    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
2026-10-10 chore: resync installed Loom surfaces
    <!-- loom:provenance v1 build=unknown 525fe43b7b1b2a0271084bba444c934a1541a8d8 clean prompts=none sweep=none story=none trace=d4059def94f46d8d158946acddd4d602 host=robb-studio base=30c1c74e7c83f1598399856cc7ab6b3b17829ff7 run=loom-run/v1:timer:robb-studio/fleet-resync:4a4d1995-968e-44c5-b5fe-804b4d477795 installs=0.19.1019 febfc4335d0554865fadbecba718245cd88c6678 -->
    Loom-Trace-Id: d4059def94f46d8d158946acddd4d602
    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
2026-10-10 chore: resync installed Loom surfaces
    <!-- loom:provenance v1 build=unknown 5d5f41d89eef35adf478b92b96af06c6d86d27a6 clean prompts=none sweep=none story=none trace=05d2a40831b35ba1c48afada00c29519 host=robb-pro base=1d7c235974f8572b33d4ea1953db8a072bc36856 run=loom-run/v1:timer:robb-pro/fleet-resync:c58bb82e-a213-439d-b829-04234e141de9 installs=0.19.1029 eeede923872426614b8def90ca3cf6fd0a4ba07e -->
    Loom-Trace-Id: 05d2a40831b35ba1c48afada00c29519
    Loom-Build: unknown 5d5f41d89eef35adf478b92b96af06c6d86d27a6 clean
    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
2026-10-10 chore: resync installed Loom surfaces
    <!-- loom:provenance v1 build=unknown aa536103d6239818bb974a51d2f7f268eff38bad clean prompts=none sweep=none story=none trace=126a1328a3664e2119a0978086db9bea host=robb-studio base=45c56affd8ed4f3ce9fa2b4f9979aa380987c39a run=loom-run/v1:timer:robb-studio/fleet-resync:fbc4e361-e290-4d81-ae3a-8b5fde796815 installs=0.19.1032 13ca937a7d6ba8768c296b0c126f2ce48f5f7ca4 -->
    Loom-Trace-Id: 126a1328a3664e2119a0978086db9bea
    Loom-Build: unknown aa536103d6239818bb974a51d2f7f268eff38bad clean
    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
2026-10-11 chore: resync installed Loom surfaces
    <!-- loom:provenance v1 build=unknown cf08873555e2eb95da295dcbee98b0dc34473381 clean prompts=none sweep=none story=none trace=67fbc483c3ca3e442d7928804c11ff06 host=robb-pro base=62ed55a78895ee890337a3e43310cb9606b90af9 run=loom-run/v1:timer:robb-pro/fleet-resync:e3f97888-2b26-404a-bd47-86fd28a4eced installs=0.19.1042 94310fa533337976dcb44acc594149f694016897 -->
    Loom-Trace-Id: 67fbc483c3ca3e442d7928804c11ff06
    Loom-Build: unknown cf08873555e2eb95da295dcbee98b0dc34473381 clean
    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
2026-10-11 chore: resync installed Loom surfaces
    <!-- loom:provenance v1 build=unknown e91831edf7b55b29d3a2d88e266916fab9ce2563 clean prompts=none sweep=none story=none trace=f72dd67520a2c3802aa0495b80ac65a5 host=robb-studio base=1e2cdddf04299c38644dded27b60b79cc32bb7ef run=loom-run/v1:timer:robb-studio/fleet-resync:91d2434e-eae5-45de-9305-d78c43fc7c7a installs=0.19.1043 1f414afc0388fba3ddd4b792d653b22230c33389 -->
    Loom-Trace-Id: f72dd67520a2c3802aa0495b80ac65a5
    Loom-Build: unknown e91831edf7b55b29d3a2d88e266916fab9ce2563 clean
    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
2026-10-11 chore: resync installed Loom surfaces
    <!-- loom:provenance v1 build=unknown 5ec729b9f7dd55a2082752611e4c4964f49661fb clean prompts=none sweep=none story=none trace=efc2abc8b72538df6d1a6ea9d329603d host=robb-pro base=891cb1be2b26428fc7de74e0aa56ddf64f07fbef run=loom-run/v1:timer:robb-pro/fleet-resync:0d396c06-f26e-423e-97ac-6d3ac04a8e51 installs=0.19.1056 00548a84a9c19f47397258fdc2a1e9cd6780a2dc -->
    Loom-Trace-Id: efc2abc8b72538df6d1a6ea9d329603d
    Loom-Build: unknown 5ec729b9f7dd55a2082752611e4c4964f49661fb clean
    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
2026-10-11 chore: resync installed Loom surfaces
    <!-- loom:provenance v1 build=unknown 745f69d0daad6c23e76cc006720fa4fbeaa3d887 clean prompts=none sweep=none story=none trace=3baabc4a039fd85029fff227a6ae690a host=robb-studio base=8bdb05e0ddc8153c199b8038fd27c1179b597f3b run=loom-run/v1:timer:robb-studio/fleet-resync:3b3207d7-055d-49b5-a387-db375213668d installs=0.19.1062 c555a3d547a07f49d11fefc5b1456b6e28933d7e -->
    Loom-Trace-Id: 3baabc4a039fd85029fff227a6ae690a
    Loom-Build: unknown 745f69d0daad6c23e76cc006720fa4fbeaa3d887 clean
    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
2026-10-11 chore: resync installed Loom surfaces
    <!-- loom:provenance v1 build=unknown b37a005ac1889262fb9e5338f7cff4e9ed4987da clean prompts=none sweep=none story=none trace=25c158d7e9591610b251780caaff1c5f host=robb-pro base=a2d490c4214b4a726efdd109634506b9cd7b3716 run=loom-run/v1:timer:robb-pro/fleet-resync:7f020bca-6920-47f7-a5e4-bbd5c82d9bb8 installs=0.19.1072 29b48db1ead9c4501304e0114a5c33310e1d589f -->
    Loom-Trace-Id: 25c158d7e9591610b251780caaff1c5f
    Loom-Build: unknown b37a005ac1889262fb9e5338f7cff4e9ed4987da clean
    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
2026-10-11 chore: resync installed Loom surfaces
    <!-- loom:provenance v1 build=unknown 81a6b4499cb57b3620785bc1625c300da34f0735 clean prompts=none sweep=none story=none trace=d08bbd290651d7bcbda8b216c0dfbcdf host=robb-studio base=3baad0cf2097edbf2cc5f882f5712546f2ca9ced run=loom-run/v1:timer:robb-studio/fleet-resync:71e05e3d-931c-46b4-b6d2-5f3f992c1e19 installs=0.19.1074 3f77416f918ffc23fb54dccf18d864073f99b142 -->
    Loom-Trace-Id: d08bbd290651d7bcbda8b216c0dfbcdf
    Loom-Build: unknown 81a6b4499cb57b3620785bc1625c300da34f0735 clean
    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
2026-10-12 chore: resync installed Loom surfaces
    <!-- loom:provenance v1 build=unknown ddfb67ccf9a5115d62dd86924613a468b9328f44 clean prompts=none sweep=none story=none trace=772605234b9d8cafd6a4049200f7425c host=robb-pro base=ab96d95e738c4b44bd33d76cb9d6b5ac08f42b2a run=loom-run/v1:timer:robb-pro/fleet-resync:1ef28ffc-0277-424f-9224-7ee6eca46377 installs=0.19.1084 5b1a67d3793386937de5ed625c09ea18fe9b59ed -->
    Loom-Trace-Id: 772605234b9d8cafd6a4049200f7425c
    Loom-Build: unknown ddfb67ccf9a5115d62dd86924613a468b9328f44 clean
    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
2026-10-12 chore: resync installed Loom surfaces
    <!-- loom:provenance v1 build=unknown be358990895362019614bd207bcbe36bc9eeff2c clean prompts=none sweep=none story=none trace=f1dc643b95859c8f26e892ddb5e2c5d7 host=robb-studio base=6cb6da4147f5583b876d5b11ff2c3e962b786724 run=loom-run/v1:timer:robb-studio/fleet-resync:da486ca2-3e94-4a85-abd3-88707942489a installs=0.19.1087 51ac271f990b317a52ebf27cc21f34561e1179fb -->
    Loom-Trace-Id: f1dc643b95859c8f26e892ddb5e2c5d7
    Loom-Build: unknown be358990895362019614bd207bcbe36bc9eeff2c clean
    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
2026-10-12 chore: resync installed Loom surfaces
    <!-- loom:provenance v1 build=unknown a579728c137cc11d08a48b178e0ff9aa21683e72 clean prompts=none sweep=none story=none trace=10832f2750dbcd63f6c6f301a6f4da9b host=loom-worker-2 base=64b8499fd3ec5b8afdce581861cfe7ae161410ed run=loom-run/v1:timer:loom-worker-2/fleet-resync:180f6d5054f0479ab3990b86ab4522a5 installs=0.19.1087 51ac271f990b317a52ebf27cc21f34561e1179fb -->
    Loom-Trace-Id: 10832f2750dbcd63f6c6f301a6f4da9b
    Loom-Build: unknown a579728c137cc11d08a48b178e0ff9aa21683e72 clean
    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
2026-10-12 chore: resync installed Loom surfaces
    <!-- loom:provenance v1 build=unknown a579728c137cc11d08a48b178e0ff9aa21683e72 clean prompts=none sweep=none story=none trace=82d80e44045e300f103e96ed6d25b593 host=loom-worker-1 base=72734004cd5bee8ab0744fe78c98e5948c400987 run=loom-run/v1:timer:loom-worker-1/fleet-resync:ab5740d9049a430196fdee032352282e installs=0.19.1087 d7bd8dfc0ccccc58b8d00d43f0b2835464ac45ab -->
    Loom-Trace-Id: 82d80e44045e300f103e96ed6d25b593
    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
2026-10-12 chore: resync installed Loom surfaces
    <!-- loom:provenance v1 build=unknown 02ecafe7734bf5faa945ce88940589f00eca78e9 clean prompts=none sweep=none story=none trace=5f71c537126994dc4c45179122427514 host=robb-pro base=1f1b751c2b35f1adfaf212e993ff4622ebe09522 run=loom-run/v1:timer:robb-pro/fleet-resync:6293e6da-8a67-45aa-b277-c9ef85ddb810 installs=0.19.1102 aa00a452306c0486bfb9c94a8787cd7893651700 -->
    Loom-Trace-Id: 5f71c537126994dc4c45179122427514
    Loom-Build: unknown 02ecafe7734bf5faa945ce88940589f00eca78e9 clean
    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
2026-10-12 chore: resync installed Loom surfaces
    <!-- loom:provenance v1 build=unknown 5918da96dcd60c9a677a195737c86ea38972d215 clean prompts=none sweep=none story=none trace=49bb7a8942d6a23bf41754ca27ff2368 host=loom-worker-2 base=6e286b7f30344f65b5036a790007897c4c2683ba run=loom-run/v1:timer:loom-worker-2/fleet-resync:2e973f04abd1447d8ee4b696c2e7d2b4 installs=0.19.1108 72427939d156341080a7006ae6fbb5ec96b2368e -->
    Loom-Trace-Id: 49bb7a8942d6a23bf41754ca27ff2368
    Loom-Build: unknown 5918da96dcd60c9a677a195737c86ea38972d215 clean
    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
2026-10-12 chore: resync installed Loom surfaces
    <!-- loom:provenance v1 build=unknown 9885e6bbba36f53328e04be83140734c6eda9f58 clean prompts=none sweep=none story=none trace=72f34c4066d6ca844a10c33035a775bd host=loom-worker-1 base=bce9191e4b61e6925596c847c069865f1bb635a7 run=loom-run/v1:timer:loom-worker-1/fleet-resync:8f5732bc51fd43379e17e0de51e86bae installs=0.19.1108 bf9dc5cd16598e7aa216803f5ee2fe07db81f318 -->
    Loom-Trace-Id: 72f34c4066d6ca844a10c33035a775bd
    Loom-Build: unknown 9885e6bbba36f53328e04be83140734c6eda9f58 clean
    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
2026-10-12 chore: resync installed Loom surfaces
    <!-- loom:provenance v1 build=unknown 01467247f32c59822968bf02d3214d9a3d613452 clean prompts=none sweep=none story=none trace=0e97e9733eef09a33959cf96e6271f40 host=robb-studio base=87f34f07c3122732bf631c6af1a5819c209ba2f6 run=loom-run/v1:timer:robb-studio/fleet-resync:53a4d390-3842-4216-9018-5dced9d0ea17 installs=0.19.1110 d7cfa8f43e6648732f7c50633bac9f555cb8f8dc -->
    Loom-Trace-Id: 0e97e9733eef09a33959cf96e6271f40
    Loom-Build: unknown 01467247f32c59822968bf02d3214d9a3d613452 clean
    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
2026-10-12 chore: resync installed Loom surfaces
    <!-- loom:provenance v1 build=unknown acadc2b4b0e852f2d889ac9dec616e1548705802 clean prompts=none sweep=none story=none trace=a69edb348af7f0e67b3bc77bc33b1bfc host=loom-worker-2 base=13509e9ab9b1ba973c8811e11545fdf35ec8018f run=loom-run/v1:timer:loom-worker-2/fleet-resync:0923627ffda84cf69ec2486475772b10 installs=0.19.1126 7736d1276b6d01778fba3461114c858ef1bf5e2d -->
    Loom-Trace-Id: a69edb348af7f0e67b3bc77bc33b1bfc
    Loom-Build: unknown acadc2b4b0e852f2d889ac9dec616e1548705802 clean
    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
2026-10-12 chore: resync installed Loom surfaces
    <!-- loom:provenance v1 build=unknown 6d6a81bfd0d38dff3dfe3cc6d08965f57d71ab67 clean prompts=none sweep=none story=none trace=53e704452fd9a4802b952dbffcec3017 host=loom-worker-3 base=9f57a400f96c5ce717a889599e6a96919b113e79 run=loom-run/v1:timer:loom-worker-3/fleet-resync:da09a55781444da6865c7c3d6fcf7edb installs=0.19.1127 8f87a12a5f523455804f76d4084cde60dafce8f6 -->
    Loom-Trace-Id: 53e704452fd9a4802b952dbffcec3017
    Loom-Build: unknown 6d6a81bfd0d38dff3dfe3cc6d08965f57d71ab67 clean
    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
2026-10-12 chore: resync installed Loom surfaces
    <!-- loom:provenance v1 build=unknown e53c99fb3a3453071ca76cce4a40b0deee3010a1 clean prompts=none sweep=none story=none trace=5918b7b32b15194bf3b937a473250a05 host=robb-pro base=7cd9d3763b8542925c0aba960df3cad8a0a4aa6a run=loom-run/v1:timer:robb-pro/fleet-resync:164b019c-09a4-43c2-9863-2afd2cd8c928 installs=0.19.1127 587395b09661ba64dfca25b2e42ea7bc20413295 -->
    Loom-Trace-Id: 5918b7b32b15194bf3b937a473250a05
    Loom-Build: unknown e53c99fb3a3453071ca76cce4a40b0deee3010a1 clean
    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
2026-10-12 chore: resync installed Loom surfaces
    <!-- loom:provenance v1 build=unknown 8d832cc8035d4ba07872510416468da0790332cd clean prompts=none sweep=none story=none trace=09a53bf60e96fc30a753caffd1de8c92 host=robb-studio base=315ccbd8563b81f1583898584765eff86ba76f00 run=loom-run/v1:timer:robb-studio/fleet-resync:baf4c30c-65d9-4d4e-a740-f6a80cbb975c installs=0.19.1134 6bde81b9a2c0b5d36d10ba4cedb6a3bb0a564100 -->
    Loom-Trace-Id: 09a53bf60e96fc30a753caffd1de8c92
    Loom-Build: unknown 8d832cc8035d4ba07872510416468da0790332cd clean
    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
2026-10-12 chore: resync installed Loom surfaces
    <!-- loom:provenance v1 build=unknown aa1ed0d7d5499d2705977d971673d919dbbbaf4e clean prompts=none sweep=none story=none trace=2522608826ef5d5e4a88a9667055aeb7 host=loom-worker-2 base=7cb5d16b735eb8514467c24f98383b3c66569120 run=loom-run/v1:timer:loom-worker-2/fleet-resync:8f26b719c712455381744111c50e90b4 installs=0.19.1142 b91ae5d1b5204f499a1abb875a6cf5bffc1d90b1 -->
    Loom-Trace-Id: 2522608826ef5d5e4a88a9667055aeb7
    Loom-Build: unknown aa1ed0d7d5499d2705977d971673d919dbbbaf4e clean
    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
2026-10-12 chore: resync installed Loom surfaces
    <!-- loom:provenance v1 build=unknown a70d97503da52b2d8e12a12bd0cf829303808e95 clean prompts=none sweep=none story=none trace=e0715eac024f885e71456a622107e8bc host=loom-worker-3 base=37afb2d29b6d6cb0916038e85fa0f90c6b60e2e4 run=loom-run/v1:timer:loom-worker-3/fleet-resync:39a9339322d146b1984885e3f76b3e03 installs=0.19.1143 b5a15aa842eb7dd2f2bb09d2ec8af9ed40a1601b -->
    Loom-Trace-Id: e0715eac024f885e71456a622107e8bc
    Loom-Build: unknown a70d97503da52b2d8e12a12bd0cf829303808e95 clean
    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
2026-10-12 chore: resync installed Loom surfaces
    <!-- loom:provenance v1 build=unknown 8b64614d017d6ce7491c3a2ac9da51e5e2901c97 clean prompts=none sweep=none story=none trace=66044c049ba635bcd6a4797c3a77e84b host=robb-pro base=71af5d26c06dafb47456358f0c3a89fe6d8a2e15 run=loom-run/v1:timer:robb-pro/fleet-resync:68f56594-05d0-4cc0-9c07-36263359d698 installs=0.19.1144 9e4381cbbd2386393e44c7a979583252948a3998 -->
    Loom-Trace-Id: 66044c049ba635bcd6a4797c3a77e84b
    Loom-Build: unknown 8b64614d017d6ce7491c3a2ac9da51e5e2901c97 clean
    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
2026-10-13 chore: resync installed Loom surfaces
    <!-- loom:provenance v1 build=unknown e66f00108a9519331aa981da8a01c6569ca623a9 clean prompts=none sweep=none story=none trace=d3e476cf8c03d5ed37f8e146b3632190 host=robb-studio base=e9b9621e93d8c1144fb8081326c229d244e074dc run=loom-run/v1:timer:robb-studio/fleet-resync:1d7ace45-2daf-4c92-a752-67b11e982245 installs=0.19.1148 1448fdfa79ac2dcab7fad6b95b72697b450f2a4a -->
    Loom-Trace-Id: d3e476cf8c03d5ed37f8e146b3632190
    Loom-Build: unknown e66f00108a9519331aa981da8a01c6569ca623a9 clean
    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
2026-10-13 chore: resync installed Loom surfaces
    <!-- loom:provenance v1 build=unknown 98d08ab78cc223361354ee9947d996b1cb914b30 clean prompts=none sweep=none story=none trace=8b73addcdeaa8fbd65998649f42a8c50 host=loom-worker-2 base=aa73b3cc4f865826fbe082b9cbb6e5fc42754ee9 run=loom-run/v1:timer:loom-worker-2/fleet-resync:3bfb13d52fca425f9cfced4541954cb6 installs=0.19.1148 1448fdfa79ac2dcab7fad6b95b72697b450f2a4a -->
    Loom-Trace-Id: 8b73addcdeaa8fbd65998649f42a8c50
    Loom-Build: unknown 98d08ab78cc223361354ee9947d996b1cb914b30 clean
    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
2026-10-13 chore: resync installed Loom surfaces
    <!-- loom:provenance v1 build=unknown cbff4fbf837b06d41a17f2d2e23be806c19ce1df clean prompts=none sweep=none story=none trace=0cd5805094761c972dc958d4a2d69777 host=loom-worker-3 base=55d8d146df14895f1e74de02705acdd5916509d1 run=loom-run/v1:timer:loom-worker-3/fleet-resync:0837bf6b93294c70ad9d20ea2eaefc57 installs=0.19.1148 e675394377a73ec957d90a26c1a208dd62436c74 -->
    Loom-Trace-Id: 0cd5805094761c972dc958d4a2d69777
    Loom-Build: unknown cbff4fbf837b06d41a17f2d2e23be806c19ce1df clean
    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
2026-10-13 chore(loom): disable buildGate for now (pre-PR preflight off)
    Sets buildGate.enabled=false per 2AMLogic/2am#4294 (operator ruling 2026-10-13). The in-session pre-PR gate
    (loom-daemon preflight) has been timing out on loaded hosts and blocking
    correct PRs; it only switches off when no buildGate is enabled. The
    command and timeout are kept so re-enabling is a one-line revert. CI on
    each PR remains the check of record. Note this also disables the
    post-Builder gate, which shares the key.
    Loom-Build: unknown unknown unknown
    Loom-Prompts: unknown unknown
    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
2026-10-13 chore: resync installed Loom surfaces
    <!-- loom:provenance v1 build=unknown d0bfbbc7ac309581d7abe02c4a269c7704010ee0 clean prompts=none sweep=none story=none trace=0ad6d167235000f3b5648cbd63d761ce host=robb-pro base=2f2ae4c8992d5eff6e734e71cc08da7ffb04b34c run=loom-run/v1:timer:robb-pro/fleet-resync:4f7cbe22-40b6-49ff-8811-003ae8577c28 installs=0.19.1151 021b947d121929157cd83df0576e7f2aa12500d7 -->
    Loom-Trace-Id: 0ad6d167235000f3b5648cbd63d761ce
    Loom-Build: unknown d0bfbbc7ac309581d7abe02c4a269c7704010ee0 clean
    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
2026-10-13 chore: resync installed Loom surfaces
    <!-- loom:provenance v1 build=unknown 7916c4043a1b57e97a53bc5c111e74c5038a1091 clean prompts=none sweep=none story=none trace=20b27ffb08c4130dc9836ee8d9d97b97 host=loom-worker-2 base=153e0dfb48b5c6ea7b87db40e1cc08eaaa2c095f run=loom-run/v1:timer:loom-worker-2/fleet-resync:d34532ec625a4162ae8b58dde1a6738f installs=0.19.1151 f7d1deaab02a9c483fce1ced33fadb1af6d86f59 -->
    Loom-Trace-Id: 20b27ffb08c4130dc9836ee8d9d97b97
    Loom-Build: unknown 7916c4043a1b57e97a53bc5c111e74c5038a1091 clean
    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
2026-10-13 chore: resync installed Loom surfaces
    <!-- loom:provenance v1 build=unknown 7916c4043a1b57e97a53bc5c111e74c5038a1091 clean prompts=none sweep=none story=none trace=99a9d442e177e2a14f9fe891925a70a9 host=loom-worker-1 base=e874fab1cc9f31663e47eeb1db627eac367ff432 run=loom-run/v1:timer:loom-worker-1/fleet-resync:c61893183c38452a8cff7a1b196057af installs=0.19.1151 4b221f4d5a5d85f25fe8fd1bac30f1a3f4580967 -->
    Loom-Trace-Id: 99a9d442e177e2a14f9fe891925a70a9
    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
2026-10-13 chore: resync installed Loom surfaces
    <!-- loom:provenance v1 build=unknown ac0bbcf6eda99918e88a0b8893d9762b106a2e45 clean prompts=none sweep=none story=none trace=8597ab8a51d68f9f8ee864fa71904bff host=robb-studio base=13878020c61661411c601ce898e0f85700903d8e run=loom-run/v1:timer:robb-studio/fleet-resync:2ea9dd71-a6b2-4d0c-86aa-859a0728c9b3 installs=0.19.1151 02a5f1c9761dfd36f3e8b3f5329aeaa589dc6e7a -->
    Loom-Trace-Id: 8597ab8a51d68f9f8ee864fa71904bff
    Loom-Build: unknown ac0bbcf6eda99918e88a0b8893d9762b106a2e45 clean
    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
2026-10-13 chore: resync installed Loom surfaces
    <!-- loom:provenance v1 build=unknown 7916c4043a1b57e97a53bc5c111e74c5038a1091 clean prompts=none sweep=none story=none trace=773e9e41a5730d2f79f2381ad2cde068 host=robb-pro base=f2846fa525ac7c6d6c54981ebf270e4e174028f0 run=loom-run/v1:timer:robb-pro/fleet-resync:b7ca0d34-434e-4536-85b9-57adfa603a8d installs=0.19.1151 1ec34f9bb79942506958a3c18a31368f4e065508 -->
    Loom-Trace-Id: 773e9e41a5730d2f79f2381ad2cde068
    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
2026-10-13 chore: resync installed Loom surfaces
    <!-- loom:provenance v1 build=unknown f57244868aa20ef22c18aa8025972184aaea43e4 clean prompts=none sweep=none story=none trace=8e03b78fe6cb43a017c4a4823362ffa7 host=loom-worker-2 base=2f85a95a2eeac9b4b4b43942a5b63a7b5d65933f run=loom-run/v1:timer:loom-worker-2/fleet-resync:eb553d2fc2a54589aa37879f12b18ed5 installs=0.19.1151 a9d9bfc13e966655d6d847cb6876af523bc4a4c4 -->
    Loom-Trace-Id: 8e03b78fe6cb43a017c4a4823362ffa7
    Loom-Build: unknown f57244868aa20ef22c18aa8025972184aaea43e4 clean
    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
2026-10-13 chore: resync installed Loom surfaces
    <!-- loom:provenance v1 build=unknown 6fe43c87955e02019c2bc8dfad4fbd160b89170c clean prompts=none sweep=none story=none trace=49a4590bf54e81899c26d965f682504c host=robb-studio base=2442e44c2b35b14fe8d447c107b786e91f66d9de run=loom-run/v1:timer:robb-studio/fleet-resync:459197b3-0050-4335-893e-e47b638eb819 installs=0.19.1151 4bba3857a22eb3081c693ff4c5953e9ffb74072b -->
    Loom-Trace-Id: 49a4590bf54e81899c26d965f682504c
    Loom-Build: unknown 6fe43c87955e02019c2bc8dfad4fbd160b89170c clean
    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
2026-10-13 chore: resync installed Loom surfaces
    <!-- loom:provenance v1 build=unknown 5dc3a07d084d0ec4034f0782d572925dcad86af7 clean prompts=none sweep=none story=none trace=cbc11657acadf58858409fe543c342e1 host=robb-pro base=378d18bb0f1ccbea9a296c476ed3967e3e263f83 run=loom-run/v1:timer:robb-pro/fleet-resync:be586137-d91e-4e2c-82d6-3164d43aa9de installs=0.19.1152 e5868677680b001441bcaa2db050120412bd3474 -->
    Loom-Trace-Id: cbc11657acadf58858409fe543c342e1
    Loom-Build: unknown 5dc3a07d084d0ec4034f0782d572925dcad86af7 clean
    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
2026-10-13 chore: resync installed Loom surfaces
    <!-- loom:provenance v1 build=unknown 27a266d5a27885323290840d2a837d73fcf4bcc6 clean prompts=none sweep=none story=none trace=e77cdd5477ef6bfc65fba6cc233788e0 host=loom-worker-2 base=f74af4e705de30d51777efa0bcd8af1cc72d0b40 run=loom-run/v1:timer:loom-worker-2/fleet-resync:7fac7d82f298441a91761382ac989183 installs=0.19.1152 a7c20e591a04d4acaeeca29fadd7fa4be7ca3122 -->
    Loom-Trace-Id: e77cdd5477ef6bfc65fba6cc233788e0
    Loom-Build: unknown 27a266d5a27885323290840d2a837d73fcf4bcc6 clean
    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
2026-10-13 chore: resync installed Loom surfaces
    <!-- loom:provenance v1 build=unknown f2b62a2cf576d7d37092147b2281da809f8b5cf5 clean prompts=none sweep=none story=none trace=8adfa75521c72dded43e2932febb6329 host=loom-worker-3 base=885e9a5864ff5239b3d3a99a64f331d4664c2993 run=loom-run/v1:timer:loom-worker-3/fleet-resync:8a8198f8f80e4703bc7365a5e10595e0 installs=0.19.1152 6136698172e16b355f948076c177fc4e4a85cd1e -->
    Loom-Trace-Id: 8adfa75521c72dded43e2932febb6329
    Loom-Build: unknown f2b62a2cf576d7d37092147b2281da809f8b5cf5 clean
    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
2026-10-13 chore: resync installed Loom surfaces
    <!-- loom:provenance v1 build=unknown f2b62a2cf576d7d37092147b2281da809f8b5cf5 clean prompts=none sweep=none story=none trace=c75aa8454d7b0e20ddf41b71641175d6 host=loom-worker-1 base=80e06488c0ed16c3a0f625bbc35a2d712af91daf run=loom-run/v1:timer:loom-worker-1/fleet-resync:0af96cefe4bb43af82d755dbf36e35bf installs=0.19.1152 a473d3b00b1152c5e8eab8ff94d836a06088d6fe -->
    Loom-Trace-Id: c75aa8454d7b0e20ddf41b71641175d6
    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
2026-10-14 chore: resync installed Loom surfaces
    <!-- loom:provenance v1 build=unknown 84d11f248d368cae5e04a2255f6897a406c50089 clean prompts=none sweep=none story=none trace=8e50b4ccc3dc58f709a732f69d58fd44 host=robb-studio base=2d8b4a99c2e1331dfdfe31feeee7a4c023267fc2 run=loom-run/v1:timer:robb-studio/fleet-resync:05c9f3b1-eee2-412f-8996-5fbf02793d9e installs=0.19.1153 d8429a4fabdc955107af1cbc22c548e23eecf9b1 -->
    Loom-Trace-Id: 8e50b4ccc3dc58f709a732f69d58fd44
    Loom-Build: unknown 84d11f248d368cae5e04a2255f6897a406c50089 clean
    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
2026-10-14 feat(sim): forward regeneration ladder as klt sim request, gf180 measure names (#171)
    DR-008 decision record, ladder.json manifest + ladder.py request builder and
    grader, PVT records, positive/negative control tests.
    Loom-Story: 2AMLogic/sky130-comparator#171
    Loom-Trace-Id: 01680f076f4ec2de8635a68e1738d53c
    Loom-Build: 0.19.1157 3e3ff8aa9b674281336009ed9b92693dd038f9e9 clean
2026-10-14 feat(sim): supplemental reverse-polarity regeneration ladder (#170)
    Mirrored HIGH->LOW rungs under ladder.json reverse_ladder, reported never
    scored; forward netlist/fields pinned byte-identical; DR-008 addendum; new
    append-only PVT record with negative control.
    Loom-Story: 2AMLogic/sky130-comparator#170
    Loom-Trace-Id: cdc2acbb7d6cca28e796499abe32b47a
    Loom-Build: 0.19.1159 eda4f971db62b88c66ab797cd0f24f525ffc377a clean
2026-10-15 feat: re-pin open_pdks to f6eeac7 via ciel and verify PDK revision from SOURCES
    The PDK search now reads <variant>/SOURCES ('open_pdks <sha>') as the
    primary provenance signal and treats the ciel path hash as secondary; a
    missing/unreadable SOURCES or a SOURCES/path disagreement fails check-env
    instead of warning. Default PDK root moves to ~/.ciel.
    Loom-Story: 2AMLogic/sky130-comparator#178
    Loom-Trace-Id: 1bd500d75ebcd7a3963974f91dfe30e2
    Loom-Build: 0.19.1166 8a9aad12e32504cea9a7c7d2ed774749c487f875 clean
2026-10-23 feat(sim): store new run evidence in the artifact store, commit only manifest + record
    --record now stages raw ngspice logs and the netlist snapshot in git-ignored
    sim/.work/, puts them with klt artifact put (fail closed before simulating),
    and commits manifests/artifacts/*.manifest.json plus the Markdown record.
    Adds a stdlib manifest gate (check/verify/selftest) wired into t1-signoff.
    Closes #198
2026-10-27 build: move LVS/ERC/extraction producers to klt 0.8.0 and re-measure envelopes
    Drops the klt 0.7.0 side venv, bumps the extract_pex/layout-envelope/CI/doc
    pins, and regenerates the LVS, ERC, parasitic-extraction and item-2 envelopes.
    LVS stays match, ERC stays clean; poly-resistor R values moved.
2026-11-05 fix(layout): widen router metal to clear klt 0.8.0 via enclosure rule and retire the 0.7.0 side venv
    klt 0.8.0 reports 107 composed-DRC violations on the router's via1 landings
    (met1/met2.enclosing_adjacent.via.1): 0.30 um metal gives 0.075 um enclosure
    of a 0.15 um via against the 0.085 um adjacent-edge rule. Set WIRE_UM and
    PAD_UM to 0.32 um, regenerate the GDS and DRC/compose/LVS/ERC/extract/PEX
    evidence under 0.8.0, rebind the signoff manifest hashes, and drop the CI
    side venv and --klt override so the byte-compare runs on the main install.
2026-11-14 sim: run the kickback klt-sim pilot against the extracted DUT
    Repoints issue #211's fleet-proven kickback request pair at
    layout/comparator.pex.spice and runs both legs on the batch fleet, so
    the 0.35 um / klt 0.8.0 extraction finally has a simulated figure and
    #127 has an answer on whether the request route carries an extracted
    DUT. It does: both reports' environment.netlist_closure list the
    fragment at scope "repo".
    New files under sim/comparator-decision/klt-pilot/:
    pex-body-{loaded,ideal}.spice, pex-request-{loaded,ideal}.json,
    report-pex-{loaded,ideal}.json and out-pex-*/ (batch receipt + staged
    deck). The requests differ from the #211 template in two fields only:
    batch.capacity_wait_s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
2026-11-14 sim: express regen decision time as a klt sim crossings request
    Pilot for issue #220: run `regen`'s decision time at 50 mV overdrive on the
    batch fleet as a `klt sim` request and difference it against the committed
    `run.py` schematic baselines.
    The measurement needs no circuit-body change. A `measurements[].crossings`
    entry takes a vector *expression* as its `signal`, so `v(OUTP) - v(OUTN)`
    crossing `0.5*VDD` is expressible against an unmodified `_regen_deck`; zero
    crossings grades as `value: 0` / `pass`, so the opposite-polarity card needs
    no `on_unreached` escape hatch and the report carries no diagnostics.
    Results (one job, two corners, `status: "pass"`): 0.401379 ns at tt/27C
    against b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
2026-11-14 refactor: route check-artifact-manifests selftest through _gate_common.report_cases
    The stored-evidence manifest gate was the only script in scripts/ that did
    not import _gate_common, and it hand-rolled its own 11-line selftest tally.
    That copy had already drifted from the shared convention: it printed
    `ok <case>` / `OK: 10 selftest case(s)` while the other six gates print
    `selftest: ok: <case>` / `selftest: all N cases passed`, so both formats
    landed in the same t1-signoff CI log.
    - add the standard `sys.path.insert` + `from _gate_common import report_cases`
    preamble (and the `pathlib.Path` import it needs)
    - fold the per-case `(exit {got}, want {want})` detail into each case name, as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
2026-11-14 refactor(sim): split the comparator-decision driver into sibling modules
    sim/comparator-decision/run.py was 4331 lines: seven banner-delimited
    experiment sections stacked over a shared preamble, grown 5.7x in seven weeks
    by appending one section per experiment. An agent editing the kickback grader
    loaded all 4331 lines to reach 326 of them.
    Split it along the banners it already had, into sibling modules in the same
    directory, leaving run.py as the CLI:
    _shared.py 771 moved lines -- DUT-provenance switch, extracted-fragment
    parsing and the POST-LAYOUT DECK SURGERY rules, testbench
    constants, record preamble prose, SCHEMATIC_BASELINES, the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
